omerkaraoglu/3D-Print-Annealer/Outputs/3D Model/board.png

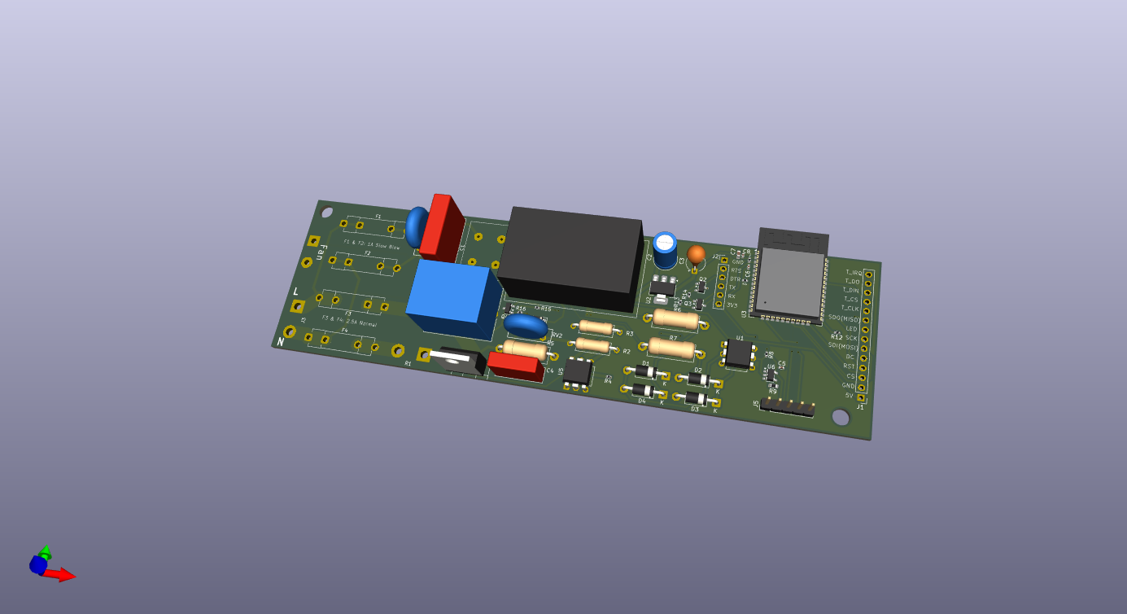
Outputs/3D Model/board.png
