omerkaraoglu/3D-Print-Annealer/CAD/Conceptual/AnnealX-ConceptualSketch.step

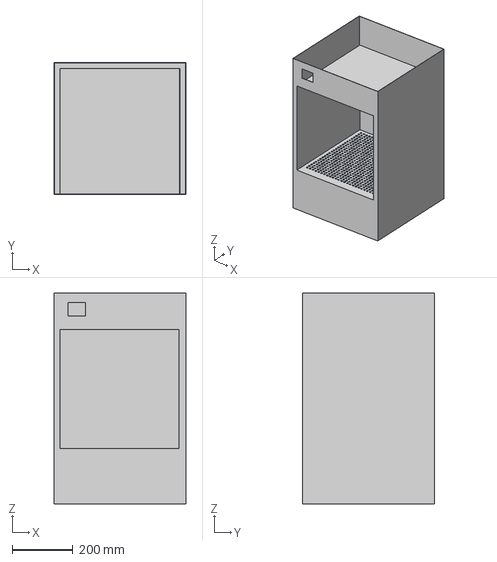
[picture p2: CAD file, 2026-06-10]
CAD/Conceptual/AnnealX-ConceptualSketch.step
432.0 x 432.0 x 692.0 mm
