omerkaraoglu/3D-Print-Annealer/KiCad/ComponentsLibrary/ESP32-C3-MINI-1-N4/ESP32-C3-MINI-1-N4.step

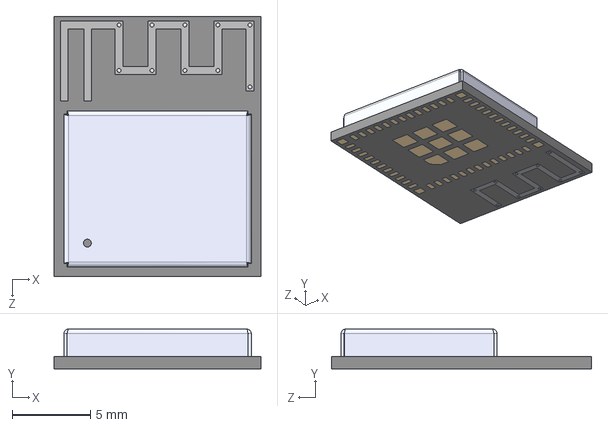
[picture p3: CAD file, 2026-03-03]
KiCad/ComponentsLibrary/ESP32-C3-MINI-1-N4/ESP32-C3-MINI-1-N4.step
13.2 x 2.55 x 16.6 mm
