omerkaraoglu/3D-Print-Annealer/Outputs/3D Model/3D_Model.step

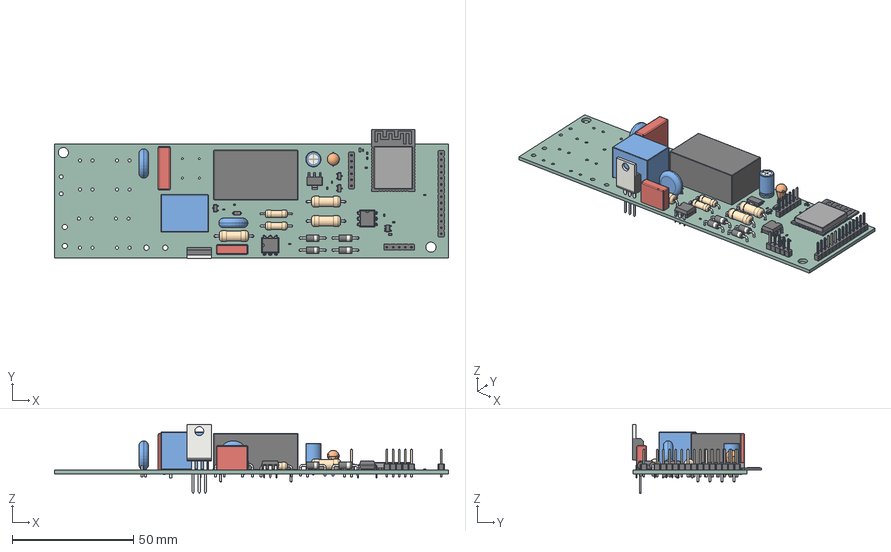
[picture p4: CAD file, 2026-03-04]
Outputs/3D Model/3D_Model.step
162.5 x 53.1 x 28.5 mm
R_0402_1005Metric x 9
PinHeader_1x05_P2.54mm_Vertical
SOT-23
R_Axial_DIN0414_L11.9mm_D4.5mm_P15.24mm_Horizontal x 3
Relay_SPDT_SANYOU_SRD_Series_Form_C
DIP-6_W7.62mm x 2
RV_Disc_D12mm_W3.9mm_P7.5mm x 2
SOT-23-5
D_DO-41_SOD81_P10.16mm_Horizontal x 4
D_SOD-123
C_0402_1005Metric x 3
R_Axial_DIN0309_L9.0mm_D3.2mm_P12.70mm_Horizontal x 2
TO-220-3_Vertical
PinHeader_1x06_P2.54mm_Vertical
SOT-23-3 x 2
ESP32-WROOM-32E
C_Rect_L13.0mm_W4.0mm_P10.00mm_FKS3_FKP3_MKS4
PinHeader_1x14_P2.54mm_Vertical
R_0603_1608Metric
C_0603_1608Metric
CP_Radial_Tantal_D5.0mm_P5.00mm
C_Rect_L18.0mm_W5.0mm_P15.00mm_FKS3_FKP3
Converter_ACDC_Hi-Link_HLK-PMxx
C_Radial_D6.3mm_H11.0mm_P2.50mm
SOT-223
3dFilamentDryer_PCB
