omerkaraoglu/3D-Print-Annealer/KiCad/3dFilamentDryer/3dFilamentDryer.kicad_pcb

## KiCad design KiCad/3dFilamentDryer/3dFilamentDryer.kicad_pcb (2026-06-10)

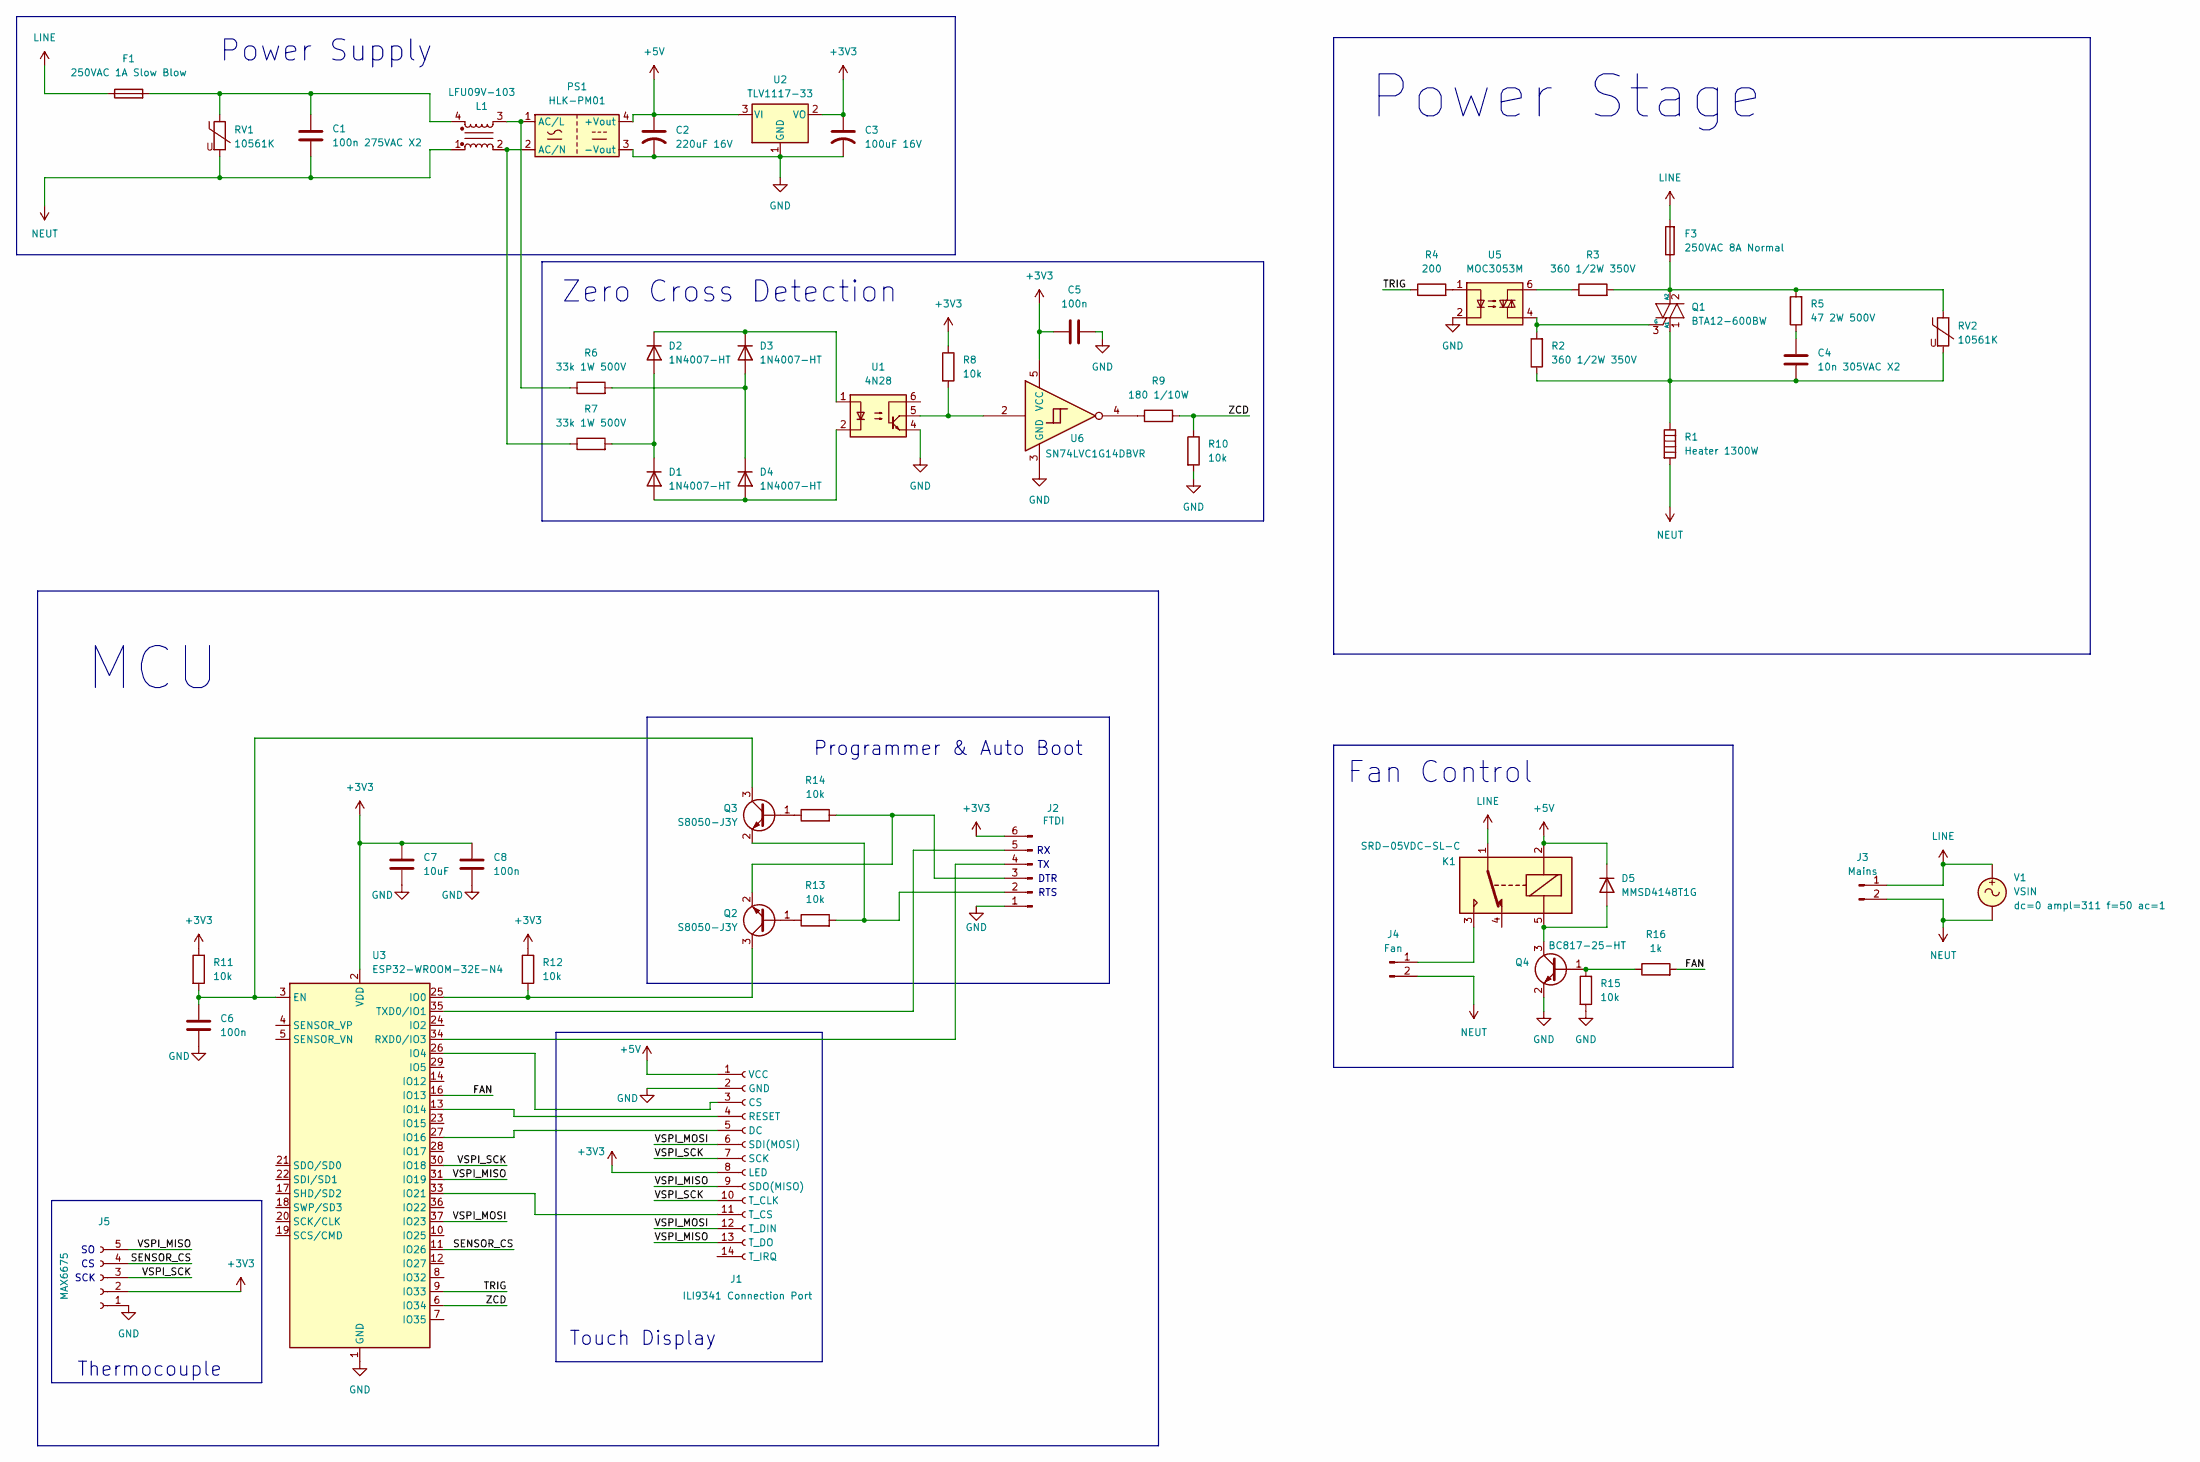
[picture p16: schematic 3dFilamentDryer.kicad_sch, 3D Printer Filament Dryer & Print Annealer]

Parts:
C1: 100n 275VAC X2; C_Rect_L18.0mm_W5.0mm_P15.00mm_FKS3_FKP3
C2: 220uF 16V; C_Radial_D6.3mm_H11.0mm_P2.50mm
C3: 100uF 16V; CP_Radial_Tantal_D5.0mm_P5.00mm
C4: 10n 305VAC X2; C_Rect_L13.0mm_W4.0mm_P10.00mm_FKS3_FKP3_MKS4
C5, C6, C8: 100n; C_0402_1005Metric
C7: 10uF; C_0603_1608Metric
D1, D2, D3, D4: 1N4007-HT; D_DO-41_SOD81_P10.16mm_Horizontal
D5: MMSD4148T1G; D_SOD-123
F1: 250VAC 1A Slow Blow; Fuseholder_Clip-5x20mm_Littelfuse_445-030_Inline_P20.50x5.2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
F3: 250VAC 8A Normal; Fuseholder_Clip-5x20mm_Littelfuse_445-030_Inline_P20.50x5.2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
J1: ILI9341 Connection Port; PinHeader_1x14_P2.54mm_Vertical
J2: FTDI; PinHeader_1x06_P2.54mm_Vertical
J3: Mains; SolderWire-1.5sqmm_1x02_P7.8mm_D1.7mm_OD3.9mm
J4: Fan; SolderWire-0.75sqmm_1x02_P7mm_D1.25mm_OD3.5mm
J5: MAX6675; PinHeader_1x05_P2.54mm_Vertical
K1: SRD-05VDC-SL-C; Relay_SPDT_SANYOU_SRD_Series_Form_C
L1: LFU09V-103
PS1: HLK-PM01; Converter_ACDC_Hi-Link_HLK-PMxx
Q1: BTA12-600BW; TO-220-3_Vertical
Q2, Q3: S8050-J3Y; SOT-23-3
Q4: BC817-25-HT; SOT-23
R1: Heater 1300W; SolderWire-1.5sqmm_1x02_P7.8mm_D1.7mm_OD3.9mm
R2, R3: 360 1/2W 350V; R_Axial_DIN0309_L9.0mm_D3.2mm_P12.70mm_Horizontal
R4: 200; R_0402_1005Metric
R5: 47 2W 500V; R_Axial_DIN0414_L11.9mm_D4.5mm_P15.24mm_Horizontal
R6, R7: 33k 1W 500V; R_Axial_DIN0414_L11.9mm_D4.5mm_P15.24mm_Horizontal
R8, R10, R11, R12, R13, R14, R15: 10k; R_0402_1005Metric
R9: 180 1/10W; R_0603_1608Metric
R16: 1k; R_0402_1005Metric
RV1, RV2: 10561K; RV_Disc_D12mm_W3.9mm_P7.5mm
U1: 4N28; DIP-6_W7.62mm
U2: TLV1117-33; SOT-223-3_TabPin2
U3: ESP32-WROOM-32E-N4; ESP32-WROOM-32E
U5: MOC3053M; DIP-6_W7.62mm
U6: SN74LVC1G14DBVR; SOT-23-5
V1: VSIN

Connections:
+3V3: C3.1, C5.1, C7.1, C8.2, J1.8 (LED), J2.6, J5.2, R8.1, R11.1, R12.1, U2.2 (VO), U3.2 (VDD), U6.5 (VCC)
+5V: C2.1, D5.1 (K), J1.1 (VCC), K1.2, PS1.4 (+Vout), U2.3 (VI)
/FAN: R16.2, U3.16 (IO13)
/SENSOR_CS: J5.4, U3.11 (IO26)
/TRIG: R4.1, U3.9 (IO33)
/VSPI_MISO: J1.9 (SDO(MISO)), J1.13 (T_DO), J5.5, U3.31 (IO19)
/VSPI_MOSI: J1.6 (SDI(MOSI)), J1.12 (T_DIN), U3.37 (IO23)
/VSPI_SCK: J1.7 (SCK), J1.10 (T_CLK), J5.3, U3.30 (IO18)
/ZCD: R9.2, R10.1, U3.6 (IO34)
GND: C2.2, C3.2, C5.2, C6.1, C7.2, C8.1, J1.2 (GND), J2.1, J5.1, PS1.3 (-Vout), Q4.2 (E), R10.2, R15.2, U1.4, U2.1 (GND), U3.1 (GND), U3.15 (GND), U3.38 (GND), U3.39 (GND), U5.2, U6.3 (GND)
LINE: F1.1, F3.2, J3.1, K1.1, V1.1
NEUT: C1.2, J3.2, J4.2, L1.1, R1.2, RV1.2, V1.2
unnamed: C1.1, F1.2, L1.4, RV1.1
unnamed: C4.1, R5.1
unnamed: D1.2 (A), D4.2 (A), U1.2
unnamed: D1.1 (K), D2.2 (A), R7.2
unnamed: D2.1 (K), D3.1 (K), U1.1
unnamed: D3.2 (A), D4.1 (K), R6.2
unnamed: D5.2 (A), K1.5, Q4.3 (C)
unnamed: J1.3 (CS), U3.26 (IO4)
unnamed: J1.5 (DC), U3.27 (IO16)
unnamed: J1.4 (RESET), U3.13 (IO14)
unnamed: J1.11 (T_CS), U3.33 (IO21)
unnamed: J2.2, Q3.2 (E), R13.2
unnamed: J2.3, Q2.2 (E), R14.2
unnamed: J2.4, U3.34 (RXD0/IO3)
unnamed: J2.5, U3.35 (TXD0/IO1)
unnamed: J4.1, K1.3
unnamed: L1.3, PS1.1 (AC/L), R6.1
unnamed: L1.2, PS1.2 (AC/N), R7.1
unnamed: C4.2, Q1.1 (A1), R1.1, R2.1, RV2.2
unnamed: F3.1, Q1.2 (A2), R3.2, R5.2, RV2.1
unnamed: Q1.3 (G), R2.2, U5.4
unnamed: Q2.1 (B), R13.1
unnamed: Q2.3 (C), R12.2, U3.25 (IO0)
unnamed: Q3.1 (B), R14.1
unnamed: C6.2, Q3.3 (C), R11.2, U3.3 (EN)
unnamed: Q4.1 (B), R15.1, R16.1
unnamed: R3.1, U5.6
unnamed: R4.2, U5.1
unnamed: R8.2, U1.5, U6.2
unnamed: R9.1, U6.4

Notes on the sheet:
Power Stage
Programmer & Auto Boot
SCK
RTS
Thermocouple
Power Supply
Touch Display
Fan Control
Zero Cross Detection
MCU
DTR

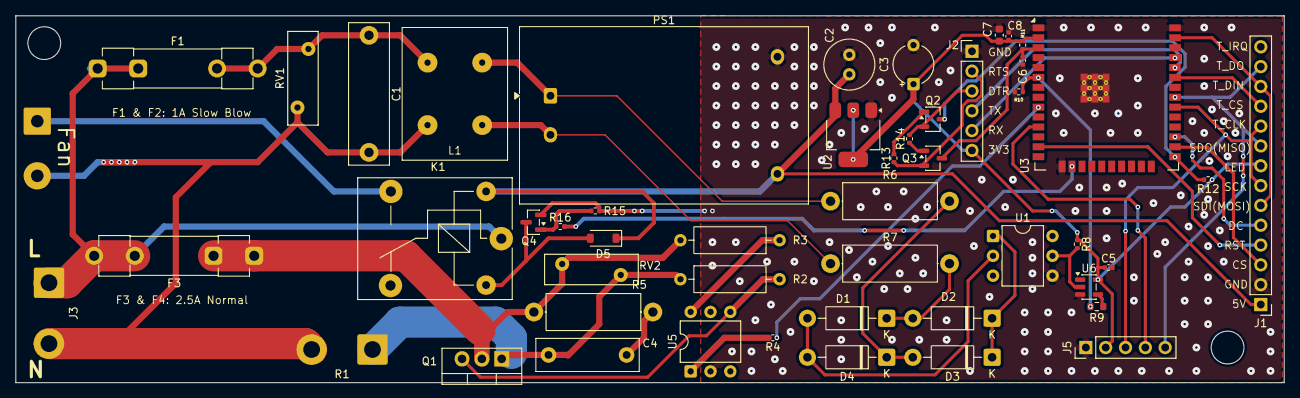
[picture p17: board 3dFilamentDryer.kicad_pcb from above]

Board: 2 copper layers, 162.5 x 47.0 mm, 50 parts (1 on the bottom side), 42 nets.
