omerkaraoglu/3D-Print-Annealer/Firmware/Arduino/AnnealerFirmware/AnnealerFirmware.ino/AnnealerFirmware.ino.ino

/*
 * ══════════════════════════════════════════════════════════════════
 *  Advanced 3D-Print Annealer — Firmware with LVGL Touchscreen UI
 *  ESP32 / Arduino Core 3.x / LVGL v8.4 / TFT_eSPI
 * ══════════════════════════════════════════════════════════════════
 *
 *  Hardware (shared VSPI bus: SCK=18, MOSI=23, MISO=19):
 *    ILI9341 display  CS=15  DC=2  RST=4
 *    XPT2046 touch    CS=21
 *    MAX6675 thermo   CS=13   (SCK+MISO shared)
 *    Triac gate       IO33
 *    ZCD input        IO34
 *
 *  External library configuration required:
 *    - TFT_eSPI/User_Setup.h  : ILI9341, SCK=18, MOSI=23, MISO=19,
 *                               CS=15, DC=2, RST=4
 *    - lvgl/lv_conf.h         : LV_COLOR_DEPTH=16, enable LV_USE_*
 *
 *  The original serial command interface is preserved verbatim
 *  (TUNE / LEARN / SET / RAMP / PROFILE: / LAMBDA / PLANT).
 *  The touchscreen calls the same internal code paths.
 *
 *  Screenshot capture for product photography:
 *    SHOT       — dump the currently-displayed screen over serial.
 *    SHOT ALL   — cycle every built screen, dumping each.
 *    Decode with ../screenshot.py (pyserial + Pillow). See that
 *    file's docstring for the full workflow.
 * ══════════════════════════════════════════════════════════════════ */

#include <SPI.h>
#include <Preferences.h>
#include <TFT_eSPI.h>
#include <lvgl.h>
#include <XPT2046_Touchscreen.h>
#include <WiFi.h>
#include <WiFiClientSecure.h>
#include "esp32_cert_bundle.h"
#include <HTTPClient.h>
#include <HTTPUpdate.h>

LV_FONT_DECLARE(lv_font_inter_12);
LV_FONT_DECLARE(lv_font_inter_14);
LV_FONT_DECLARE(lv_font_inter_16);
LV_FONT_DECLARE(lv_font_inter_24);

// ---- OTA / WiFi configuration -------------------------------------------
// Bump this every time you build a new firmware. The check compares this
// against the "version" field of the server's JSON manifest.
#define FIRMWARE_VERSION   "2.1.2"
// HTTP URL of the version manifest JSON. Plain HTTP is easiest; HTTPS works
// too if you switch to WiFiClientSecure and supply the server's root CA.
// Manifest format: { "version": "1.2.3", "url": "http://host/firmware.bin" }
#define OTA_MANIFEST_URL   "https://omerkaraoglu.github.io/3D-Print-Annealer/Firmware/OTA/version.json"

// We verify TLS using the ESP-IDF certificate bundle that arduino-esp32 v3.x
// links into the firmware. It contains ~150 common root CAs (DigiCert,
// Sectigo / USERTrust, Let's Encrypt / ISRG, GlobalSign, Amazon, …) — so we
// stay valid no matter which CA GitHub rotates to.
//
// The bundle binary is exposed by the build with this exact symbol name.
// If a future arduino-esp32 release renames it the linker will tell us.


// ══════════════════════════════════════════════════════════════════
//   SECTION 1 — PIN DEFINITIONS
// ══════════════════════════════════════════════════════════════════
#define TRIAC_PIN   33
#define ZCD_PIN     34
#define CS_PIN      13          // MAX6675 chip-select
#define FAN_PIN     12          // Fan relay
#define TOUCH_CS    21

#define SCREEN_W    320
#define SCREEN_H    240

// ══════════════════════════════════════════════════════════════════
//   SECTION 2 — HARDWARE OBJECTS
// ══════════════════════════════════════════════════════════════════
TFT_eSPI              tft = TFT_eSPI();
XPT2046_Touchscreen   ts(TOUCH_CS);
Preferences           preferences;

// ══════════════════════════════════════════════════════════════════
//   SECTION 3 — CONTROL GLOBALS (unchanged from original)
// ══════════════════════════════════════════════════════════════════
volatile float pid_output = 0.0;

#define MEDIAN_WINDOW 5
float temp_buffer[MEDIAN_WINDOW];
int   buffer_index = 0;
bool  buffer_filled = false;
float current_temp = 0.0;
const float EMA_ALPHA = 0.1;
unsigned long last_temp_read = 0;
unsigned long last_telemetry_time = 0;

#define SLOPE_WINDOW 60
float temp_history[SLOPE_WINDOW];
int   history_index = 0;
bool  history_filled = false;

#define POWER_BUFFER_SIZE 900
float power_history[POWER_BUFFER_SIZE];
int   power_history_index = 0;

unsigned long last_history_time = 0;
float current_slope = 0.0;
float predicted_temp = 0.0;

#define NCR_LUT_SIZE 37
float ncr_lut_heat[NCR_LUT_SIZE];
float ncr_saved_heat[NCR_LUT_SIZE];
float ncr_lut_cool[NCR_LUT_SIZE];
float ncr_saved_cool[NCR_LUT_SIZE];
float ncr_lin_heat[NCR_LUT_SIZE];
float ncr_lin_cool[NCR_LUT_SIZE];
bool  ncr_nvs_heat[NCR_LUT_SIZE];
bool  ncr_nvs_cool[NCR_LUT_SIZE];

// Raw learned NCR from prototype_1 sweep (20..200 °C, 5 °C steps)
// Buckets without learned data use 0 so linearizeNCR() will interpolate them
static const float NCR_DEFAULT_HEAT[NCR_LUT_SIZE] = {
  0.000000f, 0.000536f, 0.002452f, 0.005874f, 0.003987f, 0.005721f, 0.009235f, 0.010331f,
  0.009895f, 0.012373f, 0.011361f, 0.015502f, 0.011804f, 0.017765f, 0.018578f, 0.022075f,
  0.023933f, 0.019671f, 0.023189f, 0.027764f, 0.022931f, 0.026879f, 0.025739f, 0.027236f,
  0.030697f, 0.032321f, 0.030131f, 0.028257f, 0.031236f, 0.029625f, 0.030799f, 0.032442f,
  0.030475f, 0.032322f, 0.029798f, 0.036016f, 0.000000f,
};
static const float NCR_DEFAULT_COOL[NCR_LUT_SIZE] = {
  0.000000f, 0.007521f, 0.000000f, 0.000000f, 0.000000f, 0.003718f, 0.010883f, 0.010430f,
  0.013222f, 0.013421f, 0.000000f, 0.015848f, 0.017784f, 0.021740f, 0.019994f, 0.000000f,
  0.024905f, 0.000000f, 0.028881f, 0.027218f, 0.000000f, 0.000000f, 0.000000f, 0.000000f,
  0.000000f, 0.000000f, 0.000000f, 0.000000f, 0.000000f, 0.000000f, 0.000000f, 0.000000f,
  0.000000f, 0.000000f, 0.000000f, 0.000000f, 0.000000f,
};

int   ncr_active_bucket = -1;
float ncr_prev_ema = 0.0;
unsigned long ncr_stable_start_ms = 0;

float setpoint = 20.0;
float current_setpoint = 20.0;
float ramp_rate_per_sec = 0.0;
bool  is_ramping = false;

float error_integral = 0.0;
float Kc = 1.0, Ti = 100.0;
bool  flatThresholdFlag = 1;
bool  prev_flat_flag = false;

int   tune_state = 0;
float tune_start_temp = 0.0;
unsigned long tune_start_time_ms = 0;
float temp_at_theta = 0.0;
unsigned long time_at_theta_ms = 0;
float tune_step_power = 0.3;

float mpc_tau_c = 40.0f;         // Desired time constant in seconds. Lower = more aggressive climb.
float mpc_error_integral = 0.0f; // Stores the disturbance correction
float mpc_Ki = 0.005f;           // Very weak gain, strictly for fixing model mismatch at steady-state

int   learn_state = 0;
int   learn_target_bucket = 0;
int   learn_start_bucket = 0;
float learn_room_temp = 20.0;
float learn_stable_temp = 20.0;
unsigned long learn_stable_start_ms = 0;
unsigned long learn_observe_start_ms = 0;
float learn_ncr_snapshot = 0.0;

#define LEARN_OBS_WINDOW 90
float learn_obs_temps[LEARN_OBS_WINDOW];
int   learn_obs_count = 0;
float learn_prev_fitted_slope = 0.0;
unsigned long learn_obs_last_sample_ms = 0;

#define PROFILE_MAX_STEPS 16
struct ProfileStep {
  bool is_ramp;
  float target;
  float rate_per_sec;
  unsigned long hold_sec;
};
ProfileStep profile_steps[PROFILE_MAX_STEPS];
int   profile_step_count = 0;
int   profile_current_step = 0;
int   profile_state = 0;
unsigned long profile_hold_start_ms = 0;
// For the final cooldown step: time at which current_temp first entered the
// 20–40 °C "ambient" band while still waiting for arrival. Reset to 0 the
// instant it leaves the band. Once 30 min in-band has elapsed we accept
// that the oven won't cool any further and declare the step complete.
unsigned long profile_ambient_stable_since_ms = 0;
#define PROFILE_AMBIENT_BAND_LO  20.0f
#define PROFILE_AMBIENT_BAND_HI  40.0f
#define PROFILE_AMBIENT_WAIT_MS  (30UL * 60UL * 1000UL)
unsigned long profile_start_ms = 0;
unsigned long profile_plot_last_ms = 0;

float plant_K = 0.0;
float plant_tau = 0.0;
float plant_theta = 0.0;
float lambda_val = 3.0;

// ══════════════════════════════════════════════════════════════════
//   SECTION 4 — UI GLOBALS + COLOR PALETTE
// ══════════════════════════════════════════════════════════════════
// Themed-button role (declared here so Arduino's auto-generated
// prototypes at the top of the .ino can see the type).
enum BtnRole { ROLE_PRIMARY, ROLE_SECONDARY, ROLE_SUCCESS, ROLE_DANGER, ROLE_NEUTRAL, ROLE_AMBER };

// Professional dark palette — used throughout every screen.
#define CLR_BG        0x0B1118
#define CLR_TOP_BAR   0x101010
#define CLR_PANEL     0x141B24
#define CLR_PANEL2    0x1C2530
#define CLR_BORDER    0x2C3540
#define CLR_GRID      0x222C38
#define CLR_TXT       0xDCE3EA
#define CLR_TXT_DIM   0x7A8896
#define CLR_TXT_FAINT 0x4A5666
#define CLR_ACCENT    0x00B4C8   // teal — primary
#define CLR_ACCENT_D  0x00788B   // dark teal — pressed / secondary accent
#define CLR_AMBER     0xE8A83C
#define CLR_AMBER_D   0x6A4A10
#define CLR_DANGER    0xD04848
#define CLR_DANGER_D  0x6A2020
#define CLR_SUCCESS   0x3CA656
#define CLR_SUCCESS_D 0x204A2A
#define CLR_NEUTRAL   0x3A4554
#define CLR_PLANNED   0x6FC5D4   // planned-trajectory line (light teal)
#define CLR_ACTUAL    0xE8A83C   // actual-temp line (amber)

// LVGL display buffers (20-line double buffer)
static lv_disp_draw_buf_t lvDrawBuf;
static lv_color_t lvBuf1[SCREEN_W * 20];
static lv_color_t lvBuf2[SCREEN_W * 20];

// Touch calibration (fallback defaults, stored in NVS)
int16_t ts_min_x = 300, ts_max_x = 3800;
int16_t ts_min_y = 300, ts_max_y = 3800;

// Graph — 120 samples. Rolling 60-min history in idle mode (30 s/sample),
// time-based planned-vs-actual overlay in profile mode.
#define GRAPH_SAMPLES   120
#define GRAPH_PERIOD_MS 30000UL
unsigned long last_graph_sample_ms = 0;

// Planned trajectory (precomputed on profile start)
float profile_planned[GRAPH_SAMPLES];
float profile_total_duration_s = 0.0f;
bool  profile_has_plan = false;
int   profile_last_slot_filled = -1;

// Raised by the control code when a profile completes naturally; consumed
// by ui_update() the next time it runs so the popup is created from the
// LVGL / UI context, not from inside the PID step.
volatile bool profile_completed_popup_pending = false;

// Screens
static lv_obj_t *scrMain          = NULL;
static lv_obj_t *scrMaterial      = NULL;
static lv_obj_t *scrHousehold     = NULL;
static lv_obj_t *scrEngineer      = NULL;
static lv_obj_t *scrCustom        = NULL;
static lv_obj_t *scrCustomDetail  = NULL;
static lv_obj_t *scrBuilder       = NULL;
static lv_obj_t *scrAddType       = NULL;
static lv_obj_t *scrKeypad        = NULL;
static lv_obj_t *scrSettings      = NULL;
static lv_obj_t *scrCalibrate     = NULL;
static lv_obj_t *scrRename        = NULL;
static lv_obj_t *scrWifi          = NULL;
static lv_obj_t *scrOTA           = NULL;
static lv_obj_t *barOTA           = NULL;
static lv_obj_t *lblOTAStatus     = NULL;
static lv_obj_t *lblOTAVersions   = NULL;

// ── Screenshot subsystem ────────────────────────────────────────────
// USB-CDC framebuffer dump for marketing/website shots. Triggered by the
// SHOT (current screen) or SHOT ALL (cycle every screen) serial command.
// While active, my_disp_flush mirrors every tile out the serial port as
// text-framed binary (RGB565 LE, matches LV_COLOR_DEPTH=16). A host
// Python tool reassembles tiles into PNGs.
// Wire-format example for one frame:
//   <<SHOT_BEGIN w=320 h=240 fmt=rgb565_le name=main>>\r\n
//   <<SHOT_TILE x=0 y=0 w=320 h=20 bytes=12800>>\r\n
//   <12800 raw bytes>\r\n
//   ...more tiles...
//   <<SHOT_END>>\r\n
static volatile bool g_shot_active = false;
// Forward declarations — Arduino's prototype generator skips `static`
// functions, and handleCommand() calls into the capture helper that's
// defined further down the file.
static const char *current_screen_name();
static void        screenshot_capture_current();

// WiFi credentials — persisted in the "wifi" NVS namespace.
static char   wifi_ssid[33] = "";
static char   wifi_pass[65] = "";
static bool   wifi_connected_flag = false;

// Scan results — stage-1 list picker.
#define WIFI_SCAN_MAX     24
#define WIFI_LIST_VISIBLE 8                 // rows shown at once on screen
struct WifiScanEntry {
  char    ssid[33];
  int8_t  rssi;
  uint8_t enc;
};
static WifiScanEntry wifi_scan_results[WIFI_SCAN_MAX];
static int  wifi_scan_count       = 0;
static int  wifi_sel_idx          = 0;     // highlighted row (display-list index)
static int  wifi_list_top         = 0;     // first visible row (display-list index)
static bool wifi_scan_in_progress = false;

// Saved networks — multiple credentials stored in the "wifi" NVS namespace.
// On boot the first slot is also copied into wifi_ssid/wifi_pass so the
// auto-reconnect path keeps working unchanged.
#define SAVED_NET_MAX 8
struct SavedNetwork {
  char ssid[33];
  char pass[65];
};
static SavedNetwork saved_nets[SAVED_NET_MAX];
static int saved_net_count = 0;

// Merged display list: saved networks first (always shown, with in_range
// flagged), then scan-only entries deduped against saved by SSID.
#define WIFI_DISPLAY_MAX (WIFI_SCAN_MAX + SAVED_NET_MAX)
struct WifiDisplayEntry {
  const char *ssid;     // points at either saved_nets[].ssid or wifi_scan_results[].ssid
  bool        is_saved;
  bool        in_range;
  int8_t      rssi;
};
static WifiDisplayEntry wifi_display[WIFI_DISPLAY_MAX];
static int wifi_display_count = 0;

// Stage-1 (SSID list) widgets — three labels per row: saved icon / SSID / signal.
static lv_obj_t *wifiListRow[WIFI_LIST_VISIBLE]    = { NULL };
static lv_obj_t *wifiListLabel[WIFI_LIST_VISIBLE]  = { NULL };
static lv_obj_t *lblWifiSaved[WIFI_LIST_VISIBLE]   = { NULL };
static lv_obj_t *lblWifiSignal[WIFI_LIST_VISIBLE]  = { NULL };
static lv_obj_t *lblWifiNoResults = NULL;
static lv_obj_t *lblWifiStatus    = NULL;
static lv_obj_t *lblWifiTitle     = NULL;   // doubles as a live status banner

// Connection-attempt state machine. Drives the status banner and decides
// when to bounce the user to the password screen for a retry.
enum WifiConnState { WCS_IDLE, WCS_TRYING, WCS_OK, WCS_FAILED };
static WifiConnState wifi_conn_state           = WCS_IDLE;
static unsigned long wifi_conn_start_ms        = 0;
static unsigned long wifi_conn_state_changed_ms = 0;
static char          wifi_conn_ssid[33]        = "";
#define WIFI_CONN_TIMEOUT_MS 12000UL
#define WIFI_CONN_OK_HOLD_MS  3000UL

// Pass-screen retry banner.
static bool          wifi_retry_due_to_fail    = false;
static lv_obj_t     *lblWifiPassRetry          = NULL;

// Stage-2 (password) screen + widgets.
static lv_obj_t *scrWifiPass         = NULL;
static lv_obj_t *wifiTA_pass         = NULL;
static lv_obj_t *wifiPassKB          = NULL;
static lv_obj_t *lblWifiPassNetwork  = NULL;

// OTA dialog is raised from the UI thread once the boot-time check finds
// a newer version on the server.
static volatile bool ota_prompt_pending = false;
bool execute_ota_update_now = false;
static char  ota_remote_version[24] = "";
static char  ota_download_url[256]  = "";
static lv_obj_t *scrFullGraph     = NULL;

// Fullscreen-graph widgets (mirror of the main chart)
static lv_obj_t *chartFull        = NULL;
static lv_chart_series_t *serTempFull = NULL;
static lv_chart_series_t *serSPFull   = NULL;
#define FULL_X_MAX_LABELS 7
static lv_obj_t *lblFullX[FULL_X_MAX_LABELS] = { NULL };
#define FULL_Y_LABELS 6
static lv_obj_t *lblFullY[FULL_Y_LABELS]     = { NULL };
static lv_obj_t *lblFullTitle     = NULL;

// Index of the saved profile currently being edited in the builder (-1 = new).
static int       builder_editing_idx = -1;
static lv_obj_t *lblBuilderTitle     = NULL;

// Calibration state machine (4 corners, top-left → top-right → bottom-right → bottom-left)
static int      cal_step = 0;          // 0..3 in progress, -1 idle
static int16_t  cal_raw_x[4];
static int16_t  cal_raw_y[4];
static bool     cal_was_touched = false;
static int16_t  cal_last_raw_x = 0, cal_last_raw_y = 0;
static lv_obj_t *calCrosshair = NULL;
static lv_obj_t *lblCalPrompt = NULL;
static lv_timer_t *calTimer   = NULL;
// Target pixel positions for each corner (10 px inset from edges)
static const lv_point_t CAL_TARGETS[4] = {
  { 10, 10 }, { 309, 10 }, { 309, 229 }, { 10, 229 }
};

// Main-screen widgets
static lv_obj_t *arcTemp          = NULL;
static lv_obj_t *lblTempVal       = NULL;
static lv_obj_t *lblSetpoint      = NULL;
static lv_obj_t *lblMode          = NULL;
static lv_obj_t *chartHist        = NULL;
static lv_chart_series_t *serTemp = NULL;
static lv_chart_series_t *serSP   = NULL;
// Up to 4 main-page X-axis labels, dynamically repositioned based on total
// minutes so that visible labels are always multiples of 10.
#define MAIN_X_MAX_LABELS 4
static lv_obj_t *lblXAxis[MAIN_X_MAX_LABELS] = { NULL };
static lv_obj_t *btnProfile       = NULL;
static lv_obj_t *lblBtnProfile    = NULL;
static lv_obj_t *btnStartStop     = NULL;
static lv_obj_t *lblBtnStart      = NULL;
static lv_obj_t *lblGaugeWarn     = NULL;   // blinking ⚠ glyph on the gauge panel
static bool      blink_phase      = false;
static lv_timer_t *blinkTimer     = NULL;

// Engineering-list widgets (paged)
static lv_obj_t *lblEngTitle      = NULL;
static lv_obj_t *btnEngEntry[3];
static lv_obj_t *lblEngEntry[3];
static int       eng_page = 0;
#define ENG_PER_PAGE 3

// Saved custom profiles — persisted in NVS
#define PROFILE_NAME_LEN 32
#define SAVED_CUSTOM_MAX 16
struct SavedCustom {
  char  name[PROFILE_NAME_LEN];
  int   step_count;
  ProfileStep steps[PROFILE_MAX_STEPS];
};
SavedCustom saved_customs[SAVED_CUSTOM_MAX];
int         saved_custom_count = 0;
int         custom_detail_idx  = -1;   // index of profile on scrCustomDetail

// Rename screen widgets
static lv_obj_t *renameTA         = NULL;
static lv_obj_t *renameKB         = NULL;
static lv_obj_t *lblRenameTitle   = NULL;
static int       rename_target_idx   = -1;    // slot being renamed (or -1 for a new save)
static bool      rename_save_builder = false; // true = commit current builder_steps on Save
static char      rename_default_name[PROFILE_NAME_LEN] = "";

// Saved-custom LIST widgets
static lv_obj_t *lblCustomTitle   = NULL;
static lv_obj_t *btnCustomEntry[3];
static lv_obj_t *lblCustomEntry[3];
static int       custom_list_page = 0;

// Builder widgets (editing a new custom profile before saving)
#define BUILDER_PER_PAGE 4
static lv_obj_t *lblBuilderEmpty  = NULL;
static lv_obj_t *btnBuilderEntry[BUILDER_PER_PAGE] = { NULL };
static lv_obj_t *lblBuilderEntry[BUILDER_PER_PAGE] = { NULL };
static lv_obj_t *lblBuilderPage   = NULL;
static int       builder_page = 0;
ProfileStep      builder_steps[PROFILE_MAX_STEPS];
int              builder_step_count = 0;

// -1 = we're ADDING a new step; >=0 = we're EDITING the step at this index.
// Used by the keypad/commit/finalize chain to decide append-vs-overwrite.
static int       editing_step_idx = -1;

// Custom-detail widgets
static lv_obj_t *lblDetailTitle   = NULL;
static lv_obj_t *lblDetailBody    = NULL;

// Add-step / keypad state
enum AddKind { ADD_NONE, ADD_RAMP, ADD_SET };
static AddKind add_kind = ADD_NONE;
static int     add_field_idx = 0;
static float   add_tmp_values[3];

// Keypad
static lv_obj_t *lblKeypadPrompt = NULL;
static lv_obj_t *lblKeypadEntry  = NULL;
static char      keypad_buf[16] = "";

// Currently-selected profile (any source — predef or saved custom)
char  selected_profile_name[PROFILE_NAME_LEN] = "";
bool  profile_is_selected = false;
int   selected_custom_idx = -1;   // -1 unless selected profile is a saved custom

// ══════════════════════════════════════════════════════════════════
//   SECTION 5 — PREDEFINED MATERIAL PROFILES
//   Translated directly from the user's table:
//     RAMP <target C> <rate C/min> <hold min>
//     SET  <target C>            <hold min>
// ══════════════════════════════════════════════════════════════════
struct PredefProfile {
  const char *name;
  int step_count;
  ProfileStep steps[8];
};

// Physical rate caps imposed by the oven hardware. Any predefined profile
// step that would exceed these gets clamped to the cap below; SET steps
// that ask for an instantaneous jump are replaced by a RAMP at the cap.
#define MAX_HEATING_RATE_C_PER_MIN  3.35f
#define MAX_COOLING_RATE_C_PER_MIN  1.89f

// rate_per_sec = C_per_min / 60  ;  hold_sec = hold_min * 60
#define R(tgt, rpm, hm) { true,  (float)(tgt), (float)(rpm)/60.0f, (unsigned long)((hm)*60UL) }

// Every SET has been rewritten as a RAMP at the matching hardware cap.
// Rates up to 3.35 °C/min for heating and 1.89 °C/min for cooling.
static const PredefProfile HOUSEHOLD_PROFILES[] = {
  // PLA  — ambient → 90, hold 2 h, back to 22
  { "PLA",  2, { R( 90, 3.35, 120), R(22, 1.89,   0) } },
  // PETG — ambient → 90, hold 3 h, back to 22
  { "PETG", 2, { R( 90, 3.35, 180), R(22, 1.89,   0) } },
};
static const int HOUSEHOLD_COUNT = sizeof(HOUSEHOLD_PROFILES)/sizeof(HOUSEHOLD_PROFILES[0]);

static const PredefProfile ENGINEERING_PROFILES[] = {
  { "Polypropylene (PP)", 3,
    { R( 60, 2.00,  25), R(110, 2.50, 240), R(22, 0.80,   0) } },
  // PA12 — original recipe asked for 7.0 °C/min; clamped to the heating cap.
  { "Nylon PA12 / PA12-CF", 2,
    { R(150, 3.35, 360), R( 22, 1.00,   0) } },
  { "Nylon PA6-CF / PA6-GF", 3,
    { R( 80, 2.00,  30), R(120, 2.00, 480), R(22, 1.00,   0) } },
  { "Polycarbonate (PC)", 3,
    { R( 60, 2.00,  20), R( 90, 2.00, 120), R(22, 0.65,   0) } },
  { "PET-CF", 3,
    { R( 90, 2.30,  60), R(120, 2.00, 600), R(22, 0.90,   0) } },
  { "PEEK", 3,
    { R(150, 1.00,  60), R(200, 1.00, 120), R(22, 0.167,  0) } },
  { "PPS / PPS-CF", 3,
    { R( 80, 2.00,  60), R(130, 2.00, 180), R(22, 1.00,   0) } },
  // PEI 9085 — middle SET 93 replaced with a cooling ramp at the cap.
  { "PEI / ULTEM 9085", 4,
    { R(121, 3.30,  60), R(149, 2.00,  60), R(93, 1.89,  30), R(22, 0.80, 0) } },
  // PEI 1010 — middle SET 149 replaced with a cooling ramp at the cap.
  { "PEI / ULTEM 1010", 4,
    { R(149, 3.30,  60), R(200, 2.00,  60), R(149, 1.89, 30), R(22, 0.80, 0) } },
  // PAHT-CF — initial SET 80 replaced with a heating ramp at the cap.
  { "PAHT-CF", 2,
    { R( 80, 3.35, 720), R( 22, 1.00,   0) } },
};
static const int ENG_COUNT = sizeof(ENGINEERING_PROFILES)/sizeof(ENGINEERING_PROFILES[0]);

#undef R

// ══════════════════════════════════════════════════════════════════
//   SECTION 6 — HELPERS
// ══════════════════════════════════════════════════════════════════
float getActiveNCR(int bucket) {
  if (bucket < 0) bucket = 0;
  if (bucket >= NCR_LUT_SIZE) bucket = NCR_LUT_SIZE - 1;
  float diff = setpoint - current_temp;
  if (abs(diff) < 1.0f) {
    return (ncr_lin_heat[bucket] + ncr_lin_cool[bucket]) / 2.0f;
  } else if (diff > 0.0f) {
    return ncr_lin_heat[bucket];
  } else {
    return ncr_lin_cool[bucket];
  }
}

float steadyStateIntegral(float sp) {
  if (plant_K <= 0.0f || Kc <= 0.0f || Ti <= 0.0f) return 0.0f;
  int bucket = (int)((sp - 20.0f) / 5.0f);
  if (bucket < 0) bucket = 0;
  if (bucket >= NCR_LUT_SIZE) bucket = NCR_LUT_SIZE - 1;
  float ncr = getActiveNCR(bucket);
  return (ncr / plant_K) * (Ti / Kc);
}

void linearizeNCR(float* raw_saved, float* lin_out, const float* defaults, bool use_poly) {
  float xs[NCR_LUT_SIZE], ys[NCR_LUT_SIZE];
  int n = 0;
  for (int i = 0; i < NCR_LUT_SIZE; i++) {
    if (raw_saved[i] > 0.0f) {
      xs[n] = 20.0f + i * 5.0f;
      ys[n] = raw_saved[i];
      n++;
    }
  }
  if (n < 2) {
    for (int i = 0; i < NCR_LUT_SIZE; i++)
      lin_out[i] = (raw_saved[i] > 0.0f) ? raw_saved[i] : defaults[i];
    return;
  }

  if (use_poly && n >= 3) {
    // 2nd-degree polynomial: y = a*x^2 + b*x + c
    double sx = 0, sy = 0, sx2 = 0, sx3 = 0, sx4 = 0, sxy = 0, sx2y = 0;
    for (int i = 0; i < n; i++) {
      double x = xs[i], y = ys[i];
      sx += x; sy += y;
      sx2 += x*x; sx3 += x*x*x; sx4 += x*x*x*x;
      sxy += x*y; sx2y += x*x*y;
    }
    // Solve 3x3 normal equations via Cramer's rule
    double d0 = (double)n*(sx2*sx4 - sx3*sx3) - sx*(sx*sx4 - sx3*sx2) + sx2*(sx*sx3 - sx2*sx2);
    if (abs(d0) < 1e-20) {
      // Degenerate — fall through to linear
      use_poly = false;
    } else {
      double da = sy*(sx2*sx4 - sx3*sx3) - sx*(sxy*sx4 - sx2y*sx3) + sx2*(sxy*sx3 - sx2y*sx2);
      double db = (double)n*(sxy*sx4 - sx2y*sx3) - sy*(sx*sx4 - sx3*sx2) + sx2*(sx*sx2y - sxy*sx2);
      double dc = (double)n*(sx2*sx2y - sx3*sxy) - sx*(sx*sx2y - sxy*sx2) + sy*(sx*sx3 - sx2*sx2);
      double a = da / d0, b = db / d0, c = dc / d0;
      for (int i = 0; i < NCR_LUT_SIZE; i++) {
        double t = 20.0 + i * 5.0;
        float val = (float)(a + b * t + c * t * t);
        lin_out[i] = max(val, 0.001f);
      }
      return;
    }
  }

  // Linear fit: y = m*x + b
  float sum_x = 0, sum_y = 0, sum_xy = 0, sum_x2 = 0;
  for (int i = 0; i < n; i++) {
    sum_x += xs[i]; sum_y += ys[i];
    sum_xy += xs[i]*ys[i]; sum_x2 += xs[i]*xs[i];
  }
  float denom = n * sum_x2 - sum_x * sum_x;
  if (abs(denom) < 1e-9f) {
    for (int i = 0; i < NCR_LUT_SIZE; i++)
      lin_out[i] = (raw_saved[i] > 0.0f) ? raw_saved[i] : defaults[i];
    return;
  }
  float m = (n * sum_xy - sum_x * sum_y) / denom;
  float b = (sum_y - m * sum_x) / (float)n;
  for (int i = 0; i < NCR_LUT_SIZE; i++) {
    float val = m * (20.0f + i * 5.0f) + b;
    lin_out[i] = max(val, 0.001f);
  }
}

void saveLinearizedLUTs() {
  for (int i = 0; i < NCR_LUT_SIZE; i++) {
    char key[10];
    sprintf(key, "nlh_%d", i);
    preferences.putFloat(key, ncr_lin_heat[i]);
    sprintf(key, "nlc_%d", i);
    preferences.putFloat(key, ncr_lin_cool[i]);
    yield();
  }
}

float getMedian(float array[], int size) {
  float sorted[size];
  for (int i = 0; i < size; i++) sorted[i] = array[i];
  for (int i = 0; i < size - 1; i++) {
    for (int j = 0; j < size - i - 1; j++) {
      if (sorted[j] > sorted[j + 1]) {
        float t = sorted[j];
        sorted[j] = sorted[j + 1];
        sorted[j + 1] = t;
      }
    }
  }
  return sorted[size / 2];
}

// ══════════════════════════════════════════════════════════════════
//   SECTION 7 — ISR  (zero-crossing sigma-delta modulator)
//
//   The PID still produces pid_output ∈ [0,1] at 4 Hz. The main
//   loop converts that into a 16-bit fixed-point increment
//   (sd_increment, Q0.16) that the ISR uses with pure integer
//   math — ESP32 FPU instructions are unsafe in interrupt context
//   (per-task lazy save/restore corrupts on ISR-side FPU use).
//
//   Each full mains cycle we add sd_increment to sd_acc and fire
//   when it overflows 65536. Time-averaged firing density tracks
//   pid_output to 1/65536 ≈ 0.0015 %, far finer than the heater's
//   thermal time constant can resolve.
//
//   The decision is made once per full cycle (every other ZCD edge)
//   so each "on" decision conducts one positive + one negative half
//   — symmetric, no DC offset into transformer-fed loads.
// ══════════════════════════════════════════════════════════════════
volatile uint16_t sd_increment  = 0;
volatile uint32_t sd_acc        = 0;
volatile uint8_t  sd_half_idx   = 0;
volatile bool     sd_fire_cycle = false;

void IRAM_ATTR zcd_isr() {
  if (sd_half_idx == 0) {
    uint16_t inc = sd_increment;
    if (inc == 0) {
      sd_fire_cycle = false;
      sd_acc        = 0;
    } else {
      sd_acc += inc;
      sd_fire_cycle = (sd_acc >= 65536u);
      if (sd_fire_cycle) sd_acc -= 65536u;
    }
  }
  sd_half_idx ^= 1;

  if (sd_fire_cycle) {
    // Wait for line voltage to rise above the triac's latching threshold.
    // Firing exactly at the ZCD edge fails to latch: the optoisolator drops
    // out slightly before the true zero, and immediately after the zero
    // V_load ≈ 0 so I_load < I_L. 230 µs matches the minimum delay the
    // phase-angle firmware used and is well within a half-cycle.
    delayMicroseconds(230);
    digitalWrite(TRIAC_PIN, HIGH);
    delayMicroseconds(150);
    digitalWrite(TRIAC_PIN, LOW);
  }
}

// ══════════════════════════════════════════════════════════════════
//   SECTION 8 — MAX6675 via HARDWARE VSPI (transactional)
//   Replaces the old bit-banged MAX6675 library so that the same
//   VSPI bus can be shared with TFT_eSPI and XPT2046.
// ══════════════════════════════════════════════════════════════════
float readMAX6675() {
  SPI.beginTransaction(SPISettings(1000000, MSBFIRST, SPI_MODE0));
  digitalWrite(CS_PIN, LOW);
  delayMicroseconds(1);
  uint16_t raw = SPI.transfer16(0x0000);
  digitalWrite(CS_PIN, HIGH);
  SPI.endTransaction();
  if (raw & 0x04) return NAN;
  return (raw >> 3) * 0.25f;
}

// Forward declarations
void ui_init(void);
void ui_update(void);
void ui_show_messagebox(const char *title, const char *body,
                        const char *btn_ok, const char *btn_cancel,
                        lv_event_cb_t ok_cb);
void ui_show_alert(const char *title, const char *body);
void ui_show_info (const char *title, const char *body);
void ui_show_about(void);
void show_scrMain(void);
void show_scrMaterial(void);
void show_scrHousehold(void);
void show_scrEngineer(void);
void show_scrCustom(void);
void show_scrCustomDetail(int idx);
void show_scrBuilder(void);
void show_scrAddType(void);
void show_scrKeypad(const char *prompt);
void show_scrSettings(void);
void show_scrCalibrate(void);
void show_scrRename(void);
static void generate_next_custom_name(char *out, size_t out_size);
void show_scrFullGraph(void);
void refresh_profile_preview(void);
void cal_begin(void);
void cal_finish_and_save(void);
void cal_draw_target(int idx);
static void cal_timer_cb(lv_timer_t *t);
void refresh_eng_page(void);
void refresh_custom_list(void);
void refresh_builder_page(void);
void commit_keypad_value(void);
void finalize_add_step(void);
void my_disp_flush(lv_disp_drv_t *, const lv_area_t *, lv_color_t *);
void my_touchpad_read(lv_indev_drv_t *, lv_indev_data_t *);

// Custom-profile persistence
void loadCustomProfiles(void);

// WiFi + OTA
void loadSavedNets(void);
void saveSavedNets(void);
void wifiConnectAsync(void);
void wifiDisconnect(void);
void checkForUpdate(void);
void performUpdate(void);
void show_scrWifi(void);
void show_scrWifiPass(void);
void show_scrOTA (void);
void wifiStartScan(void);
void wifiPollScan(void);
void wifiAttemptConnect(const char *ssid, const char *pass);
void refreshWifiList(void);
void saveCustomProfiles(void);
bool addSavedCustom(const ProfileStep *steps, int count);
void deleteSavedCustom(int idx);

// Graph / planned-trajectory
void computePlannedTrajectory(const ProfileStep *steps, int count, float start_temp);
void setupProfileGraph(void);
void teardownProfileGraph(void);
void updateProfileGraphActual(void);

// ══════════════════════════════════════════════════════════════════
//   SECTION 8B — CUSTOM PROFILE PERSISTENCE (NVS namespace "custom")
// ══════════════════════════════════════════════════════════════════
#define CUSTOM_MAGIC 0x42

void loadCustomProfiles() {
  Preferences p;
  p.begin("custom", true);
  uint8_t magic = p.getUChar("magic", 0);
  if (magic != CUSTOM_MAGIC) { saved_custom_count = 0; p.end(); return; }
  int n = p.getInt("count", 0);
  if (n < 0) n = 0;
  if (n > SAVED_CUSTOM_MAX) n = SAVED_CUSTOM_MAX;
  saved_custom_count = n;
  for (int i = 0; i < n; i++) {
    char k[12];
    snprintf(k, sizeof(k), "n_%d", i);
    p.getString(k, saved_customs[i].name, PROFILE_NAME_LEN);
    snprintf(k, sizeof(k), "c_%d", i);
    saved_customs[i].step_count = p.getInt(k, 0);
    if (saved_customs[i].step_count < 0 ||
        saved_customs[i].step_count > PROFILE_MAX_STEPS) {
      saved_customs[i].step_count = 0;
    }
    snprintf(k, sizeof(k), "d_%d", i);
    size_t need = saved_customs[i].step_count * sizeof(ProfileStep);
    if (need > 0) p.getBytes(k, saved_customs[i].steps, need);
  }
  p.end();
}

void saveCustomProfiles() {
  Preferences p;
  p.begin("custom", false);
  p.clear();
  p.putUChar("magic", CUSTOM_MAGIC);
  p.putInt("count", saved_custom_count);
  for (int i = 0; i < saved_custom_count; i++) {
    char k[12];
    snprintf(k, sizeof(k), "n_%d", i);
    p.putString(k, saved_customs[i].name);
    snprintf(k, sizeof(k), "c_%d", i);
    p.putInt(k, saved_customs[i].step_count);
    snprintf(k, sizeof(k), "d_%d", i);
    p.putBytes(k, saved_customs[i].steps,
               saved_customs[i].step_count * sizeof(ProfileStep));
  }
  p.end();
}

bool addSavedCustom(const ProfileStep *steps, int count) {
  if (count <= 0 || count > PROFILE_MAX_STEPS) return false;
  if (saved_custom_count >= SAVED_CUSTOM_MAX)  return false;
  int slot = saved_custom_count;
  // Auto-name: "Custom Profile N" where N = smallest unused sequential number
  int used_max = 0;
  for (int i = 0; i < saved_custom_count; i++) {
    int n = 0;
    if (sscanf(saved_customs[i].name, "Custom Profile %d", &n) == 1) {
      if (n > used_max) used_max = n;
    }
  }
  snprintf(saved_customs[slot].name, PROFILE_NAME_LEN,
           "Custom Profile %d", used_max + 1);
  saved_customs[slot].step_count = count;
  for (int i = 0; i < count; i++) saved_customs[slot].steps[i] = steps[i];
  saved_custom_count++;
  saveCustomProfiles();
  return true;
}

void deleteSavedCustom(int idx) {
  if (idx < 0 || idx >= saved_custom_count) return;
  for (int i = idx; i < saved_custom_count - 1; i++) {
    saved_customs[i] = saved_customs[i + 1];
  }
  saved_custom_count--;
  saveCustomProfiles();
}

// ══════════════════════════════════════════════════════════════════
//   SECTION 8BB — WIFI CREDENTIALS + CONNECT
// ══════════════════════════════════════════════════════════════════
// Saved-networks NVS layout (namespace "wifi"):
//   "count"  (int)              — number of saved entries
//   "n_<i>"  (string)           — SSID for slot i
//   "p_<i>"  (string)           — password for slot i
// Legacy single-network layout (old "ssid"/"pass" strings) is auto-imported
// into slot 0 on first boot after the upgrade.

void saveSavedNets() {
  Preferences p;
  p.begin("wifi", false);
  p.clear();   // we own this namespace; rewrite the whole list
  p.putInt("count", saved_net_count);
  for (int i = 0; i < saved_net_count; i++) {
    char k[8];
    snprintf(k, sizeof(k), "n_%d", i);
    p.putString(k, saved_nets[i].ssid);
    snprintf(k, sizeof(k), "p_%d", i);
    p.putString(k, saved_nets[i].pass);
  }
  p.end();
}

void loadSavedNets() {
  saved_net_count = 0;
  Preferences p;
  p.begin("wifi", true);
  bool has_count = p.isKey("count");
  if (has_count) {
    int n = p.getInt("count", 0);
    if (n < 0) n = 0;
    if (n > SAVED_NET_MAX) n = SAVED_NET_MAX;
    saved_net_count = n;
    for (int i = 0; i < n; i++) {
      char k[8];
      snprintf(k, sizeof(k), "n_%d", i);
      p.getString(k, saved_nets[i].ssid, sizeof(saved_nets[i].ssid));
      snprintf(k, sizeof(k), "p_%d", i);
      p.getString(k, saved_nets[i].pass, sizeof(saved_nets[i].pass));
    }
    p.end();
  } else {
    // Migrate from the legacy single ssid/pass keys.
    char old_ssid[33] = "";
    char old_pass[65] = "";
    p.getString("ssid", old_ssid, sizeof(old_ssid));
    p.getString("pass", old_pass, sizeof(old_pass));
    p.end();
    if (old_ssid[0]) {
      strncpy(saved_nets[0].ssid, old_ssid, sizeof(saved_nets[0].ssid) - 1);
      saved_nets[0].ssid[sizeof(saved_nets[0].ssid) - 1] = 0;
      strncpy(saved_nets[0].pass, old_pass, sizeof(saved_nets[0].pass) - 1);
      saved_nets[0].pass[sizeof(saved_nets[0].pass) - 1] = 0;
      saved_net_count = 1;
      saveSavedNets();   // rewrite to the new layout
    }
  }
  // Mirror the first slot into the active wifi_ssid/wifi_pass so the
  // existing auto-reconnect path Just Works.
  if (saved_net_count > 0) {
    strncpy(wifi_ssid, saved_nets[0].ssid, sizeof(wifi_ssid) - 1);
    wifi_ssid[sizeof(wifi_ssid) - 1] = 0;
    strncpy(wifi_pass, saved_nets[0].pass, sizeof(wifi_pass) - 1);
    wifi_pass[sizeof(wifi_pass) - 1] = 0;
  } else {
    wifi_ssid[0] = 0;
    wifi_pass[0] = 0;
  }
}

static int findSavedByName(const char *ssid) {
  if (!ssid) return -1;
  for (int i = 0; i < saved_net_count; i++) {
    if (strcmp(saved_nets[i].ssid, ssid) == 0) return i;
  }
  return -1;
}

// Insert or update by SSID. If full, drops the oldest (slot 0) and shifts.
// Returns the slot index of the resulting entry.
static int addOrUpdateSavedNet(const char *ssid, const char *pass) {
  if (!ssid || !ssid[0]) return -1;
  int idx = findSavedByName(ssid);
  if (idx >= 0) {
    strncpy(saved_nets[idx].pass, pass ? pass : "", sizeof(saved_nets[idx].pass) - 1);
    saved_nets[idx].pass[sizeof(saved_nets[idx].pass) - 1] = 0;
    saveSavedNets();
    return idx;
  }
  if (saved_net_count >= SAVED_NET_MAX) {
    // Drop the oldest (slot 0); shift the rest down.
    for (int i = 0; i < SAVED_NET_MAX - 1; i++) saved_nets[i] = saved_nets[i + 1];
    saved_net_count = SAVED_NET_MAX - 1;
  }
  int slot = saved_net_count++;
  strncpy(saved_nets[slot].ssid, ssid, sizeof(saved_nets[slot].ssid) - 1);
  saved_nets[slot].ssid[sizeof(saved_nets[slot].ssid) - 1] = 0;
  strncpy(saved_nets[slot].pass, pass ? pass : "", sizeof(saved_nets[slot].pass) - 1);
  saved_nets[slot].pass[sizeof(saved_nets[slot].pass) - 1] = 0;
  saveSavedNets();
  return slot;
}

// Kick off an asynchronous connect (non-blocking). Poll WiFi.status() at
// leisure — we don't stall the control loop here.
void wifiConnectAsync() {
  if (!wifi_ssid[0]) return;
  WiFi.mode(WIFI_STA);
  WiFi.begin(wifi_ssid, wifi_pass);
  Serial.print("[WIFI] Connecting to SSID: ");
  Serial.println(wifi_ssid);
}

void wifiDisconnect() {
  WiFi.disconnect(true);
  WiFi.mode(WIFI_OFF);
  wifi_connected_flag = false;
}

// Kick a connection attempt and arm the state machine. Used by both the
// "tap a saved network" path and the "save password" path. Call from the
// UI thread.
void wifiAttemptConnect(const char *ssid, const char *pass) {
  if (!ssid || !ssid[0]) return;
  strncpy(wifi_conn_ssid, ssid, sizeof(wifi_conn_ssid) - 1);
  wifi_conn_ssid[sizeof(wifi_conn_ssid) - 1] = 0;
  wifi_conn_state            = WCS_TRYING;
  wifi_conn_start_ms         = millis();
  wifi_conn_state_changed_ms = millis();
  WiFi.disconnect(false);     // soft drop; keeps NVS config
  delay(50);                  // let the RTOS push the disconnect event
  WiFi.mode(WIFI_STA);
  WiFi.begin(ssid, pass ? pass : "");
  Serial.print("[WIFI] Attempting connect to ");
  Serial.println(ssid);
  refreshWifiList();
}

// Kick off a non-blocking network scan. Results are harvested in
// wifiPollScan() which is polled from the main loop.
void wifiStartScan() {
  WiFi.mode(WIFI_STA);
  WiFi.scanDelete();              // drop any previous result buffer
  WiFi.scanNetworks(true, false); // async, no hidden APs
  wifi_scan_in_progress = true;
  wifi_scan_count       = 0;
  wifi_sel_idx          = 0;
  wifi_list_top         = 0;
  Serial.println("[WIFI] Scan started.");
}

void wifiPollScan() {
  if (!wifi_scan_in_progress) return;
  int n = WiFi.scanComplete();
  if (n == WIFI_SCAN_RUNNING) return;     // still working
  wifi_scan_in_progress = false;
  if (n < 0) {
    Serial.print("[WIFI] Scan failed: "); Serial.println(n);
    refreshWifiList();
    return;
  }
  if (n > WIFI_SCAN_MAX) n = WIFI_SCAN_MAX;
  wifi_scan_count = n;
  for (int i = 0; i < n; i++) {
    String s = WiFi.SSID(i);
    strncpy(wifi_scan_results[i].ssid, s.c_str(), 32);
    wifi_scan_results[i].ssid[32] = 0;
    wifi_scan_results[i].rssi     = (int8_t)WiFi.RSSI(i);
    wifi_scan_results[i].enc      = (uint8_t)WiFi.encryptionType(i);
  }
  WiFi.scanDelete();
  // Pre-select the currently saved SSID if it's in the list.
  for (int i = 0; i < n; i++) {
    if (wifi_ssid[0] && strcmp(wifi_scan_results[i].ssid, wifi_ssid) == 0) {
      wifi_sel_idx  = i;
      if (wifi_sel_idx >= WIFI_LIST_VISIBLE)
        wifi_list_top = wifi_sel_idx - WIFI_LIST_VISIBLE + 1;
      break;
    }
  }
  Serial.print("[WIFI] Scan done, "); Serial.print(n); Serial.println(" networks.");
  refreshWifiList();
}

// Repaint the list rows from wifi_scan_results based on wifi_list_top
// and the highlight row (wifi_sel_idx).
// Stitch saved networks (pinned at the top) and freshly-scanned networks
// (deduped against saved entries) into wifi_display[].
static void rebuildWifiDisplay() {
  wifi_display_count = 0;

  // Saved entries first — always shown, in_range marked from scan results.
  for (int i = 0; i < saved_net_count && wifi_display_count < WIFI_DISPLAY_MAX; i++) {
    WifiDisplayEntry &d = wifi_display[wifi_display_count++];
    d.ssid     = saved_nets[i].ssid;
    d.is_saved = true;
    d.in_range = false;
    d.rssi     = -127;
    for (int j = 0; j < wifi_scan_count; j++) {
      if (strcmp(saved_nets[i].ssid, wifi_scan_results[j].ssid) == 0) {
        d.in_range = true;
        d.rssi     = wifi_scan_results[j].rssi;
        break;
      }
    }
  }

  // Then scan-only entries (not already in the saved list).
  for (int j = 0; j < wifi_scan_count && wifi_display_count < WIFI_DISPLAY_MAX; j++) {
    bool already_listed = false;
    for (int i = 0; i < saved_net_count; i++) {
      if (strcmp(wifi_scan_results[j].ssid, saved_nets[i].ssid) == 0) {
        already_listed = true; break;
      }
    }
    if (already_listed) continue;
    WifiDisplayEntry &d = wifi_display[wifi_display_count++];
    d.ssid     = wifi_scan_results[j].ssid;
    d.is_saved = false;
    d.in_range = true;
    d.rssi     = wifi_scan_results[j].rssi;
  }

  // Clamp cursor / scroll-top to valid range.
  if (wifi_sel_idx  >= wifi_display_count) wifi_sel_idx  = wifi_display_count > 0 ? wifi_display_count - 1 : 0;
  if (wifi_list_top >  wifi_sel_idx)        wifi_list_top = wifi_sel_idx;
  if (wifi_list_top + WIFI_LIST_VISIBLE <= wifi_sel_idx)
    wifi_list_top = wifi_sel_idx - WIFI_LIST_VISIBLE + 1;
  if (wifi_list_top < 0) wifi_list_top = 0;
}

void refreshWifiList() {
  rebuildWifiDisplay();

  // ---- Title / status banner ---------------------------------------------
  if (lblWifiTitle) {
    char buf[64];
    uint32_t color = CLR_TXT;
    const char *txt = "WiFi Networks";
    if (wifi_conn_state == WCS_TRYING) {
      txt   = "Connecting...";
      color = CLR_AMBER;
    } else if (wifi_conn_state == WCS_OK) {
      txt   = "Connected";
      color = CLR_SUCCESS;
    } else if (wifi_conn_state == WCS_FAILED) {
      txt   = "Connection failed";
      color = CLR_DANGER;
    } else if (wifi_scan_in_progress) {
      txt   = "Scanning...";
      color = CLR_TXT_DIM;
    }
    lv_label_set_text(lblWifiTitle, txt);
    lv_obj_set_style_text_color(lblWifiTitle, lv_color_hex(color), 0);
  }

  // SSID currently associated, used to paint that row green.
  String connected = (WiFi.status() == WL_CONNECTED) ? WiFi.SSID() : String("");

  if (wifi_display_count == 0) {
    if (lblWifiNoResults) {
      // Show "Scanning..." whenever we're either actively scanning OR no
      // scan has ever finished yet — i.e. the user has just landed on the
      // screen. Only flip to "No networks" once a scan has completed and
      // produced nothing.
      bool ever_scanned = !wifi_scan_in_progress && wifi_scan_count == 0
                          && saved_net_count == 0;
      lv_label_set_text(lblWifiNoResults,
        wifi_scan_in_progress ? "Scanning..."
                              : (ever_scanned ? "Scanning..." : "No networks"));
      lv_obj_clear_flag(lblWifiNoResults, LV_OBJ_FLAG_HIDDEN);
    }
    for (int i = 0; i < WIFI_LIST_VISIBLE; i++)
      if (wifiListRow[i]) lv_obj_add_flag(wifiListRow[i], LV_OBJ_FLAG_HIDDEN);
    return;
  }
  if (lblWifiNoResults) lv_obj_add_flag(lblWifiNoResults, LV_OBJ_FLAG_HIDDEN);

  for (int i = 0; i < WIFI_LIST_VISIBLE; i++) {
    int idx = wifi_list_top + i;
    if (idx >= wifi_display_count) {
      lv_obj_add_flag(wifiListRow[i], LV_OBJ_FLAG_HIDDEN);
      continue;
    }
    const WifiDisplayEntry &e = wifi_display[idx];
    bool selected   = (idx == wifi_sel_idx);
    bool is_active  = (connected.length() > 0) && (connected == e.ssid);

    // Saved icon (left): checkmark in amber, brightened to green if connected.
    if (lblWifiSaved[i]) {
      if (e.is_saved) {
        lv_label_set_text(lblWifiSaved[i], LV_SYMBOL_OK);
        lv_obj_set_style_text_color(lblWifiSaved[i],
          lv_color_hex(is_active ? CLR_SUCCESS : CLR_AMBER), 0);
        lv_obj_clear_flag(lblWifiSaved[i], LV_OBJ_FLAG_HIDDEN);
      } else {
        lv_obj_add_flag(lblWifiSaved[i], LV_OBJ_FLAG_HIDDEN);
      }
    }

    // SSID label
    lv_label_set_text(wifiListLabel[i], e.ssid);
    uint32_t ssid_color;
    if (is_active)      ssid_color = CLR_SUCCESS;
    else if (selected)  ssid_color = CLR_TXT;
    else                ssid_color = CLR_TXT_DIM;
    lv_obj_set_style_text_color(wifiListLabel[i], lv_color_hex(ssid_color), 0);

    // Signal indicator (right): WiFi glyph color-tiered by RSSI, or X if
    // a saved network isn't currently visible.
    if (lblWifiSignal[i]) {
      uint32_t sig_color;
      const char *sig_glyph;
      if (!e.in_range) {
        sig_glyph = LV_SYMBOL_CLOSE;
        sig_color = CLR_TXT_FAINT;
      } else {
        sig_glyph = LV_SYMBOL_WIFI;
        if      (e.rssi >= -60) sig_color = CLR_SUCCESS;
        else if (e.rssi >= -75) sig_color = CLR_AMBER;
        else                    sig_color = CLR_DANGER;
        if (is_active) sig_color = CLR_SUCCESS;
      }
      lv_label_set_text(lblWifiSignal[i], sig_glyph);
      lv_obj_set_style_text_color(lblWifiSignal[i], lv_color_hex(sig_color), 0);
    }

    // Row background
    lv_obj_set_style_bg_color(wifiListRow[i],
      lv_color_hex(selected ? CLR_ACCENT_D : CLR_PANEL2), 0);

    lv_obj_clear_flag(wifiListRow[i], LV_OBJ_FLAG_HIDDEN);
  }
}

// ══════════════════════════════════════════════════════════════════
//   SECTION 8CC — OTA UPDATE CHECK
//   Fetches OTA_MANIFEST_URL, parses the tiny JSON, and if the server
//   version differs from FIRMWARE_VERSION raises the UI prompt flag.
// ══════════════════════════════════════════════════════════════════
// Minimal string extractor for `"key":"value"` — avoids pulling in a full
// JSON library just for two fields. NOT robust against escaped quotes or
// whitespace edge cases — keep the manifest JSON well-behaved on the server.
static bool json_extract(const String &body, const char *key, char *out, size_t out_sz) {
  String needle = String("\"") + key + "\"";
  int k = body.indexOf(needle);
  if (k < 0) return false;
  int q1 = body.indexOf('"', k + needle.length());
  if (q1 < 0) return false;
  q1 = body.indexOf('"', q1);
  if (q1 < 0) return false;
  int q2 = body.indexOf('"', q1 + 1);
  if (q2 < 0) return false;
  String val = body.substring(q1 + 1, q2);
  strncpy(out, val.c_str(), out_sz - 1);
  out[out_sz - 1] = 0;
  return true;
}

void checkForUpdate() {
  if (WiFi.status() != WL_CONNECTED) {
    Serial.println("[OTA] No WiFi — skipping update check.");
    return;
  }
  WiFiClientSecure secureClient;
  secureClient.setCACertBundle(x509_crt_bundle, x509_crt_bundle_len);  // verifies any common CA

  HTTPClient http;
  http.setTimeout(8000);
  
  if (!http.begin(secureClient, OTA_MANIFEST_URL)) {
    Serial.println("[OTA] http.begin() failed.");
    return;
  }

  int code = http.GET();
  if (code != HTTP_CODE_OK) {
    Serial.print("[OTA] Manifest fetch failed, HTTP ");
    Serial.println(code);
    http.end();
    return;
  }
  String body = http.getString();
  http.end();

  char ver[24] = "", url[256] = "";
  if (!json_extract(body, "version", ver, sizeof(ver)) ||
      !json_extract(body, "url",     url, sizeof(url))) {
    Serial.println("[OTA] Malformed manifest.");
    return;
  }
  Serial.print("[OTA] Remote version: "); Serial.println(ver);
  Serial.print("[OTA] Local  version: "); Serial.println(FIRMWARE_VERSION);
  if (strcmp(ver, FIRMWARE_VERSION) == 0) {
    Serial.println("[OTA] Already up to date.");
    return;
  }
  strncpy(ota_remote_version, ver, sizeof(ota_remote_version) - 1);
  strncpy(ota_download_url,   url, sizeof(ota_download_url) - 1);
  ota_prompt_pending = true;
}

// Blocking: downloads firmware.bin over HTTPS and writes it to the inactive
// OTA partition, then reboots. The OTA progress screen is shown for the
// duration; the onProgress callback updates the bar and pumps LVGL on
// every chunk so the screen never appears frozen.
void performUpdate() {
  if (WiFi.status() != WL_CONNECTED) {
    ui_show_alert("Offline", "WiFi is not connected.");
    return;
  }
  if (!ota_download_url[0]) {
    ui_show_alert("No URL", "Update URL missing.");
    return;
  }
  // Refuse mid-process: a profile / tune / learn must be stopped first.
  if (profile_state > 0 || tune_state > 0 || learn_state > 0) {
    ui_show_alert("Busy",
                  "Stop the running profile / tune / learn before updating.");
    return;
  }

  // Safety: the OTA download blocks the main loop, so the 250 ms tick
  // that normally syncs sd_increment from pid_output may not run again
  // until after the flash write. Force the modulator off directly.
  pid_output       = 0.0f;
  sd_increment     = 0;
  setpoint         = 20.0f;
  current_setpoint = current_temp;
  is_ramping       = false;

  // Show the OTA progress screen and pump once so it actually paints
  // before the blocking download starts.
  show_scrOTA();
  for(int i=0; i<5; i++) {
      lv_tick_inc(10);
      lv_task_handler();
      delay(10);
  }


  Serial.print("[OTA] Downloading: "); Serial.println(ota_download_url);
  WiFiClientSecure secureClient;
  secureClient.setCACertBundle(x509_crt_bundle, x509_crt_bundle_len);  // verifies any common CA

  // Progress: called on every chunk by HTTPUpdate. We update the bar +
  // status label and call lv_task_handler() so LVGL can flush the change
  // before HTTPUpdate goes back to blocking on the next chunk.
  httpUpdate.onProgress([](int cur, int total) {
    if (total <= 0 || !barOTA || !lblOTAStatus) return;
    int pct = (int)((100L * (long)cur) / (long)total);
    if (pct < 0)   pct = 0;
    if (pct > 100) pct = 100;
    lv_bar_set_value(barOTA, pct, LV_ANIM_OFF);
    char buf[48];
    snprintf(buf, sizeof(buf), "Downloading...  %d%%", pct);
    lv_label_set_text(lblOTAStatus, buf);
    lv_tick_inc(50);
    lv_task_handler();
  });
  httpUpdate.onError([](int err) {
    Serial.printf("[OTA] httpUpdate error %d\n", err);
  });

  // Reboot ourselves so the user sees the "Complete!" frame first.
  httpUpdate.rebootOnUpdate(false);
  t_httpUpdate_return ret = httpUpdate.update(secureClient, ota_download_url);

  if (ret == HTTP_UPDATE_OK) {
    Serial.println("[OTA] Update OK — rebooting in 1.5 s.");
    if (barOTA)       lv_bar_set_value(barOTA, 100, LV_ANIM_OFF);
    if (lblOTAStatus) lv_label_set_text(lblOTAStatus, "Complete!  Rebooting...");
    lv_task_handler();
    delay(1500);
    ESP.restart();   // never returns
  } else {
    const char *err_str = httpUpdate.getLastErrorString().c_str();
    Serial.printf("[OTA] FAILED: (%d) %s\n",
                  httpUpdate.getLastError(), err_str);
    if (lblOTAStatus) {
      char buf[96];
      snprintf(buf, sizeof(buf), "Failed: %s",
               (err_str && *err_str) ? err_str : "unknown error");
      lv_label_set_text(lblOTAStatus, buf);
    }
    lv_task_handler();
    delay(3500);
    show_scrMain();
  }
}

// ══════════════════════════════════════════════════════════════════
//   SECTION 8C — PLANNED TRAJECTORY + GRAPH STATE MACHINE
// ══════════════════════════════════════════════════════════════════
void computePlannedTrajectory(const ProfileStep *steps, int count, float start_temp) {
  // Build a list of linear segments (start_time, end_time, start_temp, end_temp)
  struct Seg { float t0, t1, T0, T1; };
  Seg segs[PROFILE_MAX_STEPS * 2 + 1];
  int nseg = 0;
  float cur_t = 0.0f;
  float cur_T = start_temp;

  for (int i = 0; i < count; i++) {
    if (steps[i].is_ramp) {
      float dt = (steps[i].rate_per_sec > 1e-6f)
                   ? fabsf(steps[i].target - cur_T) / steps[i].rate_per_sec
                   : 0.0f;
      segs[nseg].t0 = cur_t; segs[nseg].t1 = cur_t + dt;
      segs[nseg].T0 = cur_T; segs[nseg].T1 = steps[i].target;
      nseg++;
      cur_t += dt;
      cur_T  = steps[i].target;
    } else {
      // SET: instantaneous setpoint jump — draw it as a zero-width segment.
      segs[nseg].t0 = cur_t; segs[nseg].t1 = cur_t;
      segs[nseg].T0 = cur_T; segs[nseg].T1 = steps[i].target;
      nseg++;
      cur_T = steps[i].target;
    }
    if (steps[i].hold_sec > 0) {
      float hs = (float)steps[i].hold_sec;
      segs[nseg].t0 = cur_t; segs[nseg].t1 = cur_t + hs;
      segs[nseg].T0 = cur_T; segs[nseg].T1 = cur_T;
      nseg++;
      cur_t += hs;
    }
  }

  profile_total_duration_s = (cur_t > 1.0f) ? cur_t : 1.0f;

  for (int p = 0; p < GRAPH_SAMPLES; p++) {
    float t = (profile_total_duration_s * (float)p) / (float)(GRAPH_SAMPLES - 1);
    float val = start_temp;
    for (int s = 0; s < nseg; s++) {
      if (t <= segs[s].t1 + 0.001f) {
        if (segs[s].t1 > segs[s].t0) {
          float frac = (t - segs[s].t0) / (segs[s].t1 - segs[s].t0);
          if (frac < 0.0f) frac = 0.0f;
          if (frac > 1.0f) frac = 1.0f;
          val = segs[s].T0 + frac * (segs[s].T1 - segs[s].T0);
        } else {
          val = segs[s].T1;
        }
        break;
      }
    }
    profile_planned[p] = val;
  }
  profile_has_plan = true;
  profile_last_slot_filled = -1;
}

// Pick a "nice" tick step in whole minutes: the smallest multiple of 10 that
// yields ≤ max_ticks tick positions across the total duration. Returns a
// step in minutes (minimum 10). For very short totals (<10 min) we relax to
// a step of 10 and simply place one tick at 0.
static int pick_tick_step_minutes(float total_min, int max_ticks) {
  if (total_min < 10.0f) return 10;
  static const int CANDIDATES[] = { 10, 20, 30, 60, 120, 300, 600 };
  for (unsigned i = 0; i < sizeof(CANDIDATES) / sizeof(CANDIDATES[0]); i++) {
    int step = CANDIDATES[i];
    if ((int)ceilf(total_min / (float)step) + 1 <= max_ticks) return step;
  }
  return CANDIDATES[sizeof(CANDIDATES) / sizeof(CANDIDATES[0]) - 1];
}

// Position a label's horizontal anchor such that its CENTER is at plot_left+px_offset.
static void place_xlabel(lv_obj_t *lbl, int plot_left, int px_offset, int y) {
  // Let LVGL compute self_width, then shift by half.
  lv_obj_update_layout(lbl);
  int w = lv_obj_get_width(lbl);
  int x = plot_left + px_offset - w / 2;
  if (x < 0) x = 0;
  lv_obj_set_pos(lbl, x, y);
}

// ---- MAIN PAGE (graphPanel-relative coords) ----
// chart at (3,3) in panel, pad_left=26 → plot_left = 3+26 = 29.
// chart width 150, right edge inside panel = 3+150 = 153; plot_right = 153.
// plot draw width = 124. Labels y=112.
// Plot draw area is the chart widget (at panel x=3..153) minus its 4-px
// horizontal padding on either side → x=7..149 in panel coords.
#define MAIN_PLOT_LEFT     7
#define MAIN_PLOT_RIGHT  149
#define MAIN_PLOT_WIDTH  (MAIN_PLOT_RIGHT - MAIN_PLOT_LEFT)
#define MAIN_XLABEL_Y    112

static void set_main_xaxis_profile(float total_s) {
  float total_min = total_s / 60.0f;
  if (total_min < 0.1f) total_min = 0.1f;
  int step = pick_tick_step_minutes(total_min, MAIN_X_MAX_LABELS);
  int shown = 0;
  for (int t = 0; t <= (int)floorf(total_min + 0.5f) && shown < MAIN_X_MAX_LABELS;
       t += step) {
    int px = (int)roundf((float)t / total_min * (float)MAIN_PLOT_WIDTH);
    if (px < 0) px = 0;
    if (px > MAIN_PLOT_WIDTH) px = MAIN_PLOT_WIDTH;
    char buf[16];
    snprintf(buf, sizeof(buf), (shown == 0 ? "%d" : "%d"), t);
    lv_label_set_text(lblXAxis[shown], buf);
    lv_obj_clear_flag(lblXAxis[shown], LV_OBJ_FLAG_HIDDEN);
    place_xlabel(lblXAxis[shown], MAIN_PLOT_LEFT, px, MAIN_XLABEL_Y);
    shown++;
    if (step <= 0) break;
  }
  for (int i = shown; i < MAIN_X_MAX_LABELS; i++)
    lv_obj_add_flag(lblXAxis[i], LV_OBJ_FLAG_HIDDEN);
}

static void set_main_xaxis_idle() {
  // 60 min rolling window. Fixed step=20 → labels 60, 40, 20, 0 (4 labels)
  // rendering right-to-left across the plot area (newest is right edge).
  const int step = 20;
  int vals[MAIN_X_MAX_LABELS] = { 60, 40, 20, 0 };
  for (int i = 0; i < MAIN_X_MAX_LABELS; i++) {
    int t_ago = vals[i];                            // minutes ago
    int px = (int)roundf((60 - t_ago) / 60.0f * (float)MAIN_PLOT_WIDTH);
    char buf[8];
    snprintf(buf, sizeof(buf), "%d", t_ago);
    lv_label_set_text(lblXAxis[i], buf);
    lv_obj_clear_flag(lblXAxis[i], LV_OBJ_FLAG_HIDDEN);
    place_xlabel(lblXAxis[i], MAIN_PLOT_LEFT, px, MAIN_XLABEL_Y);
  }
  (void)step;
}

// ---- FULLSCREEN (scrFullGraph-absolute coords) ----
// chart spans x=5..315 with pad_left=4 → plot_left = 5+4 = 9; plot_right = 315.
// See build_scrFullGraph below. Labels y=208.
#define FULL_PLOT_LEFT    9
#define FULL_PLOT_RIGHT 315
#define FULL_PLOT_WIDTH  (FULL_PLOT_RIGHT - FULL_PLOT_LEFT)
#define FULL_XLABEL_Y   208

static void set_full_xaxis_profile(float total_s) {
  float total_min = total_s / 60.0f;
  if (total_min < 0.1f) total_min = 0.1f;
  int step = pick_tick_step_minutes(total_min, FULL_X_MAX_LABELS);
  int shown = 0;
  for (int t = 0; t <= (int)floorf(total_min + 0.5f) && shown < FULL_X_MAX_LABELS;
       t += step) {
    int px = (int)roundf((float)t / total_min * (float)FULL_PLOT_WIDTH);
    if (px < 0) px = 0;
    if (px > FULL_PLOT_WIDTH) px = FULL_PLOT_WIDTH;
    char buf[16];
    snprintf(buf, sizeof(buf), "%d", t);
    lv_label_set_text(lblFullX[shown], buf);
    lv_obj_clear_flag(lblFullX[shown], LV_OBJ_FLAG_HIDDEN);
    place_xlabel(lblFullX[shown], FULL_PLOT_LEFT, px, FULL_XLABEL_Y);
    shown++;
    if (step <= 0) break;
  }
  for (int i = shown; i < FULL_X_MAX_LABELS; i++)
    lv_obj_add_flag(lblFullX[i], LV_OBJ_FLAG_HIDDEN);
  if (lblFullTitle) lv_label_set_text(lblFullTitle, "Profile trace");
}

static void set_full_xaxis_idle() {
  // 60 min history. Step 10 → labels at 60, 50, 40, 30, 20, 10, 0 (7 labels)
  int vals[FULL_X_MAX_LABELS] = { 60, 50, 40, 30, 20, 10, 0 };
  for (int i = 0; i < FULL_X_MAX_LABELS; i++) {
    int t_ago = vals[i];
    int px = (int)roundf((60 - t_ago) / 60.0f * (float)FULL_PLOT_WIDTH);
    char buf[8];
    snprintf(buf, sizeof(buf), "%d", t_ago);
    lv_label_set_text(lblFullX[i], buf);
    lv_obj_clear_flag(lblFullX[i], LV_OBJ_FLAG_HIDDEN);
    place_xlabel(lblFullX[i], FULL_PLOT_LEFT, px, FULL_XLABEL_Y);
  }
  if (lblFullTitle) lv_label_set_text(lblFullTitle, "60-minute history");
}

void setupProfileGraph() {
  if (!profile_has_plan) return;
  if (chartHist && serSP && serTemp) {
    int16_t *sp_arr = lv_chart_get_y_array(chartHist, serSP);
    int16_t *t_arr  = lv_chart_get_y_array(chartHist, serTemp);
    for (int i = 0; i < GRAPH_SAMPLES; i++) {
      sp_arr[i] = (int16_t)roundf(profile_planned[i]);
      t_arr[i]  = LV_CHART_POINT_NONE;
    }
    // Reset the series' internal shift index — otherwise any idle-mode
    // set_next_value() history would render the plan rotated (first step
    // appearing mid-chart and last step wrapping to the left edge).
    lv_chart_set_x_start_point(chartHist, serSP,   0);
    lv_chart_set_x_start_point(chartHist, serTemp, 0);
    lv_chart_refresh(chartHist);
  }
  if (chartFull && serSPFull && serTempFull) {
    int16_t *sp_arr = lv_chart_get_y_array(chartFull, serSPFull);
    int16_t *t_arr  = lv_chart_get_y_array(chartFull, serTempFull);
    for (int i = 0; i < GRAPH_SAMPLES; i++) {
      sp_arr[i] = (int16_t)roundf(profile_planned[i]);
      t_arr[i]  = LV_CHART_POINT_NONE;
    }
    lv_chart_set_x_start_point(chartFull, serSPFull,   0);
    lv_chart_set_x_start_point(chartFull, serTempFull, 0);
    lv_chart_refresh(chartFull);
  }
  set_main_xaxis_profile(profile_total_duration_s);
  set_full_xaxis_profile(profile_total_duration_s);
}

void teardownProfileGraph() {
  profile_has_plan = false;
  profile_last_slot_filled = -1;
  if (chartHist && serSP && serTemp) {
    int16_t *sp_arr = lv_chart_get_y_array(chartHist, serSP);
    int16_t *t_arr  = lv_chart_get_y_array(chartHist, serTemp);
    for (int i = 0; i < GRAPH_SAMPLES; i++) {
      sp_arr[i] = LV_CHART_POINT_NONE;
      t_arr[i]  = LV_CHART_POINT_NONE;
    }
    lv_chart_set_x_start_point(chartHist, serSP,   0);
    lv_chart_set_x_start_point(chartHist, serTemp, 0);
    lv_chart_refresh(chartHist);
  }
  if (chartFull && serSPFull && serTempFull) {
    int16_t *sp_arr = lv_chart_get_y_array(chartFull, serSPFull);
    int16_t *t_arr  = lv_chart_get_y_array(chartFull, serTempFull);
    for (int i = 0; i < GRAPH_SAMPLES; i++) {
      sp_arr[i] = LV_CHART_POINT_NONE;
      t_arr[i]  = LV_CHART_POINT_NONE;
    }
    lv_chart_set_x_start_point(chartFull, serSPFull,   0);
    lv_chart_set_x_start_point(chartFull, serTempFull, 0);
    lv_chart_refresh(chartFull);
  }
  last_graph_sample_ms = millis();
  set_main_xaxis_idle();
  set_full_xaxis_idle();
}

void updateProfileGraphActual() {
  if (!profile_has_plan) return;
  if (profile_total_duration_s <= 0.0f) return;
  float elapsed = (millis() - profile_start_ms) / 1000.0f;
  int slot = (int)((elapsed / profile_total_duration_s) * (float)(GRAPH_SAMPLES - 1));
  if (slot < 0) slot = 0;
  if (slot >= GRAPH_SAMPLES) slot = GRAPH_SAMPLES - 1;
  int16_t val = (int16_t)roundf(current_temp);
  int start_s = (profile_last_slot_filled < 0) ? slot : profile_last_slot_filled + 1;
  if (chartHist && serTemp) {
    int16_t *t_arr = lv_chart_get_y_array(chartHist, serTemp);
    for (int s = start_s; s <= slot; s++) t_arr[s] = val;
    lv_chart_refresh(chartHist);
  }
  if (chartFull && serTempFull) {
    int16_t *t_arr = lv_chart_get_y_array(chartFull, serTempFull);
    for (int s = start_s; s <= slot; s++) t_arr[s] = val;
    lv_chart_refresh(chartFull);
  }
  profile_last_slot_filled = slot;
}

// ══════════════════════════════════════════════════════════════════
//   SECTION 9 — SETUP
// ══════════════════════════════════════════════════════════════════
void setup() {
  Serial.begin(115200);

  // Log reset reason for debugging random resets
  esp_reset_reason_t reason = esp_reset_reason();
  Serial.printf("\n[BOOT] Reset reason: %d ", (int)reason);
  switch (reason) {
    case ESP_RST_POWERON:  Serial.println("(Power-on)"); break;
    case ESP_RST_SW:       Serial.println("(Software)"); break;
    case ESP_RST_PANIC:    Serial.println("(Panic/exception)"); break;
    case ESP_RST_INT_WDT:  Serial.println("(Interrupt watchdog)"); break;
    case ESP_RST_TASK_WDT: Serial.println("(Task watchdog)"); break;
    case ESP_RST_WDT:      Serial.println("(Other watchdog)"); break;
    case ESP_RST_BROWNOUT: Serial.println("(Brownout)"); break;
    default:               Serial.println("(Other)"); break;
  }

  // GPIO
  pinMode(FAN_PIN, OUTPUT);
  digitalWrite(FAN_PIN, HIGH);
  delay(1000);
  pinMode(TRIAC_PIN, OUTPUT);
  digitalWrite(TRIAC_PIN, LOW);
  pinMode(ZCD_PIN, INPUT);
  pinMode(CS_PIN, OUTPUT);
  digitalWrite(CS_PIN, HIGH);

  // ZCD ISR — drives the zero-crossing sigma-delta modulator
  attachInterrupt(digitalPinToInterrupt(ZCD_PIN), zcd_isr, FALLING);

  // Preferences (control params + touch cal + saved NCR)
  preferences.begin("pid_data", false);
  setpoint   = 20.0;   // always cold at boot — never restored from NVS
  // Factory-default plant identification from the prototype oven. If NVS
  // already holds values from a successful serial `TUNE` run, those are
  // used; otherwise these defaults make the unit usable out of the box.
  //   Model: Integrating Process  (plant_tau = 0)
  //   k'    = 0.043215
  //   theta = 182.92 s
  //   Kc    = 0.063570
  //   Ti    = 1456.0432
  //   lambda= 3.0
  lambda_val = preferences.getFloat("lambda",   1.0f);
  plant_K    = preferences.getFloat("K",        0.156470f);
  plant_tau  = preferences.getFloat("tau",      0.0f);
  plant_theta= preferences.getFloat("theta",  82.5f);
  Kc         = preferences.getFloat("Kc",       0.058270f);
  Ti         = preferences.getFloat("Ti",    438.7191f);
  ts_min_x   = preferences.getShort("ts_minx", 300);
  ts_max_x   = preferences.getShort("ts_maxx", 3800);
  ts_min_y   = preferences.getShort("ts_miny", 300);
  ts_max_y   = preferences.getShort("ts_maxy", 3800);

  for (int i = 0; i < NCR_LUT_SIZE; i++) {
    char key[10];
    sprintf(key, "ncrh_%d", i);
    float sh = preferences.getFloat(key, 0.0f);
    ncr_nvs_heat[i]   = (sh > 0.0f);
    ncr_saved_heat[i] = ncr_nvs_heat[i] ? sh : NCR_DEFAULT_HEAT[i];
    ncr_lut_heat[i]   = ncr_saved_heat[i];

    sprintf(key, "ncrc_%d", i);
    float sc = preferences.getFloat(key, 0.0f);
    ncr_nvs_cool[i]   = (sc > 0.0f);
    ncr_saved_cool[i] = ncr_nvs_cool[i] ? sc : NCR_DEFAULT_COOL[i];
    ncr_lut_cool[i]   = ncr_saved_cool[i];

    yield();
  }
  // Always re-derive fitted LUTs from raw data on boot
  linearizeNCR(ncr_saved_heat, ncr_lin_heat, NCR_DEFAULT_HEAT, true);
  linearizeNCR(ncr_saved_cool, ncr_lin_cool, NCR_DEFAULT_COOL, false);
  saveLinearizedLUTs();

  loadCustomProfiles();
  loadSavedNets();
  wifiConnectAsync();    // fire-and-forget; check status in loop()

  // First temperature read (hardware SPI)
  current_temp = readMAX6675();
  if (isnan(current_temp)) current_temp = 25.0f;
  current_setpoint = setpoint;
  for (int i = 0; i < SLOPE_WINDOW; i++)   temp_history[i]  = current_temp;
  for (int i = 0; i < POWER_BUFFER_SIZE; i++) power_history[i] = 0.0;
  predicted_temp = current_temp;

  // TFT + touch
  tft.init();
  tft.setRotation(1);
  tft.fillScreen(TFT_BLACK);
  ts.begin();
  ts.setRotation(1);

  // LVGL
  lv_init();
  lv_disp_draw_buf_init(&lvDrawBuf, lvBuf1, lvBuf2, SCREEN_W * 20);

  static lv_disp_drv_t dispDrv;
  lv_disp_drv_init(&dispDrv);
  dispDrv.hor_res  = SCREEN_W;
  dispDrv.ver_res  = SCREEN_H;
  dispDrv.flush_cb = my_disp_flush;
  dispDrv.draw_buf = &lvDrawBuf;
  lv_disp_drv_register(&dispDrv);

  static lv_indev_drv_t indevDrv;
  lv_indev_drv_init(&indevDrv);
  indevDrv.type    = LV_INDEV_TYPE_POINTER;
  indevDrv.read_cb = my_touchpad_read;
  lv_indev_drv_register(&indevDrv);

  lv_theme_t *th = lv_theme_default_init(
    lv_disp_get_default(),
    lv_palette_main(LV_PALETTE_CYAN),
    lv_palette_main(LV_PALETTE_RED),
    true,
    &lv_font_inter_14);
  lv_disp_set_theme(lv_disp_get_default(), th);

  ui_init();

  Serial.println("\nSystem Ready. Waiting for commands.");
}

// ══════════════════════════════════════════════════════════════════
//   SECTION 10 — MAIN LOOP
// ══════════════════════════════════════════════════════════════════
void loop() {
  unsigned long now = millis();

  // 1. Control loop (250 ms)
  if (now - last_temp_read >= 250) {
    float raw_temp = readMAX6675();

    if (!isnan(raw_temp)) {
      temp_buffer[buffer_index] = raw_temp;
      buffer_index++;
      if (buffer_index >= MEDIAN_WINDOW) {
        buffer_index = 0;
        buffer_filled = true;
      }
      if (buffer_filled) {
        float median_temp = getMedian(temp_buffer, MEDIAN_WINDOW);
        current_temp = (EMA_ALPHA * median_temp) + ((1.0 - EMA_ALPHA) * current_temp);
      } else {
        current_temp = raw_temp;
      }
    } else {
      pid_output = 0.0;
      Serial.println("SENSOR ERROR! Halting heater.");
    }
    last_temp_read = now;

    if (is_ramping) {
      float step = ramp_rate_per_sec * 0.25;
      if (setpoint > current_setpoint) {
        current_setpoint += step;
        if (current_setpoint >= setpoint) {
          current_setpoint = setpoint;
          is_ramping = false;
          // The MPC's feedforward u_plan now provides the hold power.
          // Reset the trim integrator clean — computePID() will detect
          // the is_ramping transition and do the same, this is belt-and-
          // suspenders.
          error_integral = 0.0f;
          Serial.println("\n[RAMP] Target reached. Holding.");
        }
      } else {
        current_setpoint -= step;
        if (current_setpoint <= setpoint) {
          current_setpoint = setpoint;
          is_ramping = false;
          error_integral = 0.0f;
          Serial.println("\n[RAMP] Target reached. Holding.");
        }
      }
    }

    if (tune_state > 0) {
      runAutoTuner();
    } else {
      if (learn_state > 0) runLearnSequence();
      else if (profile_state > 0) runProfile();
      if (learn_state == 0 || learn_state == 2 || learn_state == 4) {
        computePID();
      } else if (learn_state == 3) {
        float bucket_lo = 20.0f + learn_target_bucket * 5.0f;
        if (current_temp < bucket_lo) computePID();
        else pid_output = 0.0;
      } else {
        pid_output = 0.0;
      }
    }

    // Convert pid_output → Q0.16 increment for the ZCD sigma-delta ISR.
    // All FP math stays on this side of the volatile fence.
    {
      float p = pid_output;
      if (p < 0.0f) p = 0.0f;
      else if (p > 1.0f) p = 1.0f;
      sd_increment = (uint16_t)(p * 65535.0f + 0.5f);
    }
  }

  // 2. Model-predictive ledger (1000 ms)
  if (now - last_history_time >= 1000) {
    if (history_filled) {
      current_slope = (current_temp - temp_history[history_index]) / (float)SLOPE_WINDOW;

      if (pid_output == 0.0 && current_slope < 0.0 && abs(current_slope) < (plant_K * 0.5) && learn_state != 3 && learn_state != 5 && profile_state == 0) {
        int bucket = (int)((current_temp - 20.0f) / 5.0f);
        if (bucket < 0) bucket = 0;
        if (bucket >= NCR_LUT_SIZE) bucket = NCR_LUT_SIZE - 1;
        ncr_lut_cool[bucket] = (0.1f * abs(current_slope)) + (0.9f * ncr_lut_cool[bucket]);

        if (bucket != ncr_active_bucket) {
          ncr_active_bucket = bucket;
          ncr_prev_ema = ncr_lut_cool[bucket];
          ncr_stable_start_ms = now;
        } else if (plant_theta > 0.0f) {
          float required_ms = 2.0f * plant_theta * 1000.0f;
          if ((float)(now - ncr_stable_start_ms) >= required_ms) {
            float delta_pct = abs(ncr_lut_cool[bucket] - ncr_prev_ema) / (ncr_prev_ema + 1e-9f);
            if (delta_pct < 0.05f) {
              float saved = ncr_saved_cool[bucket];
              float diff_pct = (saved > 0.0f) ? (abs(ncr_lut_cool[bucket] - saved) / saved) : 1.0f;
              if (diff_pct >= 0.10f) {
                char key[10];
                sprintf(key, "ncrc_%d", bucket);
                preferences.putFloat(key, ncr_lut_cool[bucket]);
                ncr_saved_cool[bucket] = ncr_lut_cool[bucket];
                ncr_nvs_cool[bucket] = true;
                Serial.print("\n[NCR] Saved cool bucket ");
                Serial.print(bucket); Serial.print(" (~");
                Serial.print(20 + bucket * 5); Serial.print("C): ");
                Serial.print(ncr_lut_cool[bucket], 6);
                Serial.println(" C/s");
              }
            }
            ncr_prev_ema = ncr_lut_cool[bucket];
            ncr_stable_start_ms = now;
          }
        }
      }
    }

    temp_history[history_index] = current_temp;
    history_index++;
    if (history_index >= SLOPE_WINDOW) {
      history_index = 0;
      history_filled = true;
    }

    power_history[power_history_index] = pid_output;
    power_history_index = (power_history_index + 1) % POWER_BUFFER_SIZE;

    last_history_time = now;
  }

  // 3. Telemetry (500 ms)
  if (now - last_telemetry_time >= 500) {
    last_telemetry_time = now;
    printTelemetry();
    ui_update();
  }

  // 4. Graph sampling
  //    Profile mode: update the actual-temp overlay frequently against the
  //                  precomputed planned trajectory.
  //    Idle mode:    rolling 60-min history, 30 s per sample.
  if (profile_state > 0 && profile_has_plan) {
    updateProfileGraphActual();
  } else if (!profile_has_plan) {
    if (now - last_graph_sample_ms >= GRAPH_PERIOD_MS) {
      last_graph_sample_ms = now;
      int16_t tmp = (int16_t)roundf(current_temp);
      int16_t sp  = (int16_t)roundf(current_setpoint);
      if (chartHist && serTemp && serSP) {
        lv_chart_set_next_value(chartHist, serTemp, tmp);
        lv_chart_set_next_value(chartHist, serSP,   sp);
      }
      if (chartFull && serTempFull && serSPFull) {
        lv_chart_set_next_value(chartFull, serTempFull, tmp);
        lv_chart_set_next_value(chartFull, serSPFull,   sp);
      }
    }
  }

  // 5. Profile plot (30 s, serial)
  if (profile_state > 0 && now - profile_plot_last_ms >= 30000UL) {
    profile_plot_last_ms = now;
    Serial.print(">>PLOT ");
    Serial.print((now - profile_start_ms) / 60000.0f, 3);
    Serial.print(" ");  Serial.print(current_temp, 2);
    Serial.print(" ");  Serial.print(predicted_temp, 2);
    Serial.print(" ");  Serial.print(pid_output, 4);
    Serial.print(" ");  Serial.print(current_setpoint, 2);
    Serial.print(" ");  Serial.print(profile_current_step + 1);
    Serial.print(" ");  Serial.println(profile_state);
  }

  // 6. Serial commands
  if (Serial.available() > 0) {
    String cmd = Serial.readStringUntil('\n');
    cmd.trim();
    handleCommand(cmd);
  }

  // 6b. WiFi connection state + one-shot OTA check after we first get online.
  {
    static bool     last_wifi_up          = false;
    static bool     ota_check_done        = false;
    static unsigned long wifi_rejoin_at   = 0;
    bool up = (WiFi.status() == WL_CONNECTED);
    if (up && !last_wifi_up) {
      Serial.print("[WIFI] Connected. IP=");
      Serial.println(WiFi.localIP());
      // TLS cert validation requires a real wall-clock. ESP32 boots with
      // time(NULL) ≈ 0, which is before every CA's NotBefore date — TLS
      // handshakes against github.io would fail with HTTP -1. Kick off
      // SNTP the moment we associate; UTC is fine for cert checks.
      configTime(0, 0, "pool.ntp.org", "time.nist.gov", "time.google.com");
      Serial.println("[NTP] Sync requested.");
    } else if (!up && last_wifi_up) {
      Serial.println("[WIFI] Link lost.");
    }
    // Repaint the SSID list on every association change so the connected
    // indicator (green SSID + green WiFi glyph) stays accurate live.
    if (up != last_wifi_up) refreshWifiList();
    last_wifi_up = up;
    wifi_connected_flag = up;

    // Harvest async scan results when they're ready (drives the SSID list
    // on scrWifi). Cheap when no scan is running.
    wifiPollScan();

    // ---- Connection-attempt state machine -------------------------------
    if (wifi_conn_state == WCS_TRYING) {
      wl_status_t s = WiFi.status();
      bool failed   = (s == WL_CONNECT_FAILED || s == WL_NO_SSID_AVAIL);
      bool timed_out = (now - wifi_conn_start_ms > WIFI_CONN_TIMEOUT_MS);
      if (s == WL_CONNECTED) {
        wifi_conn_state            = WCS_OK;
        wifi_conn_state_changed_ms = now;
        Serial.print("[WIFI] Connected to ");
        Serial.println(WiFi.SSID());
        refreshWifiList();
      } else if (failed || timed_out) {
        wifi_conn_state            = WCS_FAILED;
        wifi_conn_state_changed_ms = now;
        Serial.print("[WIFI] Connect failed (status=");
        Serial.print((int)s);
        Serial.println(timed_out ? ", timeout)" : ")");
        refreshWifiList();
        // Bounce the user to the password screen for a fresh attempt.
        // Only do this if they're still on scrWifi — if they navigated
        // away in the meantime we shouldn't yank focus.
        if (lv_scr_act() == scrWifi) {
          strncpy(wifi_ssid, wifi_conn_ssid, sizeof(wifi_ssid) - 1);
          wifi_ssid[sizeof(wifi_ssid) - 1] = 0;
          wifi_pass[0] = 0;
          wifi_retry_due_to_fail = true;
          show_scrWifiPass();
        }
      }
    } else if (wifi_conn_state == WCS_OK) {
      // Hold the green "Connected to X" banner briefly, then fade to idle.
      if (now - wifi_conn_state_changed_ms > WIFI_CONN_OK_HOLD_MS) {
        wifi_conn_state = WCS_IDLE;
        refreshWifiList();
      }
    }
    // Bump the title even when state hasn't transitioned, so "Scanning..."
    // appears/disappears live as wifiPollScan toggles wifi_scan_in_progress.
    static bool last_scan_in_progress = false;
    if (last_scan_in_progress != wifi_scan_in_progress) {
      last_scan_in_progress = wifi_scan_in_progress;
      refreshWifiList();
    }

    // Fire a single OTA check once the wall-clock is valid (or skip after
    // ~30 s of trying). Without a synced clock, setCACert() will refuse
    // the github.io chain and the manifest fetch returns HTTP -1.
    static unsigned long first_up_ms = 0;
    if (up && first_up_ms == 0) first_up_ms = now;
    if (up && !ota_check_done && first_up_ms != 0 && now - first_up_ms > 3000) {
      time_t t = time(nullptr);
      bool clock_valid = (t > 1700000000);   // > 2023-11-15 → SNTP done
      if (clock_valid) {
        ota_check_done = true;
        Serial.print("[NTP] Clock = ");
        Serial.println((long)t);
        checkForUpdate();
      } else if (now - first_up_ms > 30000) {
        ota_check_done = true;
        Serial.println("[OTA] Skipping — no NTP sync after 30 s.");
      }
    }

    // If we have creds but link dropped, retry every ~30 s.
    if (!up && wifi_ssid[0]) {
      if (wifi_rejoin_at == 0) wifi_rejoin_at = now + 30000UL;
      else if ((long)(now - wifi_rejoin_at) >= 0) {
        wifi_rejoin_at = now + 30000UL;
        WiFi.disconnect();
        WiFi.begin(wifi_ssid, wifi_pass);
      }
    } else {
      wifi_rejoin_at = 0;
    }
  }

  // 7. LVGL
  lv_tick_inc(5);
  lv_task_handler();
  delay(5);

  // 8. Execute pending OTA safely outside the UI thread
  if (execute_ota_update_now) {
    execute_ota_update_now = false;
    performUpdate();
  }
}

// ══════════════════════════════════════════════════════════════════
//   SECTION 11 — MPC CONTROLLER (dual-predictor + gain learning + PI hold)
// ══════════════════════════════════════════════════════════════════
// Plant model (autotuned, integrating with dead time):
//     dT/dt = gain * u(t - theta) - NCR(T)
//
// ── PHASE 0 — RAMP / approach ──────────────────────────────────────
// Feed-forward power, computed from plant gain + heat-side NCR:
//     u_ff = (signed_ramp_rate + NCR_heat(T)) / gain
// For a SET command (no commanded rate), u_ff = 1.0 — go full power.
//
// Two predictions run in parallel, both checked against `setpoint`
// every tick. Either one reaching setpoint hard-clamps u to 0.
//
//   1. calculated_temp   — open-loop simulator from the start of the
//                          ramp:
//        ramp_start_temp + gain·∑u·dt − ∑NCR·dt
//      Long-horizon, model-based. Knows about NCR loss explicitly.
//
//   2. predicted_temp    — Smith-style, slope-based:
//        current_temp + observed_slope·θ + gain·Δu_window
//      Short-horizon, observation-based. The momentum_slope cleanup
//      assumes our heater will counter natural cooling within θ.
//      This is the "predictor" exposed in telemetry (Pred: in the
//      serial log).
//
// ── Gain learning ─────────────────────────────────────────────────
// At replan, snapshot slope_at_replan = current_slope. After ~2·θ
// seconds (the slope has had time to respond to applied power), the
// observed Δslope = current_slope − slope_at_replan reflects how much
// the applied power actually moved the slope. Plant equation says
// Δslope ≈ gain · avg_power, so:
//     gain_estimate = Δslope / avg_power
// We blend that into learned_gain (50/50 LP) so subsequent ramps use
// a more accurate plant inversion. This is active "gain learning and
// compensating" — if real plant_K is e.g. 2.5× the autotuned value,
// learned_gain converges there over a few ramps and u_ff stops
// over-commanding.
//
// ── PHASE 1 — HOLD ────────────────────────────────────────────────
// Entered only after current_temp settles within 0.8°C of setpoint
// AND current_slope is flat. Power is:
//     u = NCR_avg(T)/gain + Kc·err + (Kc/Ti)·error_integral
// Average-NCR is the unbiased steady-state base; PI tunes out
// residual error precisely.
//
// Compatible with SET / RAMP / PROFILE: reads is_ramping, setpoint,
// current_setpoint, ramp_rate_per_sec as set by startProfileStep()
// and the serial command parser.
// --- MPC PID Computation ---
void computePID() {
  if (plant_K == 0.0) { pid_output = 0.0; return; }

  int theta_sec = round(plant_theta);
  int old_idx = (power_history_index - theta_sec + POWER_BUFFER_SIZE) % POWER_BUFFER_SIZE;
  float u_old = power_history[old_idx];
  float power_sum = 0.0;
  int idx = old_idx;
  for (int i = 0; i < theta_sec; i++) {
    idx = (idx + 1) % POWER_BUFFER_SIZE;
    power_sum += (power_history[idx] - u_old);
  }

  int ncr_bucket = (int)((current_temp - 20.0f) / 5.0f);
  if (ncr_bucket < 0) ncr_bucket = 0;
  if (ncr_bucket >= NCR_LUT_SIZE) ncr_bucket = NCR_LUT_SIZE - 1;
  float active_ncr = getActiveNCR(ncr_bucket);

  float momentum_slope = current_slope;
  if (momentum_slope < 0.0) {
    if (abs(momentum_slope) <= (active_ncr * 1.1)) momentum_slope = 0.0;
    else momentum_slope += active_ncr;
  }

  predicted_temp = current_temp + (momentum_slope * plant_theta) + (plant_K * power_sum);

  float dt = 0.25;

  float signed_ramp_rate = 0.0;
  if (is_ramping)
    signed_ramp_rate = (setpoint >= current_setpoint) ? ramp_rate_per_sec : -ramp_rate_per_sec;
  float future_setpoint = current_setpoint + (signed_ramp_rate * plant_theta);
  float p_error = future_setpoint - predicted_temp;
  float p_term = Kc * p_error;

  float i_error;
  float flat_threshold = plant_K * 0.1 * 0.3;

  if (abs(current_slope) <= flat_threshold && (current_setpoint - current_temp) <= (current_setpoint * 0.1) && (current_setpoint - current_temp) > (current_setpoint * 0.015)) {
    i_error = current_setpoint - current_temp;  flatThresholdFlag = 1;
  } else if ((current_setpoint - current_temp) <= (current_setpoint * 0.015) && current_temp < current_setpoint) {
    i_error = current_setpoint - current_temp;  flatThresholdFlag = 1;
  } else if (current_temp >= current_setpoint && predicted_temp >= (current_setpoint * 0.9)) {
    i_error = current_setpoint - current_temp;  flatThresholdFlag = 1;
  } else if (current_temp >= current_setpoint && predicted_temp < (current_setpoint * 0.9)) {
    i_error = current_setpoint - predicted_temp; flatThresholdFlag = 0;
  } else {
    i_error = current_setpoint - predicted_temp; flatThresholdFlag = 0;
  }

  error_integral += i_error * dt;
  float max_integral = (1.0 / Kc) * Ti;
  if (error_integral > max_integral) error_integral = max_integral;

  if (flatThresholdFlag && !prev_flat_flag) {
    float ss = steadyStateIntegral(current_setpoint);
    if (error_integral < ss) error_integral = ss;
  }
  prev_flat_flag = flatThresholdFlag;

  float u = p_term + (Kc * (1.0 / Ti) * error_integral);
  if (u >= 1.0) { u = 1.0; if (i_error > 0) error_integral -= i_error * dt; }
  else if (u <= 0.0) u = 0.0;
  if (error_integral < 0.0) error_integral = 0.0;
  pid_output = u;
}

// ══════════════════════════════════════════════════════════════════
//   SECTION 12 — AUTO-TUNER (unchanged)
// ══════════════════════════════════════════════════════════════════
void runAutoTuner() {
  unsigned long now = millis();
  switch (tune_state) {
    case 1:
      pid_output = 0.0;
      if (abs(current_temp - tune_start_temp) > 0.5) {
        tune_start_temp = current_temp; tune_start_time_ms = now;
      }
      if (now - tune_start_time_ms >= 60000) {
        tune_start_temp = current_temp;
        pid_output = tune_step_power;
        tune_start_time_ms = now;
        tune_state = 2;
        Serial.println("\n[TUNE] Steady state confirmed! Step applied. Finding Dead Time (theta)...");
      }
      break;
    case 2:
      if (current_temp >= tune_start_temp + 0.5) {
        plant_theta = (now - tune_start_time_ms) / 1000.0;
        temp_at_theta = current_temp;
        time_at_theta_ms = now;
        tune_state = 3;
        Serial.print("\n[TUNE] Dead Time (theta) found: ");
        Serial.println(plant_theta, 4);
        Serial.println("[TUNE] Observing maximum slope for 60 seconds...");
      }
      break;
    case 3:
      if (now - time_at_theta_ms >= 60000) {
        float delta_T = current_temp - temp_at_theta;
        float S_max = delta_T / 60.0;
        plant_K = S_max / tune_step_power;
        plant_tau = 0.0;
        Serial.println("\n[TUNE] Slope measurement complete. Calculating SIMC...");
        calculateSIMC();
        tune_state = 0;
        pid_output = 0.0;
      }
      break;
  }
}

void calculateSIMC() {
  float actual_lambda = plant_theta * (lambda_val * 0.33f);
  if (plant_tau == 0.0) {
    Kc = 1.0f / (plant_K * (actual_lambda + plant_theta));
    Ti = 4.0f * (actual_lambda + plant_theta);
  } else {
    Kc = (1.0f / plant_K) * (plant_tau / (actual_lambda + plant_theta));
    Ti = min(plant_tau, (float)(4.0f * (actual_lambda + plant_theta)));
  }
  preferences.putFloat("K",     plant_K);
  preferences.putFloat("tau",   plant_tau);
  preferences.putFloat("theta", plant_theta);
  preferences.putFloat("Kc",    Kc);
  preferences.putFloat("Ti",    Ti);
  Serial.println("\n--- Tuning Complete ---");
  printPlantData();
}

// ══════════════════════════════════════════════════════════════════
//   SECTION 13 — NCR LEARN SWEEP (unchanged)
// ══════════════════════════════════════════════════════════════════
float linearFitSlope(float* temps, int n) {
  float sum_x = 0, sum_y = 0, sum_xy = 0, sum_x2 = 0;
  for (int i = 0; i < n; i++) {
    sum_x += i;
    sum_y += temps[i];
    sum_xy += i * temps[i];
    sum_x2 += i * i;
  }
  float denom = n * sum_x2 - sum_x * sum_x;
  if (abs(denom) < 1e-9f) return 0.0f;
  return (n * sum_xy - sum_x * sum_y) / denom;
}

void learnAdvanceBucket() {
  learn_target_bucket++;
  if (learn_target_bucket >= NCR_LUT_SIZE) {
    // Heating sweep done — transition to cooldown phase
    Serial.println("\n[LEARN] *** Heating sweep complete! Starting cooldown phase... ***");
    setpoint = 200.0f;
    current_setpoint = 200.0f;
    is_ramping = false;
    error_integral = 0.0f;  // MPC feedforward owns the hold power
    learn_state = 4;
    learn_stable_start_ms = millis();
    learn_stable_temp = current_temp;
    Serial.println("[LEARN] Heating to 200C and waiting for settle...");
  } else {
    float next_sp = min(20.0f + learn_target_bucket * 5.0f + 4.0f, 200.0f);
    setpoint = next_sp;
    current_setpoint = next_sp;
    is_ramping = false;
    error_integral = 0.0f;  // MPC feedforward owns the hold power
    learn_state = 2;
    Serial.print("\n[LEARN] --> Bucket ");
    Serial.print(learn_target_bucket);
    Serial.print(" (~");
    Serial.print(20 + learn_target_bucket * 5);
    Serial.print("C). Heating to ");
    Serial.print(next_sp, 0);
    Serial.println("C...");
  }
}

void learnCoolAdvanceBucket() {
  learn_target_bucket--;
  if (learn_target_bucket < learn_start_bucket) {
    // Cooldown sweep done — linearize both LUTs and finish
    linearizeNCR(ncr_saved_heat, ncr_lin_heat, NCR_DEFAULT_HEAT, true);
    linearizeNCR(ncr_saved_cool, ncr_lin_cool, NCR_DEFAULT_COOL, false);
    saveLinearizedLUTs();

    learn_state = 0;
    setpoint = learn_room_temp;
    current_setpoint = learn_room_temp;
    is_ramping = false;
    error_integral = 0.0f;  // MPC feedforward owns the hold power
    Serial.println("\n[LEARN] *** Full sweep complete! Both LUTs learned & linearized. ***");
    Serial.print("[LEARN] Setpoint returned to room temp (");
    Serial.print(learn_room_temp, 1);
    Serial.println("C).");
    printPlantData();
  } else {
    // Next bucket will be reached naturally as temp drops
    learn_obs_count = 0;
    learn_prev_fitted_slope = 0.0;
    learn_obs_last_sample_ms = millis();
    learn_observe_start_ms = millis();
    Serial.print("\n[LEARN] --> Cool bucket ");
    Serial.print(learn_target_bucket);
    Serial.print(" (~");
    Serial.print(20 + learn_target_bucket * 5);
    Serial.println("C). Waiting for temp to drop...");
  }
}

void runLearnSequence() {
  unsigned long now = millis();
  switch (learn_state) {
    case 1:
      if (abs(current_temp - learn_stable_temp) > 0.5f) {
        learn_stable_temp = current_temp;
        learn_stable_start_ms = now;
      }
      if (now - learn_stable_start_ms >= 60000UL) {
        learn_room_temp = current_temp;
        learn_target_bucket = (int)((current_temp - 20.0f) / 5.0f);
        if (learn_target_bucket < 0) learn_target_bucket = 0;
        learn_start_bucket = learn_target_bucket;
        float first_sp = min(20.0f + learn_target_bucket * 5.0f + 4.0f, 200.0f);
        setpoint = first_sp; current_setpoint = first_sp;
        is_ramping = false; error_integral = 0.0f;  // MPC feedforward owns hold power
        learn_state = 2;
        Serial.print("\n[LEARN] Stable at "); Serial.print(learn_room_temp, 1);
        Serial.print("C. Starting heat-up sweep at bucket "); Serial.print(learn_target_bucket);
        Serial.print(" (SP="); Serial.print(first_sp, 0); Serial.println("C).");
      }
      break;

    case 2: {
      float target_sp = min(20.0f + learn_target_bucket * 5.0f + 4.0f, 200.0f);
      if (current_temp >= target_sp - 1.0f) {
        learn_obs_count = 0;
        learn_prev_fitted_slope = 0.0;
        learn_obs_last_sample_ms = now;
        learn_observe_start_ms = now;
        learn_state = 3;
        Serial.print("\n[LEARN] Heat bucket "); Serial.print(learn_target_bucket);
        Serial.print(" (~"); Serial.print(20 + learn_target_bucket * 5);
        Serial.println("C) reached. Heater OFF — observing heating NCR...");
      }
      break;
    }

    case 3: {
      float bucket_lo = 20.0f + learn_target_bucket * 5.0f;
      float bucket_hi = bucket_lo + 5.0f;

      if (current_temp > bucket_hi) {
        if (learn_obs_count > 0) {
          learn_obs_count = 0;
          Serial.println("\n[LEARN] Temp above bucket range. Waiting to drop...");
        }
        break;
      }
      if (current_temp < bucket_lo) {
        if (learn_obs_count > 0) {
          learn_obs_count = 0;
          Serial.println("\n[LEARN] Temp below bucket range. Reheating...");
        }
        break;
      }

      if (now - learn_obs_last_sample_ms >= 1000UL) {
        learn_obs_last_sample_ms = now;
        if (learn_obs_count < LEARN_OBS_WINDOW) {
          learn_obs_temps[learn_obs_count++] = current_temp;
        }
        if (learn_obs_count >= LEARN_OBS_WINDOW) {
          float fitted_slope = linearFitSlope(learn_obs_temps, LEARN_OBS_WINDOW);
          Serial.print("\n[LEARN] Fit: "); Serial.print(fitted_slope, 6);
          Serial.print(" "); Serial.print(current_temp, 2);
          Serial.print(" Bkt"); Serial.println(learn_target_bucket);
          if (fitted_slope < 0.0f) {
            if (learn_prev_fitted_slope < 0.0f) {
              float delta_pct = abs(fitted_slope - learn_prev_fitted_slope)
                                / (abs(learn_prev_fitted_slope) + 1e-9f);
              if (delta_pct < 0.10f) {
                float ncr_val = abs(fitted_slope);
                ncr_lut_heat[learn_target_bucket] = ncr_val;
                char key[10];
                sprintf(key, "ncrh_%d", learn_target_bucket);
                preferences.putFloat(key, ncr_val);
                ncr_saved_heat[learn_target_bucket] = ncr_val;
                ncr_nvs_heat[learn_target_bucket] = true;
                Serial.print("\n[LEARN] Heat bucket "); Serial.print(learn_target_bucket);
                Serial.print(" converged & saved: "); Serial.print(ncr_val, 6);
                Serial.println(" C/s");
                learnAdvanceBucket();
              } else {
                Serial.print("\n[LEARN] Heat bucket "); Serial.print(learn_target_bucket);
                Serial.print(" slope drift "); Serial.print(delta_pct * 100.0f, 1);
                Serial.println("%. Re-observing...");
                learn_prev_fitted_slope = fitted_slope;
                learn_obs_count = 0;
                learn_observe_start_ms = now;
              }
            } else {
              learn_prev_fitted_slope = fitted_slope;
              learn_obs_count = 0;
              learn_observe_start_ms = now;
            }
          } else {
            Serial.println("\n[LEARN] Slope not negative yet. Re-observing...");
            learn_obs_count = 0;
            learn_observe_start_ms = now;
          }
        }
      }
      break;
    }

    case 4: {
      // HEAT_TO_MAX: heat to 200C, wait for 60s stability
      if (current_temp >= 199.0f) {
        if (abs(current_temp - learn_stable_temp) > 0.5f) {
          learn_stable_temp = current_temp;
          learn_stable_start_ms = now;
        }
        if (now - learn_stable_start_ms >= 60000UL) {
          learn_target_bucket = NCR_LUT_SIZE - 1;
          learn_obs_count = 0;
          learn_prev_fitted_slope = 0.0;
          learn_obs_last_sample_ms = now;
          learn_observe_start_ms = now;
          learn_state = 5;
          Serial.println("\n[LEARN] Settled at 200C. Heater OFF — starting cooldown NCR sweep...");
          Serial.print("[LEARN] --> Cool bucket "); Serial.print(learn_target_bucket);
          Serial.print(" (~"); Serial.print(20 + learn_target_bucket * 5);
          Serial.println("C).");
        }
      } else {
        learn_stable_temp = current_temp;
        learn_stable_start_ms = now;
      }
      break;
    }

    case 5: {
      float bucket_lo = 20.0f + learn_target_bucket * 5.0f;
      float bucket_hi = bucket_lo + 5.0f;

      if (current_temp > bucket_hi) {
        if (learn_obs_count > 0) learn_obs_count = 0;
        break;
      }
      if (current_temp < bucket_lo) {
        Serial.print("\n[LEARN] Temp dropped below cool bucket ");
        Serial.print(learn_target_bucket);
        Serial.println(" range. Advancing...");
        learnCoolAdvanceBucket();
        break;
      }

      if (now - learn_obs_last_sample_ms >= 1000UL) {
        learn_obs_last_sample_ms = now;
        if (learn_obs_count < LEARN_OBS_WINDOW) {
          learn_obs_temps[learn_obs_count++] = current_temp;
        }
        if (learn_obs_count >= LEARN_OBS_WINDOW) {
          float fitted_slope = linearFitSlope(learn_obs_temps, LEARN_OBS_WINDOW);
          Serial.print("\n[LEARN] Fit: "); Serial.print(fitted_slope, 6);
          Serial.print(" "); Serial.print(current_temp, 2);
          Serial.print(" Bkt"); Serial.println(learn_target_bucket);
          if (fitted_slope < 0.0f) {
            if (learn_prev_fitted_slope < 0.0f) {
              float delta_pct = abs(fitted_slope - learn_prev_fitted_slope)
                                / (abs(learn_prev_fitted_slope) + 1e-9f);
              if (delta_pct < 0.10f) {
                float ncr_val = abs(fitted_slope);
                ncr_lut_cool[learn_target_bucket] = ncr_val;
                char key[10];
                sprintf(key, "ncrc_%d", learn_target_bucket);
                preferences.putFloat(key, ncr_val);
                ncr_saved_cool[learn_target_bucket] = ncr_val;
                ncr_nvs_cool[learn_target_bucket] = true;
                Serial.print("\n[LEARN] Cool bucket "); Serial.print(learn_target_bucket);
                Serial.print(" converged & saved: "); Serial.print(ncr_val, 6);
                Serial.println(" C/s");
                learnCoolAdvanceBucket();
              } else {
                Serial.print("\n[LEARN] Cool bucket "); Serial.print(learn_target_bucket);
                Serial.print(" slope drift "); Serial.print(delta_pct * 100.0f, 1);
                Serial.println("%. Re-observing...");
                learn_prev_fitted_slope = fitted_slope;
                learn_obs_count = 0;
                learn_observe_start_ms = now;
              }
            } else {
              learn_prev_fitted_slope = fitted_slope;
              learn_obs_count = 0;
              learn_observe_start_ms = now;
            }
          } else {
            Serial.println("\n[LEARN] Cool slope not negative yet. Re-observing...");
            learn_obs_count = 0;
            learn_observe_start_ms = now;
          }
        }
      }
      break;
    }
  }
}

// ══════════════════════════════════════════════════════════════════
//   SECTION 14 — PROFILE EXECUTION (unchanged)
// ══════════════════════════════════════════════════════════════════
void startProfileStep() {
  ProfileStep &s = profile_steps[profile_current_step];
  profile_state = 1;
  Serial.print("\n[PROFILE] Step "); Serial.print(profile_current_step + 1);
  Serial.print("/"); Serial.print(profile_step_count); Serial.print(": ");
  if (s.is_ramp) {
    setpoint = s.target;
    float planned_start = current_temp;
    if (profile_current_step > 0)
      planned_start = profile_steps[profile_current_step - 1].target;
    current_setpoint = planned_start;
    ramp_rate_per_sec = s.rate_per_sec;
    is_ramping = true;
    // MPC's feedforward u_plan = (rate + NCR_heat)/plant_K provides the
    // ramp power directly. The trim integrator starts clean — computePID
    // will re-zero it on the is_ramping transition anyway.
    error_integral = 0.0f;
    Serial.print("RAMP to "); Serial.print(s.target, 1);
    Serial.print("C @ "); Serial.print(s.rate_per_sec * 60.0f, 2);
    Serial.print("C/min, hold "); Serial.print(s.hold_sec / 60); Serial.println("min");
  } else {
    setpoint = s.target;
    current_setpoint = s.target;
    is_ramping = false;
    // MPC's feedforward u_plan = NCR_cool/plant_K provides the hold
    // power. The trim integrator starts clean.
    error_integral = 0.0f;
    Serial.print("SET "); Serial.print(s.target, 1);
    Serial.print("C, hold "); Serial.print(s.hold_sec / 60); Serial.println("min");
  }
}

void profileAdvanceStep() {
  profile_current_step++;
  if (profile_current_step >= profile_step_count) {
    profile_state = 0;
    // Always return to 20 °C when the profile ends — the oven must not
    // keep holding a warm setpoint once the run is over.
    setpoint          = 20.0f;
    current_setpoint  = 20.0f;
    is_ramping        = false;
    ramp_rate_per_sec = 0.0f;
    error_integral    = 0.0f;
    pid_output        = 0.0f;
    float elapsed_min = (millis() - profile_start_ms) / 60000.0f;
    Serial.println("\n[PROFILE] *** Complete! ***");
    Serial.print(">>PROFILE_DONE "); Serial.println(elapsed_min, 3);
    // Leave the planned+actual trace on the chart so the user can inspect
    // how the run actually tracked. It is wiped only when a new profile
    // is chosen (refresh_profile_preview) or on reset. profile_has_plan
    // stays true → idle sampling won't overwrite the frozen trace.
    profile_completed_popup_pending = true;
  } else {
    startProfileStep();
  }
}

void runProfile() {
  unsigned long now = millis();
  ProfileStep &s = profile_steps[profile_current_step];
  const bool is_last          = (profile_current_step == profile_step_count - 1);
  const bool is_cooldown_last = is_last && (s.target <= PROFILE_AMBIENT_BAND_HI);

  if (profile_state == 1) {
    bool arrived = s.is_ramp ? !is_ramping : (abs(current_temp - s.target) <= 2.0f);

    // For the final cooldown step, the ramp profiler finishing on schedule
    // doesn't actually mean the oven is cold — it just means the setpoint
    // walked down to target. Require the plate itself to be within 2 °C of
    // target, OR we accept the oven has reached ambient (see below).
    if (is_cooldown_last) {
      bool actually_cool = (fabsf(current_temp - s.target) <= 2.0f);
      if (arrived && !actually_cool) arrived = false;

      // Ambient-stuck detection: if the plate has been in the 20–40 °C
      // band continuously for 30 minutes, assume room temperature is above
      // the user's target and accept completion.
      if (!arrived &&
          current_temp >= PROFILE_AMBIENT_BAND_LO &&
          current_temp <= PROFILE_AMBIENT_BAND_HI) {
        if (profile_ambient_stable_since_ms == 0) {
          profile_ambient_stable_since_ms = now;
          Serial.print("\n[PROFILE] Final step — entering ambient watch at ");
          Serial.print(current_temp, 1);
          Serial.println(" \xC2\xB0""C.");
        } else if (now - profile_ambient_stable_since_ms >= PROFILE_AMBIENT_WAIT_MS) {
          Serial.print("\n[PROFILE] 30 min stable in ambient band (");
          Serial.print(current_temp, 1);
          Serial.println(" \xC2\xB0""C). Accepting as room temperature.");
          arrived = true;
        }
      } else if (!arrived) {
        profile_ambient_stable_since_ms = 0;
      }
    }

    if (arrived) {
      profile_ambient_stable_since_ms = 0;
      if (s.hold_sec == 0) profileAdvanceStep();
      else {
        profile_hold_start_ms = now;
        profile_state = 2;
        Serial.print("\n[PROFILE] Step "); Serial.print(profile_current_step + 1);
        Serial.print(" at target. Holding ");
        Serial.print(s.hold_sec / 60); Serial.println("min...");
      }
    }
  } else if (profile_state == 2) {
    if (now - profile_hold_start_ms >= s.hold_sec * 1000UL) profileAdvanceStep();
  }
}

// Helper: start a profile from an in-memory step list. Used by both
// the touchscreen UI and, indirectly, the PROFILE: serial command
// (which still parses inline — preserved below).
bool startProfileFromSteps(const ProfileStep *steps, int count, const char *source_name) {
  if (tune_state > 0 || learn_state > 0) {
    Serial.println("\nError: Cannot start profile while TUNE or LEARN is running.");
    return false;
  }
  if (plant_K == 0.0) {
    Serial.println("\nError: Run TUNE first.");
    return false;
  }
  if (count <= 0 || count > PROFILE_MAX_STEPS) {
    Serial.println("\nError: Invalid step count.");
    return false;
  }
  for (int i = 0; i < count; i++) profile_steps[i] = steps[i];
  profile_step_count = count;
  profile_current_step = 0;
  error_integral = 0.0;

  Serial.print("\n[PROFILE] Loaded "); Serial.print(count);
  Serial.print(" steps from: "); Serial.println(source_name ? source_name : "?");
  for (int i = 0; i < count; i++) {
    Serial.print("  "); Serial.print(i + 1); Serial.print(". ");
    if (profile_steps[i].is_ramp) {
      Serial.print("RAMP ");   Serial.print(profile_steps[i].target, 1);
      Serial.print("C @ ");    Serial.print(profile_steps[i].rate_per_sec * 60.0f, 2);
      Serial.print("C/min, hold "); Serial.print(profile_steps[i].hold_sec / 60);
    } else {
      Serial.print("SET ");    Serial.print(profile_steps[i].target, 1);
      Serial.print("C, hold "); Serial.print(profile_steps[i].hold_sec / 60);
    }
    Serial.println("min");
  }

  profile_start_ms                 = millis();
  profile_plot_last_ms             = millis();
  profile_ambient_stable_since_ms  = 0;
  Serial.print(">>PROFILE_START ");
  Serial.print(count); Serial.print(" ");
  Serial.println(current_temp, 2);
  for (int i = 0; i < count; i++) {
    Serial.print(">>STEP ");
    Serial.print(profile_steps[i].is_ramp ? "RAMP" : "SET");
    Serial.print(" "); Serial.print(profile_steps[i].target, 1);
    Serial.print(" "); Serial.print(profile_steps[i].rate_per_sec * 60.0f, 4);
    Serial.print(" "); Serial.println(profile_steps[i].hold_sec / 60.0f, 4);
  }
  Serial.print(">>PLOT 0.000 ");
  Serial.print(current_temp, 2);
  Serial.print(" ");  Serial.print(current_temp, 2);
  Serial.print(" ");  Serial.print(pid_output, 4);
  Serial.print(" ");  Serial.print(current_setpoint, 2);
  Serial.print(" 1 ");  Serial.println(profile_state);

  computePlannedTrajectory(profile_steps, count, current_temp);
  setupProfileGraph();
  startProfileStep();
  return true;
}

void stopProfile(const char *reason) {
  profile_state                    = 0;
  is_ramping                       = false;
  ramp_rate_per_sec                = 0.0f;
  setpoint                         = 20.0f;
  current_setpoint                 = 20.0f;
  error_integral                   = 0.0f;
  pid_output                       = 0.0f;
  sd_increment                     = 0;
  profile_ambient_stable_since_ms  = 0;
  Serial.print("\n[PROFILE] Aborted");
  if (reason) { Serial.print(" ("); Serial.print(reason); Serial.print(")"); }
  Serial.println(".");
  // Preserve the partial trace on the chart — the user may want to inspect
  // what was captured. The graph is cleared only when a new profile is
  // selected or the device is reset.
}

// ══════════════════════════════════════════════════════════════════
//   SECTION 15 — SERIAL COMMAND PARSER (unchanged)
// ══════════════════════════════════════════════════════════════════
void handleCommand(String cmd) {
  if (cmd == "TUNE") {
    Serial.println("\nStarting Auto-Tune. Waiting for temperature to stabilize (60s)...");
    tune_state = 1;
    tune_start_time_ms = millis();
    tune_start_temp = current_temp;
    error_integral = 0;
  } else if (cmd == "LEARN") {
    if (plant_K == 0.0) {
      Serial.println("\nError: Run TUNE first — plant model is required for LEARN.");
    } else if (tune_state > 0) {
      Serial.println("\nError: Auto-tune in progress. Wait for it to finish.");
    } else if (profile_state > 0) {
      Serial.println("\nError: Profile running. Send PROFILE: STOP first.");
    } else {
      learn_state = 1;
      learn_stable_start_ms = millis();
      learn_stable_temp = current_temp;
      pid_output = 0.0;
      sd_increment = 0;
      error_integral = 0.0;
      Serial.println("\n[LEARN] Starting dual NCR sweep (heat-up then cool-down).");
      Serial.println("[LEARN] Waiting 60s for room-temp stability...");
    }
  } else if (cmd.startsWith("SET ")) {
    float val = cmd.substring(4).toFloat();
    if (val >= 20.0 && val <= 200.0) {
      profile_state = 0;
      setpoint = val;
      current_setpoint = val;
      is_ramping = false;
      ramp_rate_per_sec = 0.0;
      error_integral = 0.0f;  // MPC feedforward owns the hold power
      Serial.print("\nSetpoint updated to: "); Serial.println(setpoint, 4);
    } else {
      Serial.println("\nError: Setpoint must be 20-200.");
    }
  } else if (cmd.startsWith("RAMP ")) {
    int spaceIdx = cmd.indexOf(' ', 5);
    if (spaceIdx < 0) {
      Serial.println("\nError: Usage: RAMP <setpoint> <rate_C_per_min>  e.g. RAMP 100 5.0");
    } else {
      float target = cmd.substring(5, spaceIdx).toFloat();
      float rate_per_min = cmd.substring(spaceIdx + 1).toFloat();
      if (target < 20.0 || target > 200.0) {
        Serial.println("\nError: Ramp target must be 20-200.");
      } else if (rate_per_min <= 0.0) {
        Serial.println("\nError: Ramp rate must be > 0 °C/min.");
      } else {
        profile_state = 0;
        setpoint = target;
        current_setpoint = current_temp;
        ramp_rate_per_sec = rate_per_min / 60.0;
        is_ramping = true;

        error_integral = 0.0f;  // MPC feedforward owns the ramp power
        Serial.print("\n[RAMP] Target: ");    Serial.print(setpoint, 1);
        Serial.print(" C | Rate: ");          Serial.print(rate_per_min, 2);
        Serial.print(" C/min (");             Serial.print(ramp_rate_per_sec, 4);
        Serial.println(" C/s) | Starting from current temp.");
      }
    }
  } else if (cmd.startsWith("PROFILE:")) {
    String body = cmd.substring(8); body.trim();
    if (body.equalsIgnoreCase("STOP")) {
      stopProfile("serial STOP");
    } else if (tune_state > 0 || learn_state > 0) {
      Serial.println("\nError: Cannot start profile while TUNE or LEARN is running.");
    } else if (plant_K == 0.0) {
      Serial.println("\nError: Run TUNE first.");
    } else {
      ProfileStep parsed[PROFILE_MAX_STEPS];
      int count = 0;
      bool parse_ok = true;
      int pos = 0;
      while (pos <= (int)body.length() && count < PROFILE_MAX_STEPS) {
        int comma = body.indexOf(',', pos);
        String tok = (comma < 0) ? body.substring(pos) : body.substring(pos, comma);
        tok.trim();
        if (tok.length() > 0) {
          if (tok.startsWith("RAMP ")) {
            String r = tok.substring(5); r.trim();
            int s1 = r.indexOf(' ');  if (s1 < 0) { parse_ok=false; break; }
            float tgt = r.substring(0, s1).toFloat();
            r = r.substring(s1 + 1); r.trim();
            int s2 = r.indexOf(' ');  if (s2 < 0) { parse_ok=false; break; }
            float rate = r.substring(0, s2).toFloat();
            float hold_min = r.substring(s2 + 1).toFloat();
            if (tgt<20||tgt>200||rate<=0||hold_min<0) { parse_ok=false; break; }
            parsed[count].is_ramp = true;
            parsed[count].target = tgt;
            parsed[count].rate_per_sec = rate / 60.0f;
            parsed[count].hold_sec = (unsigned long)(hold_min * 60.0f);
            count++;
          } else if (tok.startsWith("SET ")) {
            String r = tok.substring(4); r.trim();
            int s1 = r.indexOf(' ');  if (s1 < 0) { parse_ok=false; break; }
            float tgt = r.substring(0, s1).toFloat();
            float hold_min = r.substring(s1 + 1).toFloat();
            if (tgt<20||tgt>200||hold_min<0) { parse_ok=false; break; }
            parsed[count].is_ramp = false;
            parsed[count].target = tgt;
            parsed[count].rate_per_sec = 0.0f;
            parsed[count].hold_sec = (unsigned long)(hold_min * 60.0f);
            count++;
          } else { parse_ok=false; break; }
        }
        if (comma < 0) break;
        pos = comma + 1;
      }
      if (!parse_ok || count == 0) {
        Serial.println("\nError: Invalid PROFILE syntax.");
        Serial.println("Usage: PROFILE: RAMP <temp> <C/min> <hold_min>, SET <temp> <hold_min>, ...");
      } else {
        startProfileFromSteps(parsed, count, "serial PROFILE:");
        snprintf(selected_profile_name, PROFILE_NAME_LEN, "serial");
        profile_is_selected = true;
        set_profile_button_label(selected_profile_name);
      }
    }
  } else if (cmd.startsWith("LAMBDA ")) {
    float val = cmd.substring(7).toFloat();
    if (val >= 1.0 && val <= 5.0) {
      lambda_val = val;
      preferences.putFloat("lambda", lambda_val);
      if (plant_K > 0) calculateSIMC();
      Serial.print("\nLambda updated to: "); Serial.println(lambda_val, 4);
    } else {
      Serial.println("\nError: Lambda must be 1-5.");
    }
  } else if (cmd == "PLANT") {
    Serial.println(); printPlantData();
  } else if (cmd == "SHOT") {
    // Capture whatever screen is currently displayed. The host-side
    // tools/screenshot.py reassembles the tile stream into a PNG.
    screenshot_capture_current();
  } else if (cmd == "SHOT ALL") {
    // Cycle every built screen, capturing each in turn. Useful for
    // generating the full website asset set in one go. Skips scrKeypad
    // (transient overlay) and restores scrMain at the end.
    lv_obj_t *shots[] = {
      scrMain, scrMaterial, scrHousehold, scrEngineer,
      scrCustom, scrCustomDetail, scrBuilder, scrAddType,
      scrFullGraph, scrSettings, scrCalibrate, scrRename,
      scrWifi, scrWifiPass, scrOTA
    };
    const size_t n = sizeof(shots) / sizeof(shots[0]);
    for (size_t i = 0; i < n; i++) {
      if (!shots[i]) continue;
      lv_scr_load(shots[i]);
      lv_refr_now(lv_disp_get_default());   // settle the load before snapshotting
      screenshot_capture_current();
    }
    lv_scr_load(scrMain);
  }
}

// ══════════════════════════════════════════════════════════════════
//   SECTION 16 — TELEMETRY (unchanged)
// ══════════════════════════════════════════════════════════════════
void printTelemetry() {
  Serial.print("Temp: "); Serial.print(current_temp, 4);
  Serial.print(" C (Pred: "); Serial.print(predicted_temp, 1);
  Serial.print(") | SP: "); Serial.print(current_setpoint, 2);
  if (is_ramping) {
    Serial.print(" -> "); Serial.print(setpoint, 1);
    Serial.print(" ("); Serial.print(ramp_rate_per_sec * 60.0, 2);
    Serial.print(" C/min)");
  }
  Serial.print(" | True RMS Out: "); Serial.print(pid_output * 100.0, 2); Serial.print(" %");
  if (tune_state > 0) {
    float elapsed = (millis() - tune_start_time_ms) / 1000.0;
    Serial.print(" | Mode: TUNING (State "); Serial.print(tune_state);
    Serial.print(") | Tmr: "); Serial.print(elapsed, 1); Serial.print(" s");
  } else if (profile_state > 0 && profile_current_step < profile_step_count) {
    ProfileStep &ps = profile_steps[profile_current_step];
    Serial.print(" | Mode: PROFILE "); Serial.print(profile_current_step + 1);
    Serial.print("/"); Serial.print(profile_step_count);
    Serial.print(ps.is_ramp ? " RAMP" : " SET");
    if (profile_state == 1) {
      Serial.print(" -> "); Serial.print(ps.target, 1); Serial.print("C");
    } else {
      float elapsed_min = (millis() - profile_hold_start_ms) / 60000.0f;
      Serial.print(" HOLD "); Serial.print(elapsed_min, 1);
      Serial.print("/"); Serial.print(ps.hold_sec / 60); Serial.print("min");
    }
  } else if (learn_state > 0) {
    Serial.print(" | Mode: LEARN S"); Serial.print(learn_state);
    Serial.print(" Bkt"); Serial.print(learn_target_bucket);
    Serial.print("(~"); Serial.print(20 + learn_target_bucket * 5); Serial.print("C)");
    if (learn_state == 3 || learn_state == 5) {
      Serial.print(" obs "); Serial.print(learn_obs_count);
      Serial.print("/"); Serial.print(LEARN_OBS_WINDOW); Serial.print("s");
    }
  } else if (plant_K == 0.0) {
    Serial.print(" | Mode: IDLE (Needs TUNE)");
  } else if (is_ramping) {
    Serial.print(" | Mode: RAMP | ErrInt: "); Serial.print(error_integral, 4);
    Serial.print(flatThresholdFlag ? " [REAL]" : " [PRED]");
  } else {
    Serial.print(" | Mode: PID | ErrInt: "); Serial.print(error_integral, 4);
    Serial.print(flatThresholdFlag ? " [REAL]" : " [PRED]");
  }
  Serial.println();
}

void printPlantData() {
  Serial.println("--- Plant Data ---");
  if (plant_tau == 0.0) {
    Serial.println("Model: Integrating Process");
    Serial.print("Gain (k'): "); Serial.println(plant_K, 6);
  } else {
    Serial.println("Model: FOPDT");
    Serial.print("Gain (K): "); Serial.println(plant_K, 6);
    Serial.print("Time Constant (tau): "); Serial.println(plant_tau, 4);
  }
  Serial.print("Dead Time (theta): "); Serial.println(plant_theta, 4);
  Serial.println("--- PID Parameters ---");
  Serial.print("Kc: "); Serial.println(Kc, 6);
  Serial.print("Ti: "); Serial.println(Ti, 4);
  Serial.print("Lambda Setting: "); Serial.println(lambda_val, 4);
  Serial.println("--- NCR Heat-Up Table (C/s) ---");
  Serial.println("  Temp |  Raw Heat | Curve Fit | Status");
  for (int i = 0; i < NCR_LUT_SIZE; i++) {
    int temp_c = 20 + i * 5;
    Serial.print("  "); if (temp_c < 100) Serial.print(" ");
    Serial.print(temp_c); Serial.print("C | ");
    Serial.print(ncr_lut_heat[i], 6); Serial.print(" | ");
    Serial.print(ncr_lin_heat[i], 6); Serial.print(" | ");
    Serial.println(ncr_nvs_heat[i] ? "learned" : "default");
  }
  Serial.println("--- NCR Cool-Down Table (C/s) ---");
  Serial.println("  Temp |  Raw Cool | Linearizd | Status");
  for (int i = 0; i < NCR_LUT_SIZE; i++) {
    int temp_c = 20 + i * 5;
    Serial.print("  "); if (temp_c < 100) Serial.print(" ");
    Serial.print(temp_c); Serial.print("C | ");
    Serial.print(ncr_lut_cool[i], 6); Serial.print(" | ");
    Serial.print(ncr_lin_cool[i], 6); Serial.print(" | ");
    Serial.println(ncr_nvs_cool[i] ? "learned" : "default");
  }
  Serial.println("----------------------");
}

// ══════════════════════════════════════════════════════════════════
//   SECTION 17 — LVGL DISPLAY / TOUCH CALLBACKS
// ══════════════════════════════════════════════════════════════════

// Resolve the currently-loaded screen object to a stable identifier so
// the host script can name captured PNG files after the screen they show.
static const char *current_screen_name() {
  lv_obj_t *s = lv_scr_act();
  if (s == scrMain)         return "main";
  if (s == scrMaterial)     return "material";
  if (s == scrHousehold)    return "household";
  if (s == scrEngineer)     return "engineer";
  if (s == scrCustom)       return "custom";
  if (s == scrCustomDetail) return "custom_detail";
  if (s == scrBuilder)      return "builder";
  if (s == scrAddType)      return "add_type";
  if (s == scrKeypad)       return "keypad";
  if (s == scrFullGraph)    return "full_graph";
  if (s == scrSettings)     return "settings";
  if (s == scrCalibrate)    return "calibrate";
  if (s == scrRename)       return "rename";
  if (s == scrWifi)         return "wifi";
  if (s == scrWifiPass)     return "wifi_pass";
  if (s == scrOTA)          return "ota";
  return "unknown";
}

// Capture the currently-displayed screen. Prints a text BEGIN marker,
// then forces a synchronous full-screen refresh — my_disp_flush emits a
// TILE marker + raw RGB565 bytes for every flush — then prints an END
// marker. lv_refr_now() blocks the loop so no other Serial output can
// interleave with the binary tiles.
static void screenshot_capture_current() {
  Serial.print("<<SHOT_BEGIN w="); Serial.print(SCREEN_W);
  Serial.print(" h=");             Serial.print(SCREEN_H);
  // Memory byte order of lv_color_t depends on LV_COLOR_16_SWAP — when
  // it's set LVGL stores colors pre-swapped (panel-native big-endian);
  // otherwise it's host little-endian. Advertise the actual layout so
  // the host decoder doesn't have to guess.
  Serial.print(" fmt=");
#if LV_COLOR_16_SWAP
  Serial.print("rgb565_be");
#else
  Serial.print("rgb565_le");
#endif
  Serial.print(" name=");
  Serial.print(current_screen_name());
  Serial.println(">>");

  g_shot_active = true;
  lv_obj_invalidate(lv_scr_act());
  lv_refr_now(lv_disp_get_default());
  g_shot_active = false;

  Serial.println("<<SHOT_END>>");
}

void my_disp_flush(lv_disp_drv_t *disp, const lv_area_t *area, lv_color_t *color_p) {
  uint32_t w = area->x2 - area->x1 + 1;
  uint32_t h = area->y2 - area->y1 + 1;

  if (g_shot_active) {
    uint32_t bytes = (uint32_t)w * h * sizeof(lv_color_t);
    Serial.print("<<SHOT_TILE x="); Serial.print(area->x1);
    Serial.print(" y=");            Serial.print(area->y1);
    Serial.print(" w=");            Serial.print(w);
    Serial.print(" h=");            Serial.print(h);
    Serial.print(" bytes=");        Serial.print(bytes);
    Serial.println(">>");
    // Stream the raw framebuffer tile. Serial.write blocks until the
    // UART TX FIFO has room, so this throttles itself to the line rate.
    const uint8_t *p   = (const uint8_t *)color_p;
    uint32_t       rem = bytes;
    while (rem) {
      size_t chunk = rem > 256 ? 256 : rem;
      Serial.write(p, chunk);
      p   += chunk;
      rem -= chunk;
    }
    Serial.println();  // CRLF terminator so the host can resync
  }

  tft.startWrite();
  tft.setAddrWindow(area->x1, area->y1, w, h);
  tft.pushColors((uint16_t *)&color_p->full, w * h, true);
  tft.endWrite();
  lv_disp_flush_ready(disp);
}

void my_touchpad_read(lv_indev_drv_t *indev, lv_indev_data_t *data) {
  if (ts.touched()) {
    TS_Point p = ts.getPoint();
    if (p.z > 300) {
      data->point.x = constrain(map(p.x, ts_min_x, ts_max_x, 0, SCREEN_W), 0, SCREEN_W - 1);
      data->point.y = constrain(map(p.y, ts_min_y, ts_max_y, 0, SCREEN_H), 0, SCREEN_H - 1);
      data->state = LV_INDEV_STATE_PR;
    } else data->state = LV_INDEV_STATE_REL;
  } else data->state = LV_INDEV_STATE_REL;
}
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
