omerkaraoglu/3D-Print-Annealer/Firmware/Arduino/AnnealerFirmware/AnnealerFirmware.ino/lv_font_inter_14.c

/*******************************************************************************
 * Size: 14 px
 * Bpp: 4
 * Opts: --bpp 4 --size 14 --no-compress --stride 1 --align 1 --font Inter_24pt-Regular.ttf --symbols QWERTYUIOPĞÜASDFGHJKLŞİZXCVBNMÖÇ.qwertyuıopğüasdfghjklşizxcvbnmöç,1234567890-_?*\/()[]{}!'^+%&<>|=:;"@~ --format lvgl -o lv_font_inter_14.c
 ******************************************************************************/

#ifdef __has_include
    #if __has_include("lvgl.h")
        #ifndef LV_LVGL_H_INCLUDE_SIMPLE
            #define LV_LVGL_H_INCLUDE_SIMPLE
        #endif
    #endif
#endif

#ifdef LV_LVGL_H_INCLUDE_SIMPLE
    #include "lvgl.h"
#else
    #include "lvgl/lvgl.h"
#endif



#ifndef LV_FONT_INTER_14
#define LV_FONT_INTER_14 1
#endif

#if LV_FONT_INTER_14

/*-----------------
 *    BITMAPS
 *----------------*/

/*Store the image of the glyphs*/
static LV_ATTRIBUTE_LARGE_CONST const uint8_t glyph_bitmap[] = {
    /* U+0021 "!" */
    0xe, 0x60, 0xe6, 0xe, 0x60, 0xe5, 0xd, 0x50,
    0xd5, 0xd, 0x50, 0x83, 0x0, 0x0, 0xc5, 0xe,
    0x70,

    /* U+0022 "\"" */
    0xa8, 0x7b, 0xa7, 0x7a, 0x97, 0x6a, 0x75, 0x58,

    /* U+0025 "%" */
    0x2d, 0xf8, 0x0, 0x2, 0xe1, 0xa, 0x70, 0xe2,
    0x0, 0xb6, 0x0, 0xc4, 0xb, 0x40, 0x6c, 0x0,
    0xa, 0x70, 0xe2, 0x1e, 0x20, 0x0, 0x2c, 0xe8,
    0xa, 0x80, 0x0, 0x0, 0x0, 0x4, 0xd0, 0x0,
    0x0, 0x0, 0x0, 0xd4, 0xb, 0xfa, 0x0, 0x0,
    0x89, 0x8, 0xa0, 0xc5, 0x0, 0x3e, 0x10, 0xa6,
    0x9, 0x70, 0xd, 0x50, 0x8, 0x90, 0xc5, 0x7,
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
    0xa0, 0x9, 0xc0, 0x0, 0x3, 0xf3, 0xf, 0x40,
    0x0, 0x0, 0x32, 0x3f, 0x0, 0x0, 0x0, 0x0,
    0x4f, 0x0, 0x5, 0xff, 0xf9, 0x3f, 0x0, 0x0,
    0x22, 0xc9, 0xf, 0x40, 0x0, 0x0, 0xd7, 0x9,
    0xc0, 0x0, 0x5, 0xf2, 0x1, 0xdd, 0x54, 0x8f,
    0x70, 0x0, 0x19, 0xef, 0xd6, 0x0,

    /* U+011F "ğ" */
    0x0, 0xe1, 0x2d, 0x0, 0x0, 0x4d, 0xd3, 0x0,
    0x0, 0x0, 0x0, 0x0, 0x1, 0xbf, 0xe5, 0xe4,
    0xc, 0xc3, 0x3c, 0xf4, 0x3f, 0x10, 0x2, 0xf4,
    0x6d, 0x0, 0x0, 0xe4, 0x6d, 0x0, 0x0, 0xe4,
    0x3f, 0x10, 0x2, 0xf4, 0xc, 0xb3, 0x3c, 0xf4,
    0x1, 0xbf, 0xe5, 0xe4, 0x1, 0x0, 0x0, 0xf3,
    0xd, 0xa2, 0x2a, 0xe0, 0x2, 0xbf, 0xfb, 0x20,

    /* U+0130 "İ" */
    0xe, 0x60, 0x93, 0x0, 0x0, 0xe6, 0xe, 0x60,
    0xe6, 0xe, 0x60, 0xe6, 0xe, 0x60, 0xe6, 0xe,
    0x60, 0xe6, 0xe, 0x60, 0xe6,

    /* U+0131 "ı" */
    0xf, 0x20, 0xf2, 0xf, 0x20, 0xf2, 0xf, 0x20,
    0xf2, 0xf, 0x20, 0xf2,

    /* U+015E "Ş" */
    0x0, 0x9e, 0xfd, 0x60, 0x0, 0xad, 0x53, 0x7f,
    0x60, 0xf, 0x30, 0x0, 0x8d, 0x0, 0xf4, 0x0,
    0x0, 0x10, 0x9, 0xf8, 0x30, 0x0, 0x0, 0x6,
    0xcf, 0xe8, 0x0, 0x0, 0x0, 0x5, 0xdb, 0x1,
    0x50, 0x0, 0x3, 0xf1, 0x3f, 0x20, 0x0, 0x4f,
    0x0, 0xcd, 0x53, 0x6e, 0xa0, 0x1, 0x9e, 0xfe,
    0x80, 0x0, 0x0, 0xd, 0x40, 0x0, 0x0, 0x0,
    0x2e, 0x0, 0x0, 0x0, 0x4c, 0xa0, 0x0,

    /* U+015F "ş" */
    0x4, 0xdf, 0xd4, 0x1, 0xf7, 0x16, 0xf0, 0x2f,
    0x10, 0x4, 0x0, 0xbe, 0x95, 0x0, 0x0, 0x48,
    0xdd, 0x11, 0x40, 0x0, 0xe5, 0x2f, 0x51, 0x5f,
    0x30, 0x5d, 0xfd, 0x60, 0x0, 0xd, 0x60, 0x0,
    0x0, 0x2d, 0x20, 0x0, 0x2c, 0xc0, 0x0
};


/*---------------------
 *  GLYPH DESCRIPTION
 *--------------------*/

static const lv_font_fmt_txt_glyph_dsc_t glyph_dsc[] = {
    {.bitmap_index = 0, .adv_w = 0, .box_w = 0, .box_h = 0, .ofs_x = 0, .ofs_y = 0} /* id = 0 reserved */,
    {.bitmap_index = 0, .adv_w = 56, .box_w = 3, .box_h = 11, .ofs_x = 0, .ofs_y = 0},
    {.bitmap_index = 17, .adv_w = 97, .box_w = 4, .box_h = 4, .ofs_x = 1, .ofs_y = 7},
    {.bitmap_index = 25, .adv_w = 203, .box_w = 11, .box_h = 11, .ofs_x = 1, .ofs_y = 0},
    {.bitmap_index = 86, .adv_w = 140, .box_w = 9, .box_h = 11, .ofs_x = 0, .ofs_y = 0},
    {.bitmap_index = 136, .adv_w = 61, .box_w = 2, .box_h = 4, .ofs_x = 1, .ofs_y = 7},
    {.bitmap_index = 140, .adv_w = 74, .box_w = 4, .box_h = 14, .ofs_x = 1, .ofs_y = -2},
    {.bitmap_index = 168, .adv_w = 74, .box_w = 4, .box_h = 14, .ofs_x = 0, .ofs_y = -2},
    {.bitmap_index = 196, .adv_w = 108, .box_w = 7, .box_h = 7, .ofs_x = 0, .ofs_y = 4},
    {.bitmap_index = 221, .adv_w = 144, .box_w = 7, .box_h = 7, .ofs_x = 1, .ofs_y = 1},
    {.bitmap_index = 246, .adv_w = 56, .box_w = 3, .box_h = 4, .ofs_x = 0, .ofs_y = -2},
    {.bitmap_index = 252, .adv_w = 99, .box_w = 6, .box_h = 2, .ofs_x = 0, .ofs_y = 3},
    {.bitmap_index = 258, .adv_w = 56, .box_w = 3, .box_h = 2, .ofs_x = 0, .ofs_y = 0},
    {.bitmap_index = 261, .adv_w = 76, .box_w = 5, .box_h = 13, .ofs_x = 0, .ofs_y = -2},
    {.bitmap_index = 294, .adv_w = 139, .box_w = 8, .box_h = 11, .ofs_x = 0, .ofs_y = 0},
    {.bitmap_index = 338, .adv_w = 86, .box_w = 5, .box_h = 11, .ofs_x = 0, .ofs_y = 0},
    {.bitmap_index = 366, .adv_w = 130, .box_w = 8, .box_h = 11, .ofs_x = 0, .ofs_y = 0},
    {.bitmap_index = 410, .adv_w = 136, .box_w = 8, .box_h = 11, .ofs_x = 0, .ofs_y = 0},
    {.bitmap_index = 454, .adv_w = 141, .box_w = 9, .box_h = 11, .ofs_x = 0, .ofs_y = 0},
    {.bitmap_index = 504, .adv_w = 131, .box_w = 8, .box_h = 11, .ofs_x = 0, .ofs_y = 0},
    {.bitmap_index = 548, .adv_w = 134, .box_w = 8, .box_h = 11, .ofs_x = 0, .ofs_y = 0},
    {.bitmap_index = 592, .adv_w = 121, .box_w = 8, .box_h = 11, .ofs_x = 0, .ofs_y = 0},
    {.bitmap_index = 636, .adv_w = 134, .box_w = 8, .box_h = 11, .ofs_x = 0, .ofs_y = 0},
    {.bitmap_index = 680, .adv_w = 134, .box_w = 8, .box_h = 11, .ofs_x = 0, .ofs_y = 0},
    {.bitmap_index = 724, .adv_w = 56, .box_w = 3, .box_h = 8, .ofs_x = 0, .ofs_y = 0},
    {.bitmap_index = 736, .adv_w = 58, .box_w = 3, .box_h = 10, .ofs_x = 0, .ofs_y = -2},
    {.bitmap_index = 751, .adv_w = 144, .box_w = 7, .box_h = 9, .ofs_x = 1, .ofs_y = 0},
    {.bitmap_index = 783, .adv_w = 144, .box_w = 7, .box_h = 5, .ofs_x = 1, .ofs_y = 1},
    {.bitmap_index = 801, .adv_w = 144, .box_w = 7, .box_h = 9, .ofs_x = 1, .ofs_y = 0},
    {.bitmap_index = 833, .adv_w = 116, .box_w = 7, .box_h = 11, .ofs_x = 0, .ofs_y = 0},
    {.bitmap_index = 872, .adv_w = 217, .box_w = 13, .box_h = 14, .ofs_x = 0, .ofs_y = -3},
    {.bitmap_index = 963, .adv_w = 150, .box_w = 10, .box_h = 11, .ofs_x = 0, .ofs_y = 0},
    {.bitmap_index = 1018, .adv_w = 145, .box_w = 8, .box_h = 11, .ofs_x = 1, .ofs_y = 0},
    {.bitmap_index = 1062, .adv_w = 163, .box_w = 10, .box_h = 11, .ofs_x = 0, .ofs_y = 0},
    {.bitmap_index = 1117, .adv_w = 158, .box_w = 9, .box_h = 11, .ofs_x = 1, .ofs_y = 0},
    {.bitmap_index = 1167, .adv_w = 132, .box_w = 7, .box_h = 11, .ofs_x = 1, .ofs_y = 0},
    {.bitmap_index = 1206, .adv_w = 128, .box_w = 7, .box_h = 11, .ofs_x = 1, .ofs_y = 0},
    {.bitmap_index = 1245, .adv_w = 165, .box_w = 10, .box_h = 11, .ofs_x = 0, .ofs_y = 0},
    {.bitmap_index = 1300, .adv_w = 162, .box_w = 9, .box_h = 11, .ofs_x = 1, .ofs_y = 0},
    {.bitmap_index = 1350, .adv_w = 56, .box_w = 2, .box_h = 11, .ofs_x = 1, .ofs_y = 0},
    {.bitmap_index = 1361, .adv_w = 123, .box_w = 7, .box_h = 11, .ofs_x = 0, .ofs_y = 0},
    {.bitmap_index = 1400, .adv_w = 146, .box_w = 8, .box_h = 11, .ofs_x = 1, .ofs_y = 0},
    {.bitmap_index = 1444, .adv_w = 123, .box_w = 7, .box_h = 11, .ofs_x = 1, .ofs_y = 0},
    {.bitmap_index = 1483, .adv_w = 197, .box_w = 11, .box_h = 11, .ofs_x = 1, .ofs_y = 0},
    {.bitmap_index = 1544, .adv_w = 163, .box_w = 9, .box_h = 11, .ofs_x = 1, .ofs_y = 0},
    {.bitmap_index = 1594, .adv_w = 169, .box_w = 10, .box_h = 11, .ofs_x = 0, .ofs_y = 0},
    {.bitmap_index = 1649, .adv_w = 140, .box_w = 8, .box_h = 11, .ofs_x = 1, .ofs_y = 0},
    {.bitmap_index = 1693, .adv_w = 169, .box_w = 10, .box_h = 12, .ofs_x = 0, .ofs_y = -1},
    {.bitmap_index = 1753, .adv_w = 143, .box_w = 8, .box_h = 11, .ofs_x = 1, .ofs_y = 0},
    {.bitmap_index = 1797, .adv_w = 140, .box_w = 9, .box_h = 11, .ofs_x = 0, .ofs_y = 0},
    {.bitmap_index = 1847, .adv_w = 140, .box_w = 9, .box_h = 11, .ofs_x = 0, .ofs_y = 0},
    {.bitmap_index = 1897, .adv_w = 162, .box_w = 9, .box_h = 11, .ofs_x = 1, .ofs_y = 0},
    {.bitmap_index = 1947, .adv_w = 150, .box_w = 10, .box_h = 11, .ofs_x = 0, .ofs_y = 0},
    {.bitmap_index = 2002, .adv_w = 216, .box_w = 14, .box_h = 11, .ofs_x = 0, .ofs_y = 0},
    {.bitmap_index = 2079, .adv_w = 148, .box_w = 9, .box_h = 11, .ofs_x = 0, .ofs_y = 0},
    {.bitmap_index = 2129, .adv_w = 148, .box_w = 9, .box_h = 11, .ofs_x = 0, .ofs_y = 0},
    {.bitmap_index = 2179, .adv_w = 139, .box_w = 9, .box_h = 11, .ofs_x = 0, .ofs_y = 0},
    {.bitmap_index = 2229, .adv_w = 74, .box_w = 3, .box_h = 14, .ofs_x = 1, .ofs_y = -3},
    {.bitmap_index = 2250, .adv_w = 76, .box_w = 5, .box_h = 13, .ofs_x = 0, .ofs_y = -2},
    {.bitmap_index = 2283, .adv_w = 74, .box_w = 4, .box_h = 14, .ofs_x = 0, .ofs_y = -3},
    {.bitmap_index = 2311, .adv_w = 101, .box_w = 6, .box_h = 6, .ofs_x = 0, .ofs_y = 5},
    {.bitmap_index = 2329, .adv_w = 102, .box_w = 7, .box_h = 2, .ofs_x = 0, .ofs_y = -2},
    {.bitmap_index = 2336, .adv_w = 120, .box_w = 7, .box_h = 8, .ofs_x = 0, .ofs_y = 0},
    {.bitmap_index = 2364, .adv_w = 131, .box_w = 8, .box_h = 11, .ofs_x = 0, .ofs_y = 0},
    {.bitmap_index = 2408, .adv_w = 122, .box_w = 8, .box_h = 8, .ofs_x = 0, .ofs_y = 0},
    {.bitmap_index = 2440, .adv_w = 131, .box_w = 8, .box_h = 11, .ofs_x = 0, .ofs_y = 0},
    {.bitmap_index = 2484, .adv_w = 125, .box_w = 8, .box_h = 8, .ofs_x = 0, .ofs_y = 0},
    {.bitmap_index = 2516, .adv_w = 75, .box_w = 5, .box_h = 11, .ofs_x = 0, .ofs_y = 0},
    {.bitmap_index = 2544, .adv_w = 131, .box_w = 8, .box_h = 11, .ofs_x = 0, .ofs_y = -3},
    {.bitmap_index = 2588, .adv_w = 127, .box_w = 7, .box_h = 11, .ofs_x = 0, .ofs_y = 0},
    {.bitmap_index = 2627, .adv_w = 50, .box_w = 3, .box_h = 11, .ofs_x = 0, .ofs_y = 0},
    {.bitmap_index = 2644, .adv_w = 50, .box_w = 4, .box_h = 14, .ofs_x = -1, .ofs_y = -3},
    {.bitmap_index = 2672, .adv_w = 118, .box_w = 8, .box_h = 11, .ofs_x = 0, .ofs_y = 0},
    {.bitmap_index = 2716, .adv_w = 50, .box_w = 3, .box_h = 11, .ofs_x = 0, .ofs_y = 0},
    {.bitmap_index = 2733, .adv_w = 192, .box_w = 12, .box_h = 8, .ofs_x = 0, .ofs_y = 0},
    {.bitmap_index = 2781, .adv_w = 127, .box_w = 7, .box_h = 8, .ofs_x = 0, .ofs_y = 0},
    {.bitmap_index = 2809, .adv_w = 128, .box_w = 8, .box_h = 8, .ofs_x = 0, .ofs_y = 0},
    {.bitmap_index = 2841, .adv_w = 131, .box_w = 8, .box_h = 11, .ofs_x = 0, .ofs_y = -3},
    {.bitmap_index = 2885, .adv_w = 131, .box_w = 8, .box_h = 11, .ofs_x = 0, .ofs_y = -3},
    {.bitmap_index = 2929, .adv_w = 78, .box_w = 5, .box_h = 8, .ofs_x = 0, .ofs_y = 0},
    {.bitmap_index = 2949, .adv_w = 112, .box_w = 7, .box_h = 8, .ofs_x = 0, .ofs_y = 0},
    {.bitmap_index = 2977, .adv_w = 71, .box_w = 5, .box_h = 10, .ofs_x = 0, .ofs_y = 0},
    {.bitmap_index = 3002, .adv_w = 127, .box_w = 7, .box_h = 8, .ofs_x = 0, .ofs_y = 0},
    {.bitmap_index = 3030, .adv_w = 120, .box_w = 8, .box_h = 8, .ofs_x = 0, .ofs_y = 0},
    {.bitmap_index = 3062, .adv_w = 175, .box_w = 11, .box_h = 8, .ofs_x = 0, .ofs_y = 0},
    {.bitmap_index = 3106, .adv_w = 117, .box_w = 8, .box_h = 8, .ofs_x = 0, .ofs_y = 0},
    {.bitmap_index = 3138, .adv_w = 120, .box_w = 8, .box_h = 11, .ofs_x = 0, .ofs_y = -3},
    {.bitmap_index = 3182, .adv_w = 115, .box_w = 7, .box_h = 8, .ofs_x = 0, .ofs_y = 0},
    {.bitmap_index = 3210, .adv_w = 90, .box_w = 5, .box_h = 14, .ofs_x = 0, .ofs_y = -3},
    {.bitmap_index = 3245, .adv_w = 70, .box_w = 2, .box_h = 18, .ofs_x = 1, .ofs_y = -3},
    {.bitmap_index = 3263, .adv_w = 90, .box_w = 5, .box_h = 14, .ofs_x = 0, .ofs_y = -3},
    {.bitmap_index = 3298, .adv_w = 144, .box_w = 7, .box_h = 4, .ofs_x = 1, .ofs_y = 2},
    {.bitmap_index = 3312, .adv_w = 163, .box_w = 10, .box_h = 14, .ofs_x = 0, .ofs_y = -3},
    {.bitmap_index = 3382, .adv_w = 169, .box_w = 10, .box_h = 14, .ofs_x = 0, .ofs_y = 0},
    {.bitmap_index = 3452, .adv_w = 162, .box_w = 9, .box_h = 14, .ofs_x = 1, .ofs_y = 0},
    {.bitmap_index = 3515, .adv_w = 122, .box_w = 8, .box_h = 11, .ofs_x = 0, .ofs_y = -3},
    {.bitmap_index = 3559, .adv_w = 128, .box_w = 8, .box_h = 11, .ofs_x = 0, .ofs_y = 0},
    {.bitmap_index = 3603, .adv_w = 127, .box_w = 7, .box_h = 11, .ofs_x = 0, .ofs_y = 0},
    {.bitmap_index = 3642, .adv_w = 165, .box_w = 10, .box_h = 14, .ofs_x = 0, .ofs_y = 0},
    {.bitmap_index = 3712, .adv_w = 131, .box_w = 8, .box_h = 14, .ofs_x = 0, .ofs_y = -3},
    {.bitmap_index = 3768, .adv_w = 56, .box_w = 3, .box_h = 14, .ofs_x = 0, .ofs_y = 0},
    {.bitmap_index = 3789, .adv_w = 50, .box_w = 3, .box_h = 8, .ofs_x = 0, .ofs_y = 0},
    {.bitmap_index = 3801, .adv_w = 140, .box_w = 9, .box_h = 14, .ofs_x = 0, .ofs_y = -3},
    {.bitmap_index = 3864, .adv_w = 112, .box_w = 7, .box_h = 11, .ofs_x = 0, .ofs_y = -3}
};

/*---------------------
 *  CHARACTER MAPPING
 *--------------------*/

static const uint16_t unicode_list_3[] = {
    0x0, 0xf, 0x15, 0x20, 0x2f, 0x35, 0x57, 0x58,
    0x69, 0x6a, 0x97, 0x98
};

/*Collect the unicode lists and glyph_id offsets*/
static const lv_font_fmt_txt_cmap_t cmaps[] =
{
    {
        .range_start = 33, .range_length = 2, .glyph_id_start = 1,
        .unicode_list = NULL, .glyph_id_ofs_list = NULL, .list_length = 0, .type = LV_FONT_FMT_TXT_CMAP_FORMAT0_TINY
    },
    {
        .range_start = 37, .range_length = 59, .glyph_id_start = 3,
        .unicode_list = NULL, .glyph_id_ofs_list = NULL, .list_length = 0, .type = LV_FONT_FMT_TXT_CMAP_FORMAT0_TINY
    },
    {
        .range_start = 97, .range_length = 30, .glyph_id_start = 62,
        .unicode_list = NULL, .glyph_id_ofs_list = NULL, .list_length = 0, .type = LV_FONT_FMT_TXT_CMAP_FORMAT0_TINY
    },
    {
        .range_start = 199, .range_length = 153, .glyph_id_start = 92,
        .unicode_list = unicode_list_3, .glyph_id_ofs_list = NULL, .list_length = 12, .type = LV_FONT_FMT_TXT_CMAP_SPARSE_TINY
    }
};

/*-----------------
 *    KERNING
 *----------------*/


/*Pair left and right glyphs for kerning*/
static const uint8_t kern_pair_glyph_ids[] =
{
    2, 4,
    2, 10,
    2, 12,
    2, 18,
    4, 2,
    4, 5,
    4, 58,
    5, 4,
    5, 10,
    5, 12,
    5, 18,
    8, 4,
    8, 10,
    8, 12,
    8, 18,
    8, 30,
    8, 61,
    9, 16,
    9, 17,
    9, 21,
    9, 58,
    10, 2,
    10, 5,
    10, 14,
    10, 15,
    10, 16,
    10, 17,
    10, 19,
    10, 20,
    10, 21,
    10, 22,
    10, 23,
    10, 29,
    10, 30,
    11, 16,
    11, 17,
    11, 21,
    11, 58,
    12, 2,
    12, 5,
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
};

/* Kerning between the respective left and right glyphs
 * 4.4 format which needs to scaled with `kern_scale`*/
static const int8_t kern_pair_values[] =
{
    -8, -18, -18, -14, -8, -8, -14, -8,
    -18, -18, -14, -8, -31, -31, -10, -1,
    -15, -8, -3, -5, -11, -18, -18, -6,
    -21, 1, -4, -3, -6, -3, -3, -2,
    -26, -10, -8, -3, -5, -11, -18, -18,
    -6, -21, 1, -4, -3, -6, -3, -3,
    -2, -26, -10, -9, -9, -6, -6, -4,
    -4, -10, -3, -5, -5, -5, -5, -7,
    -8, -8, -7, -5, -7, -2, -6, -6,
    -2, -2, -6, -6, -10, 1, -10, 2,
    -28, -28, -3, -4, -13, -2, -3, 4,
    -3, -2, -8, -8, -20, 2, -36, -5,
    -5, -5, -5, -6, -6, -4, -4, -10,
    -14, -14, -15, -17, -17, -10, -10, -9,
    -8, -9, -18, -18, -18, -8, -8, 4,
    -3, -13, -3, -11, -14, -7, -10, -18,
    -8, -8, -31, -31, -10, -1, -15, -15,
    -10, -24, -10, -13, -10, -10, -10, -10,
    -9, -18, -15, 3, -8, -3, -5, -11
};

/*Collect the kern pair's data in one place*/
static const lv_font_fmt_txt_kern_pair_t kern_pairs =
{
    .glyph_ids = kern_pair_glyph_ids,
    .values = kern_pair_values,
    .pair_cnt = 152,
    .glyph_ids_size = 0
};

/*--------------------
 *  ALL CUSTOM DATA
 *--------------------*/

#if LVGL_VERSION_MAJOR == 8
/*Store all the custom data of the font*/
static  lv_font_fmt_txt_glyph_cache_t cache;
#endif

#if LVGL_VERSION_MAJOR >= 8
static const lv_font_fmt_txt_dsc_t font_dsc = {
#else
static lv_font_fmt_txt_dsc_t font_dsc = {
#endif
    .glyph_bitmap = glyph_bitmap,
    .glyph_dsc = glyph_dsc,
    .cmaps = cmaps,
    .kern_dsc = &kern_pairs,
    .kern_scale = 16,
    .cmap_num = 4,
    .bpp = 4,
    .kern_classes = 0,
    .bitmap_format = 0,
#if LVGL_VERSION_MAJOR == 8
    .cache = &cache
#endif

};

extern const lv_font_t lv_font_montserrat_14;


/*-----------------
 *  PUBLIC FONT
 *----------------*/

/*Initialize a public general font descriptor*/
#if LVGL_VERSION_MAJOR >= 8
const lv_font_t lv_font_inter_14 = {
#else
lv_font_t lv_font_inter_14 = {
#endif
    .get_glyph_dsc = lv_font_get_glyph_dsc_fmt_txt,    /*Function pointer to get glyph's data*/
    .get_glyph_bitmap = lv_font_get_bitmap_fmt_txt,    /*Function pointer to get glyph's bitmap*/
    .line_height = 18,          /*The maximum line height required by the font*/
    .base_line = 3,             /*Baseline measured from the bottom of the line*/
#if !(LVGL_VERSION_MAJOR == 6 && LVGL_VERSION_MINOR == 0)
    .subpx = LV_FONT_SUBPX_NONE,
#endif
#if LV_VERSION_CHECK(7, 4, 0) || LVGL_VERSION_MAJOR >= 8
    .underline_position = -2,
    .underline_thickness = 1,
#endif
    .dsc = &font_dsc,          /*The custom font data. Will be accessed by `get_glyph_bitmap/dsc` */
#if LV_VERSION_CHECK(8, 2, 0) || LVGL_VERSION_MAJOR >= 9
    .fallback = &lv_font_montserrat_14,
#endif
    .user_data = NULL,
};



#endif /*#if LV_FONT_INTER_14*/
