omerkaraoglu/3D-Print-Annealer/Firmware/Arduino/AnnealerFirmware/AnnealerFirmware.ino/lv_font_inter_24.c

/*******************************************************************************
 * Size: 24 px
 * Bpp: 4
 * Opts: --bpp 4 --size 24 --no-compress --stride 1 --align 1 --font Inter_24pt-Regular.ttf --symbols QWERTYUIOPĞÜASDFGHJKLŞİZXCVBNMÖÇ.qwertyuıopğüasdfghjklşizxcvbnmöç,1234567890-_?*\/()[]{}!'^+%&<>|=:;"@~ --format lvgl -o lv_font_inter_24.c
 ******************************************************************************/

#ifdef __has_include
    #if __has_include("lvgl.h")
        #ifndef LV_LVGL_H_INCLUDE_SIMPLE
            #define LV_LVGL_H_INCLUDE_SIMPLE
        #endif
    #endif
#endif

#ifdef LV_LVGL_H_INCLUDE_SIMPLE
    #include "lvgl.h"
#else
    #include "lvgl/lvgl.h"
#endif



#ifndef LV_FONT_INTER_24
#define LV_FONT_INTER_24 1
#endif

#if LV_FONT_INTER_24

/*-----------------
 *    BITMAPS
 *----------------*/

/*Store the image of the glyphs*/
static LV_ATTRIBUTE_LARGE_CONST const uint8_t glyph_bitmap[] = {
    /* U+0021 "!" */
    0x2f, 0xf2, 0x2f, 0xf1, 0x1f, 0xf1, 0x1f, 0xf1,
    0x1f, 0xf1, 0x1f, 0xf1, 0x1f, 0xf0, 0xf, 0xf0,
    0xf, 0xf0, 0xf, 0xf0, 0xf, 0xf0, 0xf, 0xf0,
    0x7, 0x60, 0x0, 0x0, 0x0, 0x0, 0x2e, 0xe2,
    0x7f, 0xf7, 0x2e, 0xe2,

    /* U+0022 "\"" */
    0xbf, 0x50, 0xff, 0x1b, 0xf4, 0xf, 0xf0, 0xaf,
    0x40, 0xef, 0xa, 0xf3, 0xd, 0xf0, 0x9f, 0x20,
    0xde, 0x8, 0xf2, 0xc, 0xe0, 0x24, 0x0, 0x33,
    0x0,

    /* U+0025 "%" */
    0x5, 0xdf, 0xe7, 0x0, 0x0, 0x0, 0x8, 0xf7,
    0x0, 0x4f, 0xe8, 0xcf, 0x70, 0x0, 0x0, 0x3f,
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
    0xff, 0xdd, 0xff, 0xe2, 0x1, 0x8d, 0xff, 0xd8,
    0x10, 0x0, 0x0, 0x9b, 0x10, 0x0, 0x0, 0x0,
    0xbf, 0xf6, 0x0, 0x0, 0x0, 0x1, 0xdd, 0x0,
    0x0, 0x0, 0x34, 0xec, 0x0, 0x0, 0x3, 0xff,
    0xc3, 0x0
};


/*---------------------
 *  GLYPH DESCRIPTION
 *--------------------*/

static const lv_font_fmt_txt_glyph_dsc_t glyph_dsc[] = {
    {.bitmap_index = 0, .adv_w = 0, .box_w = 0, .box_h = 0, .ofs_x = 0, .ofs_y = 0} /* id = 0 reserved */,
    {.bitmap_index = 0, .adv_w = 96, .box_w = 4, .box_h = 18, .ofs_x = 1, .ofs_y = 0},
    {.bitmap_index = 36, .adv_w = 166, .box_w = 7, .box_h = 7, .ofs_x = 2, .ofs_y = 11},
    {.bitmap_index = 61, .adv_w = 348, .box_w = 18, .box_h = 18, .ofs_x = 2, .ofs_y = 0},
    {.bitmap_index = 223, .adv_w = 240, .box_w = 14, .box_h = 18, .ofs_x = 1, .ofs_y = 0},
    {.bitmap_index = 349, .adv_w = 105, .box_w = 3, .box_h = 7, .ofs_x = 2, .ofs_y = 11},
    {.bitmap_index = 360, .adv_w = 126, .box_w = 6, .box_h = 22, .ofs_x = 2, .ofs_y = -3},
    {.bitmap_index = 426, .adv_w = 126, .box_w = 6, .box_h = 22, .ofs_x = 0, .ofs_y = -3},
    {.bitmap_index = 492, .adv_w = 185, .box_w = 10, .box_h = 10, .ofs_x = 1, .ofs_y = 8},
    {.bitmap_index = 542, .adv_w = 247, .box_w = 12, .box_h = 12, .ofs_x = 2, .ofs_y = 1},
    {.bitmap_index = 614, .adv_w = 96, .box_w = 4, .box_h = 7, .ofs_x = 1, .ofs_y = -4},
    {.bitmap_index = 628, .adv_w = 170, .box_w = 9, .box_h = 2, .ofs_x = 1, .ofs_y = 6},
    {.bitmap_index = 637, .adv_w = 96, .box_w = 4, .box_h = 4, .ofs_x = 1, .ofs_y = 0},
    {.bitmap_index = 645, .adv_w = 131, .box_w = 8, .box_h = 21, .ofs_x = 0, .ofs_y = -3},
    {.bitmap_index = 729, .adv_w = 239, .box_w = 13, .box_h = 18, .ofs_x = 1, .ofs_y = 0},
    {.bitmap_index = 846, .adv_w = 147, .box_w = 8, .box_h = 18, .ofs_x = 0, .ofs_y = 0},
    {.bitmap_index = 918, .adv_w = 224, .box_w = 12, .box_h = 18, .ofs_x = 1, .ofs_y = 0},
    {.bitmap_index = 1026, .adv_w = 233, .box_w = 13, .box_h = 18, .ofs_x = 1, .ofs_y = 0},
    {.bitmap_index = 1143, .adv_w = 242, .box_w = 15, .box_h = 18, .ofs_x = 0, .ofs_y = 0},
    {.bitmap_index = 1278, .adv_w = 224, .box_w = 12, .box_h = 18, .ofs_x = 1, .ofs_y = 0},
    {.bitmap_index = 1386, .adv_w = 230, .box_w = 13, .box_h = 18, .ofs_x = 1, .ofs_y = 0},
    {.bitmap_index = 1503, .adv_w = 207, .box_w = 13, .box_h = 18, .ofs_x = 0, .ofs_y = 0},
    {.bitmap_index = 1620, .adv_w = 230, .box_w = 13, .box_h = 18, .ofs_x = 1, .ofs_y = 0},
    {.bitmap_index = 1737, .adv_w = 230, .box_w = 13, .box_h = 18, .ofs_x = 1, .ofs_y = 0},
    {.bitmap_index = 1854, .adv_w = 96, .box_w = 4, .box_h = 13, .ofs_x = 1, .ofs_y = 0},
    {.bitmap_index = 1880, .adv_w = 99, .box_w = 4, .box_h = 16, .ofs_x = 1, .ofs_y = -4},
    {.bitmap_index = 1912, .adv_w = 247, .box_w = 12, .box_h = 14, .ofs_x = 1, .ofs_y = 0},
    {.bitmap_index = 1996, .adv_w = 247, .box_w = 11, .box_h = 7, .ofs_x = 2, .ofs_y = 3},
    {.bitmap_index = 2035, .adv_w = 247, .box_w = 12, .box_h = 14, .ofs_x = 2, .ofs_y = 0},
    {.bitmap_index = 2119, .adv_w = 199, .box_w = 12, .box_h = 18, .ofs_x = 0, .ofs_y = 0},
    {.bitmap_index = 2227, .adv_w = 373, .box_w = 22, .box_h = 23, .ofs_x = 1, .ofs_y = -5},
    {.bitmap_index = 2480, .adv_w = 257, .box_w = 16, .box_h = 18, .ofs_x = 0, .ofs_y = 0},
    {.bitmap_index = 2624, .adv_w = 248, .box_w = 14, .box_h = 18, .ofs_x = 1, .ofs_y = 0},
    {.bitmap_index = 2750, .adv_w = 279, .box_w = 16, .box_h = 18, .ofs_x = 1, .ofs_y = 0},
    {.bitmap_index = 2894, .adv_w = 270, .box_w = 15, .box_h = 18, .ofs_x = 1, .ofs_y = 0},
    {.bitmap_index = 3029, .adv_w = 226, .box_w = 12, .box_h = 18, .ofs_x = 1, .ofs_y = 0},
    {.bitmap_index = 3137, .adv_w = 219, .box_w = 12, .box_h = 18, .ofs_x = 1, .ofs_y = 0},
    {.bitmap_index = 3245, .adv_w = 283, .box_w = 16, .box_h = 18, .ofs_x = 1, .ofs_y = 0},
    {.bitmap_index = 3389, .adv_w = 278, .box_w = 15, .box_h = 18, .ofs_x = 1, .ofs_y = 0},
    {.bitmap_index = 3524, .adv_w = 95, .box_w = 4, .box_h = 18, .ofs_x = 1, .ofs_y = 0},
    {.bitmap_index = 3560, .adv_w = 212, .box_w = 11, .box_h = 18, .ofs_x = 1, .ofs_y = 0},
    {.bitmap_index = 3659, .adv_w = 250, .box_w = 15, .box_h = 18, .ofs_x = 1, .ofs_y = 0},
    {.bitmap_index = 3794, .adv_w = 211, .box_w = 12, .box_h = 18, .ofs_x = 1, .ofs_y = 0},
    {.bitmap_index = 3902, .adv_w = 337, .box_w = 19, .box_h = 18, .ofs_x = 1, .ofs_y = 0},
    {.bitmap_index = 4073, .adv_w = 280, .box_w = 15, .box_h = 18, .ofs_x = 1, .ofs_y = 0},
    {.bitmap_index = 4208, .adv_w = 290, .box_w = 16, .box_h = 18, .ofs_x = 1, .ofs_y = 0},
    {.bitmap_index = 4352, .adv_w = 239, .box_w = 13, .box_h = 18, .ofs_x = 1, .ofs_y = 0},
    {.bitmap_index = 4469, .adv_w = 290, .box_w = 16, .box_h = 20, .ofs_x = 1, .ofs_y = -2},
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
    {.bitmap_index = 8770, .adv_w = 290, .box_w = 16, .box_h = 23, .ofs_x = 1, .ofs_y = 0},
    {.bitmap_index = 8954, .adv_w = 277, .box_w = 15, .box_h = 23, .ofs_x = 1, .ofs_y = 0},
    {.bitmap_index = 9127, .adv_w = 209, .box_w = 12, .box_h = 18, .ofs_x = 1, .ofs_y = -5},
    {.bitmap_index = 9235, .adv_w = 219, .box_w = 12, .box_h = 18, .ofs_x = 1, .ofs_y = 0},
    {.bitmap_index = 9343, .adv_w = 218, .box_w = 11, .box_h = 18, .ofs_x = 1, .ofs_y = 0},
    {.bitmap_index = 9442, .adv_w = 283, .box_w = 16, .box_h = 23, .ofs_x = 1, .ofs_y = 0},
    {.bitmap_index = 9626, .adv_w = 225, .box_w = 12, .box_h = 23, .ofs_x = 1, .ofs_y = -5},
    {.bitmap_index = 9764, .adv_w = 95, .box_w = 4, .box_h = 23, .ofs_x = 1, .ofs_y = 0},
    {.bitmap_index = 9810, .adv_w = 85, .box_w = 3, .box_h = 13, .ofs_x = 1, .ofs_y = 0},
    {.bitmap_index = 9830, .adv_w = 241, .box_w = 13, .box_h = 23, .ofs_x = 1, .ofs_y = -5},
    {.bitmap_index = 9980, .adv_w = 191, .box_w = 10, .box_h = 18, .ofs_x = 1, .ofs_y = -5}
};

/*---------------------
 *  CHARACTER MAPPING
 *--------------------*/

static const uint16_t unicode_list_3[] = {
    0x0, 0xf, 0x15, 0x20, 0x2f, 0x35, 0x57, 0x58,
    0x69, 0x6a, 0x97, 0x98
};

/*Collect the unicode lists and glyph_id offsets*/
static const lv_font_fmt_txt_cmap_t cmaps[] =
{
    {
        .range_start = 33, .range_length = 2, .glyph_id_start = 1,
        .unicode_list = NULL, .glyph_id_ofs_list = NULL, .list_length = 0, .type = LV_FONT_FMT_TXT_CMAP_FORMAT0_TINY
    },
    {
        .range_start = 37, .range_length = 59, .glyph_id_start = 3,
        .unicode_list = NULL, .glyph_id_ofs_list = NULL, .list_length = 0, .type = LV_FONT_FMT_TXT_CMAP_FORMAT0_TINY
    },
    {
        .range_start = 97, .range_length = 30, .glyph_id_start = 62,
        .unicode_list = NULL, .glyph_id_ofs_list = NULL, .list_length = 0, .type = LV_FONT_FMT_TXT_CMAP_FORMAT0_TINY
    },
    {
        .range_start = 199, .range_length = 153, .glyph_id_start = 92,
        .unicode_list = unicode_list_3, .glyph_id_ofs_list = NULL, .list_length = 12, .type = LV_FONT_FMT_TXT_CMAP_SPARSE_TINY
    }
};

/*-----------------
 *    KERNING
 *----------------*/


/*Pair left and right glyphs for kerning*/
static const uint8_t kern_pair_glyph_ids[] =
{
    2, 4,
    2, 10,
    2, 12,
    2, 18,
    4, 2,
    4, 5,
    4, 58,
    5, 4,
    5, 10,
    5, 12,
    5, 18,
    8, 4,
    8, 10,
    8, 12,
    8, 18,
    8, 30,
    8, 61,
    9, 16,
    9, 17,
    9, 21,
    9, 58,
    10, 2,
    10, 5,
    10, 14,
    10, 15,
    10, 16,
    10, 17,
    10, 19,
    10, 20,
    10, 21,
    10, 22,
    10, 23,
    10, 29,
    10, 30,
    11, 16,
    11, 17,
    11, 21,
    11, 58,
    12, 2,
    12, 5,
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
};

/* Kerning between the respective left and right glyphs
 * 4.4 format which needs to scaled with `kern_scale`*/
static const int8_t kern_pair_values[] =
{
    -13, -31, -31, -24, -13, -13, -24, -13,
    -31, -31, -24, -13, -52, -52, -17, -2,
    -26, -13, -4, -9, -19, -31, -31, -10,
    -36, 1, -7, -5, -10, -5, -6, -3,
    -45, -17, -13, -4, -9, -19, -31, -31,
    -10, -36, 1, -7, -5, -10, -5, -6,
    -3, -45, -17, -15, -15, -10, -10, -7,
    -7, -17, -6, -9, -9, -9, -9, -13,
    -13, -13, -12, -8, -13, -4, -10, -10,
    -4, -4, -11, -11, -17, 2, -17, 4,
    -48, -48, -6, -6, -22, -4, -6, 8,
    -5, -4, -13, -13, -35, 4, -61, -9,
    -9, -9, -9, -10, -10, -7, -7, -17,
    -24, -24, -26, -28, -28, -17, -17, -15,
    -13, -15, -30, -30, -30, -13, -13, 8,
    -5, -22, -5, -19, -24, -12, -18, -30,
    -13, -13, -52, -52, -17, -2, -26, -26,
    -17, -41, -17, -22, -17, -17, -17, -17,
    -15, -30, -26, 6, -13, -4, -9, -19
};

/*Collect the kern pair's data in one place*/
static const lv_font_fmt_txt_kern_pair_t kern_pairs =
{
    .glyph_ids = kern_pair_glyph_ids,
    .values = kern_pair_values,
    .pair_cnt = 152,
    .glyph_ids_size = 0
};

/*--------------------
 *  ALL CUSTOM DATA
 *--------------------*/

#if LVGL_VERSION_MAJOR == 8
/*Store all the custom data of the font*/
static  lv_font_fmt_txt_glyph_cache_t cache;
#endif

#if LVGL_VERSION_MAJOR >= 8
static const lv_font_fmt_txt_dsc_t font_dsc = {
#else
static lv_font_fmt_txt_dsc_t font_dsc = {
#endif
    .glyph_bitmap = glyph_bitmap,
    .glyph_dsc = glyph_dsc,
    .cmaps = cmaps,
    .kern_dsc = &kern_pairs,
    .kern_scale = 16,
    .cmap_num = 4,
    .bpp = 4,
    .kern_classes = 0,
    .bitmap_format = 0,
#if LVGL_VERSION_MAJOR == 8
    .cache = &cache
#endif

};

extern const lv_font_t lv_font_montserrat_24;


/*-----------------
 *  PUBLIC FONT
 *----------------*/

/*Initialize a public general font descriptor*/
#if LVGL_VERSION_MAJOR >= 8
const lv_font_t lv_font_inter_24 = {
#else
lv_font_t lv_font_inter_24 = {
#endif
    .get_glyph_dsc = lv_font_get_glyph_dsc_fmt_txt,    /*Function pointer to get glyph's data*/
    .get_glyph_bitmap = lv_font_get_bitmap_fmt_txt,    /*Function pointer to get glyph's bitmap*/
    .line_height = 29,          /*The maximum line height required by the font*/
    .base_line = 6,             /*Baseline measured from the bottom of the line*/
#if !(LVGL_VERSION_MAJOR == 6 && LVGL_VERSION_MINOR == 0)
    .subpx = LV_FONT_SUBPX_NONE,
#endif
#if LV_VERSION_CHECK(7, 4, 0) || LVGL_VERSION_MAJOR >= 8
    .underline_position = -3,
    .underline_thickness = 2,
#endif
    .dsc = &font_dsc,          /*The custom font data. Will be accessed by `get_glyph_bitmap/dsc` */
#if LV_VERSION_CHECK(8, 2, 0) || LVGL_VERSION_MAJOR >= 9
    .fallback = &lv_font_montserrat_24,
#endif
    .user_data = NULL,
};



#endif /*#if LV_FONT_INTER_24*/
