omerkaraoglu/3D-Print-Annealer/(commit log)

2026-04-10 Rev 1.2 KiCad design update with fan/relay control, BOM and gerber outputs
    [3dFilamentDryer-B_Paste.gbr, 3dFilamentDryer-CuBottom.gbr, 3dFilamentDryer-CuTop.gbr, 3dFilamentDryer-EdgeCuts.gbr, 3dFilamentDryer-F_Paste.gbr, 3dFilamentDryer-MaskBottom.gbr, 3dFilamentDryer-MaskTop.gbr, 3dFilamentDryer-NPTH.drl]
2026-04-13 PCB fix
    [3dFilamentDryer-B_Paste.gbr, 3dFilamentDryer-CuBottom.gbr, 3dFilamentDryer-CuTop.gbr, 3dFilamentDryer-EdgeCuts.gbr, 3dFilamentDryer-F_Paste.gbr, 3dFilamentDryer-MaskBottom.gbr, 3dFilamentDryer-MaskTop.gbr, 3dFilamentDryer-NPTH.drl]
2026-04-27 OTA without CA, factory reset & restore defaults settings added
    [partitions.csv]
2026-06-10 Firmware v2.1.2 Hardware Rev2
    [3dFilamentDryer-B_Cu.gbl, 3dFilamentDryer-B_Mask.gbs, 3dFilamentDryer-B_Paste.gbp, 3dFilamentDryer-B_Silkscreen.gbo, 3dFilamentDryer-CuBottom.gbr, 3dFilamentDryer-CuTop.gbr, 3dFilamentDryer-EdgeCuts.gbr, 3dFilamentDryer-Edge_Cuts.gm1]
